jlcjak/neurband/README.md

# neurband

**An open, minimal sEMG wristband, like the Meta Neural Band.** Eight bipolar surface-EMG channels around the
wrist, a 24-bit biopotential front end, Bluetooth LE, and a module the size of a small watch face — designed
from first principles to record data good enough to train gesture models, and cheap enough to just build.

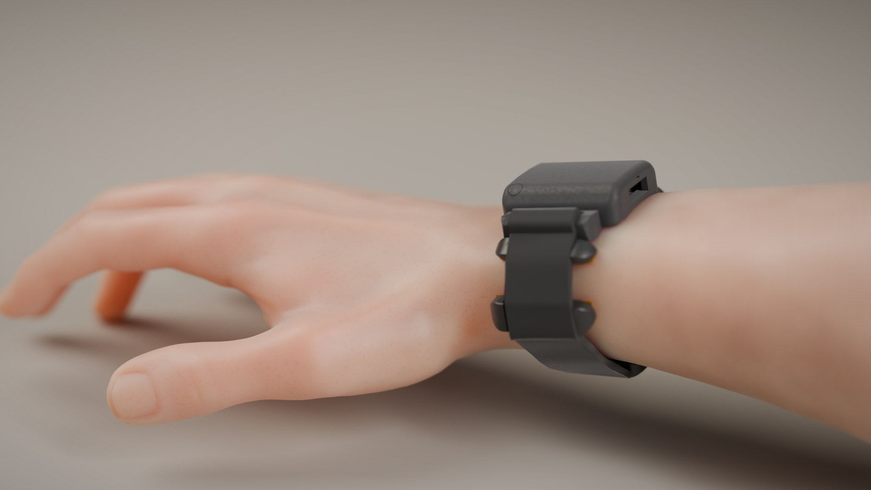
[picture p1: docs/media/hero_arm_wide_r2.jpg]
neurband on the wrist


> **Status: design complete, not yet built.** Schematics, both PCBs (DRC-clean), mechanics, firmware
> (builds and links, untested on hardware), recorder and analysis code are done; everything below that says
> "simulated" or "estimated" has not been measured on a real board yet. See [what's next](#status-and-next-steps).

| | |
|---|---|
| Channels | 8 bipolar (P–N 20 mm along the forearm) + a driven bias pad in every pod |
| Front end | TI ADS1298, 24 bit, gain 6, 4 kSPS acquisition, ~1.2 µVrms (20–850 Hz) |
| Electrodes | 24 dry 6.5 mm ENIG gold pads on a 2-layer polyimide flex, foam-backed, 1 mm proud |
| Radio | nRF52832, BLE 5 2M PHY, printed antenna; 2 kSPS × 8 ch, 16-bit stream |
| IMU | LSM6DSL accel + gyro, 208 Hz |
| Power | 401223-class LiPo, about 130 mAh, ~12 h streaming (estimate); 2-pin magnetic charging connector in the module's end wall (charge with the band off the wrist) |
| Module | 31.6 × 37.1 × 9.65 mm body (48 mm across the strap bars), tapered and crowned, one size for 145–180 mm wrists |
| Strap | 20 mm hook-and-loop watch strap through two thick bars moulded into the base; the electrode pods snap onto it |
| Cost | ≈ $290–350 for a first build: 5 boards (2 assembled), 5 flexes, prints and off-the-shelf parts ([breakdown](docs/rev_c/cost.md)) |

## Gallery

| | |
|---|---|
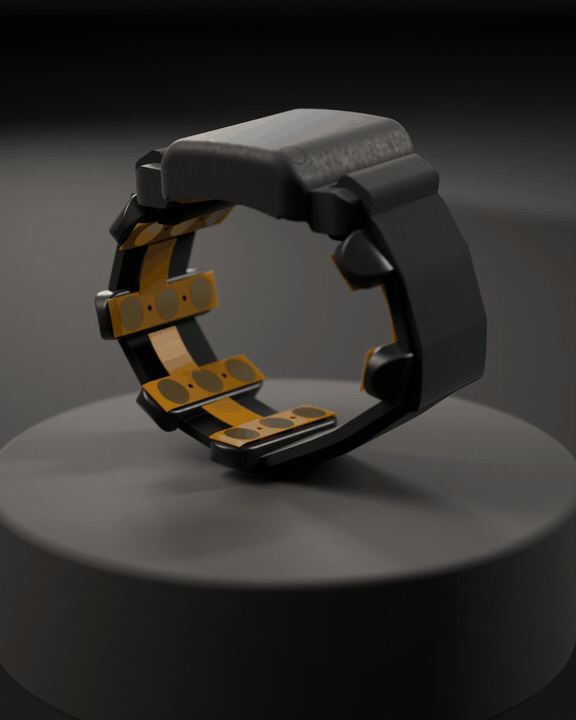
[picture p2: docs/media/turntable_r2.gif]
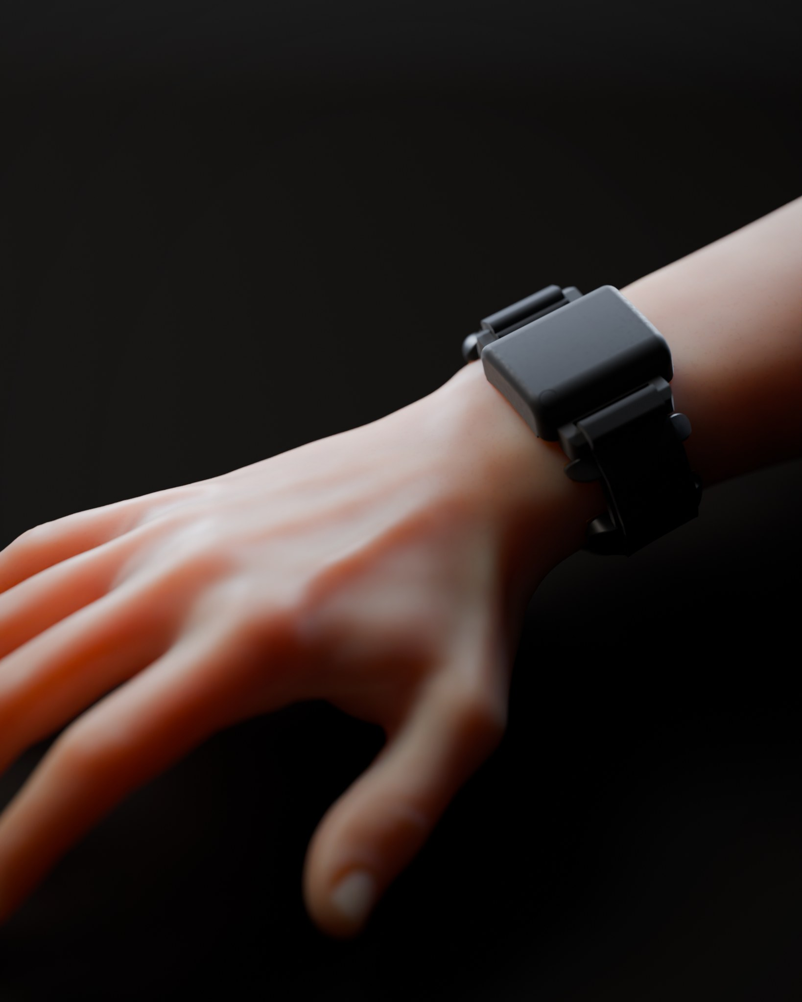
[picture p3: docs/media/hero_dark_r2.jpg]
|  |  |
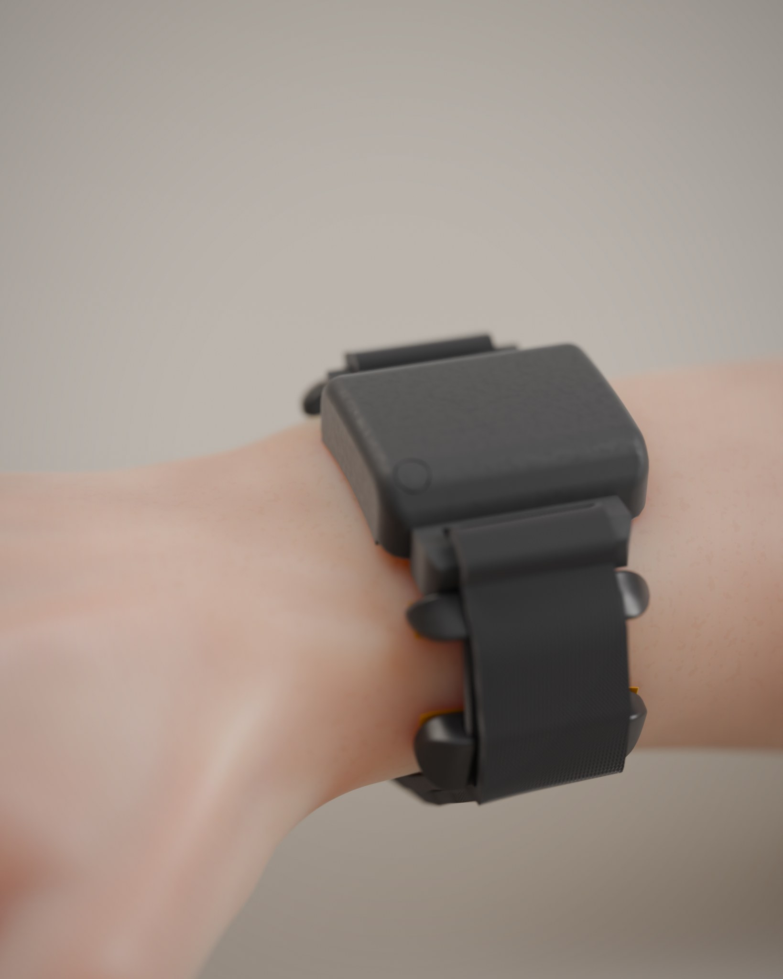
[picture p4: docs/media/hero_crop_r2.jpg]
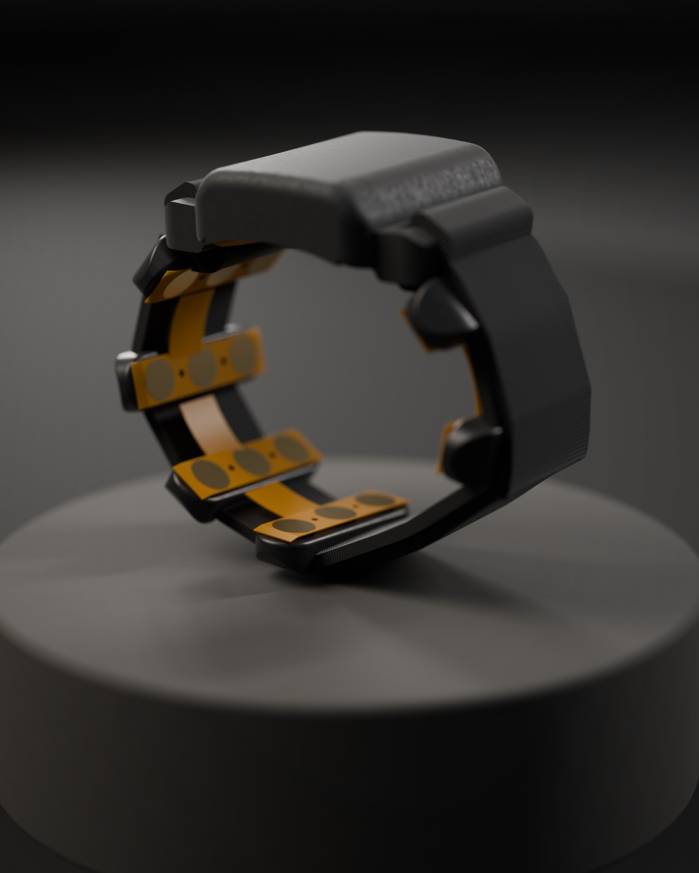
[picture p5: docs/media/band_product_r2.jpg]
|  |  |
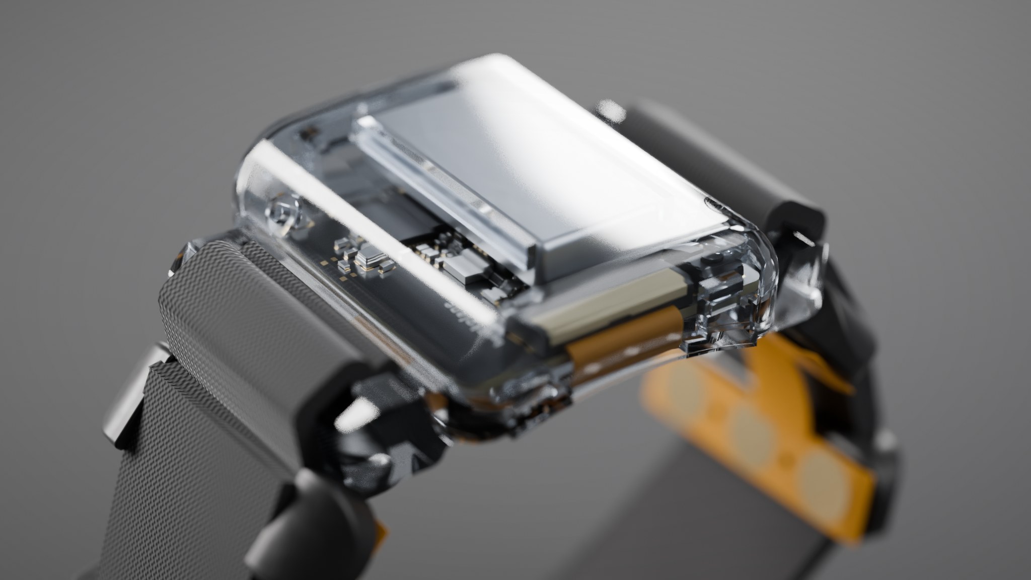
[picture p6: docs/media/xray_r2.jpg]
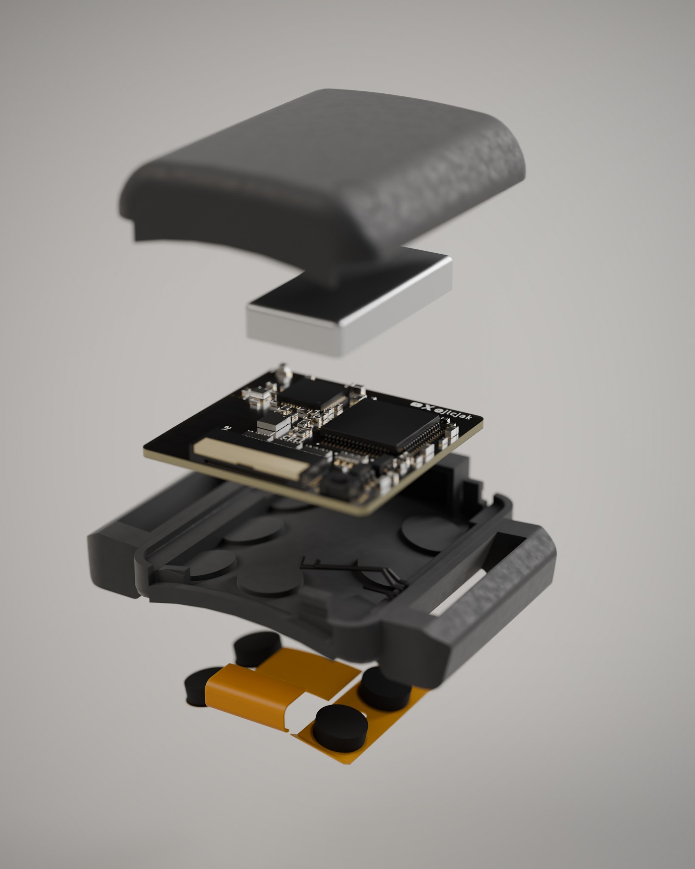
[picture p7: docs/media/exploded_r2.jpg]
|  |  |
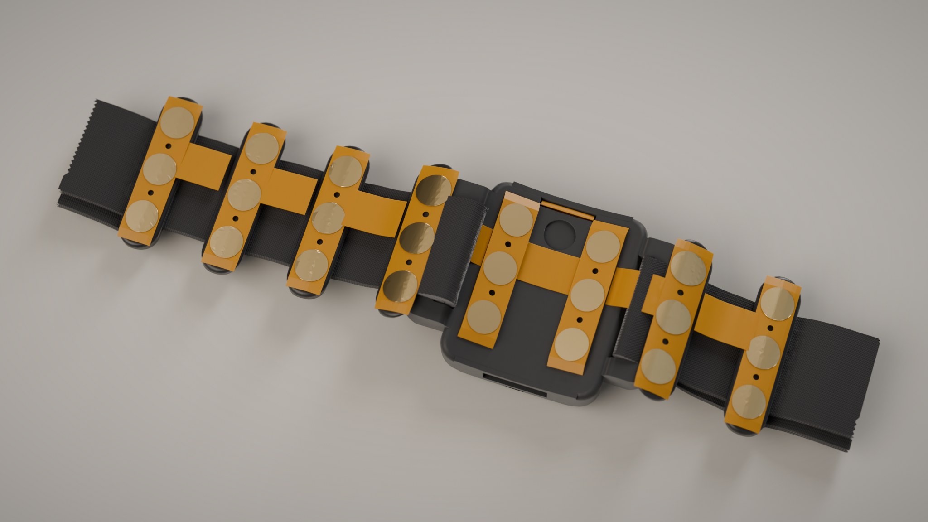
[picture p8: docs/media/flatlay_r2.jpg]
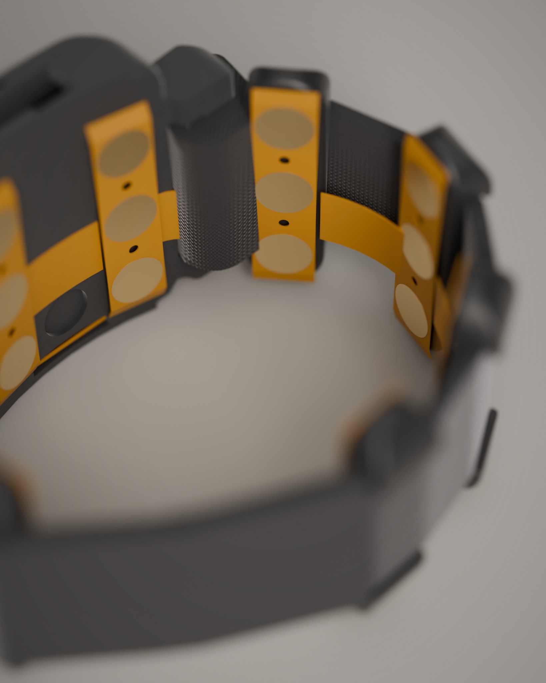
[picture p9: docs/media/pods_inside_r2.jpg]
|  |  |
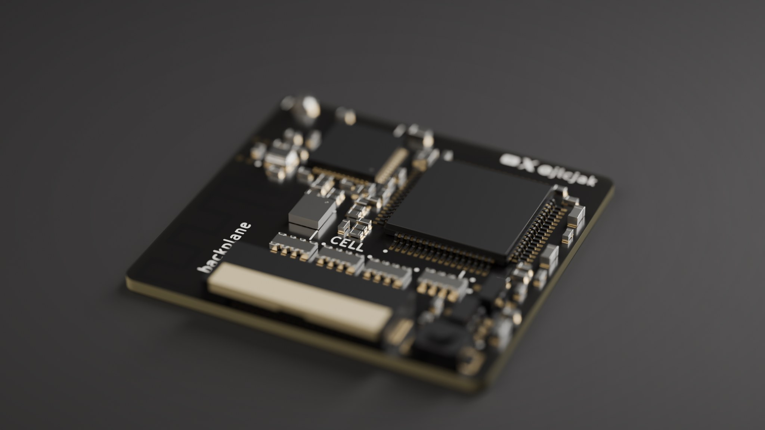
[picture p10: docs/media/pcb_top_r2.jpg]
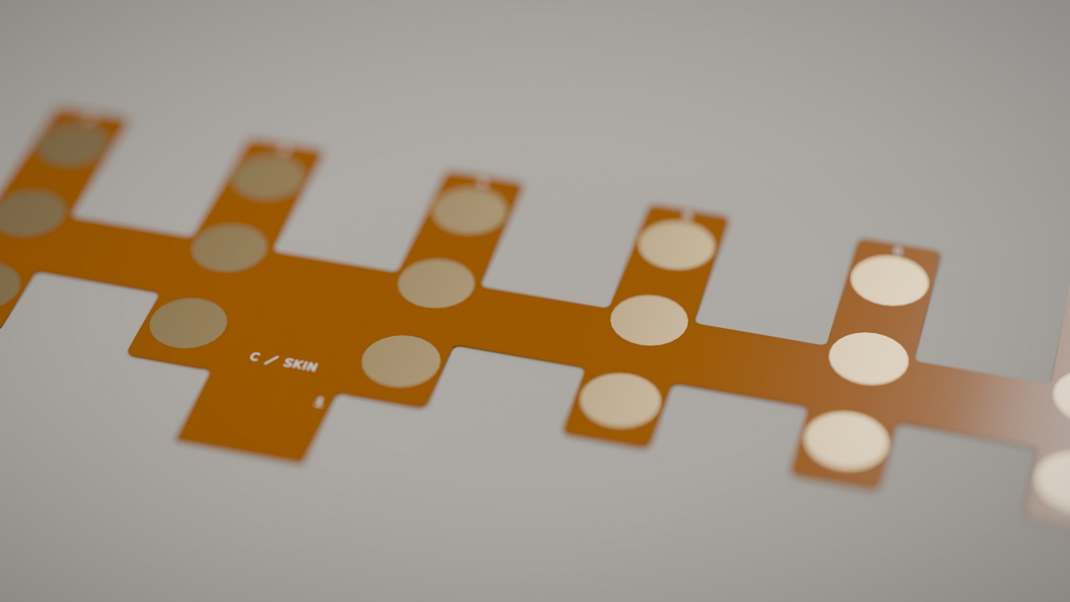
[picture p11: docs/media/flex_detail_r2.jpg]
|  |  |

The boards as laid out (KiCad renders, main board top and bottom; 28.7 × 27 mm):

| | |
|---|---|
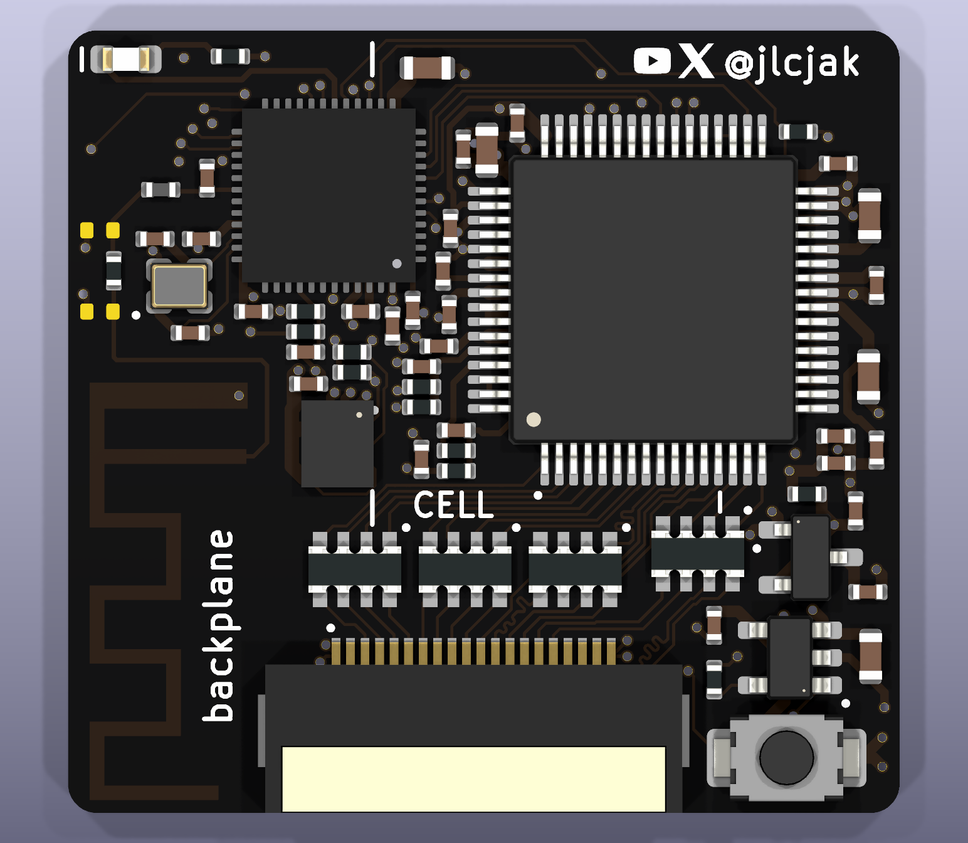
[picture p12: docs/media/board_top_r2.png]
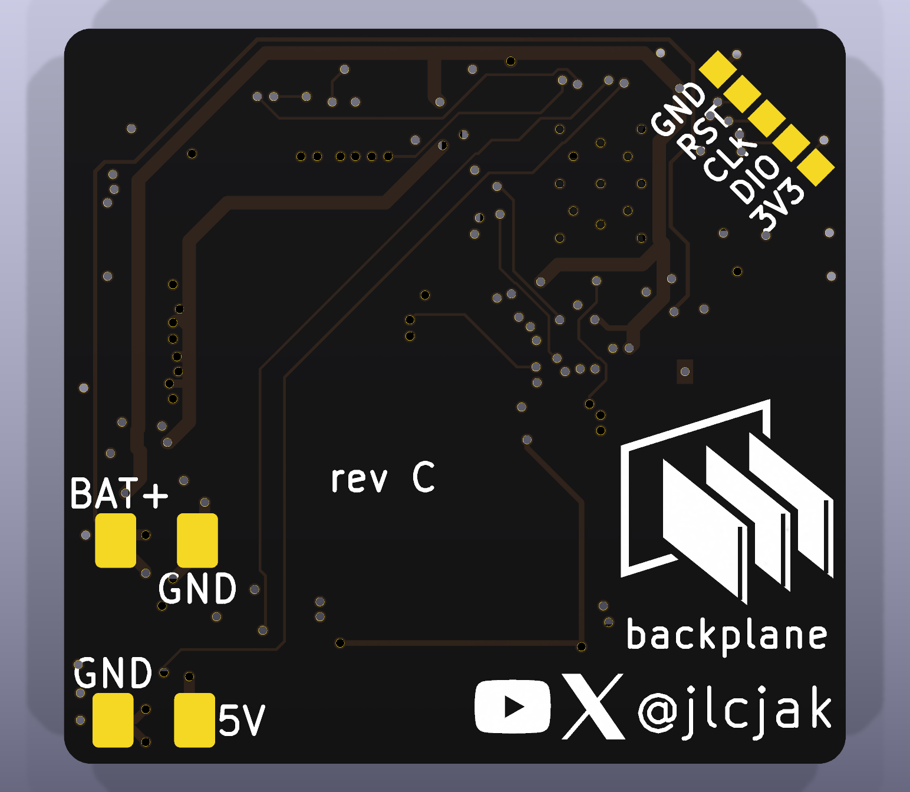
[picture p13: docs/media/board_bottom_r2.png]
|  |  |

All four copper layers (`python3 tools/copper_layers.py`):

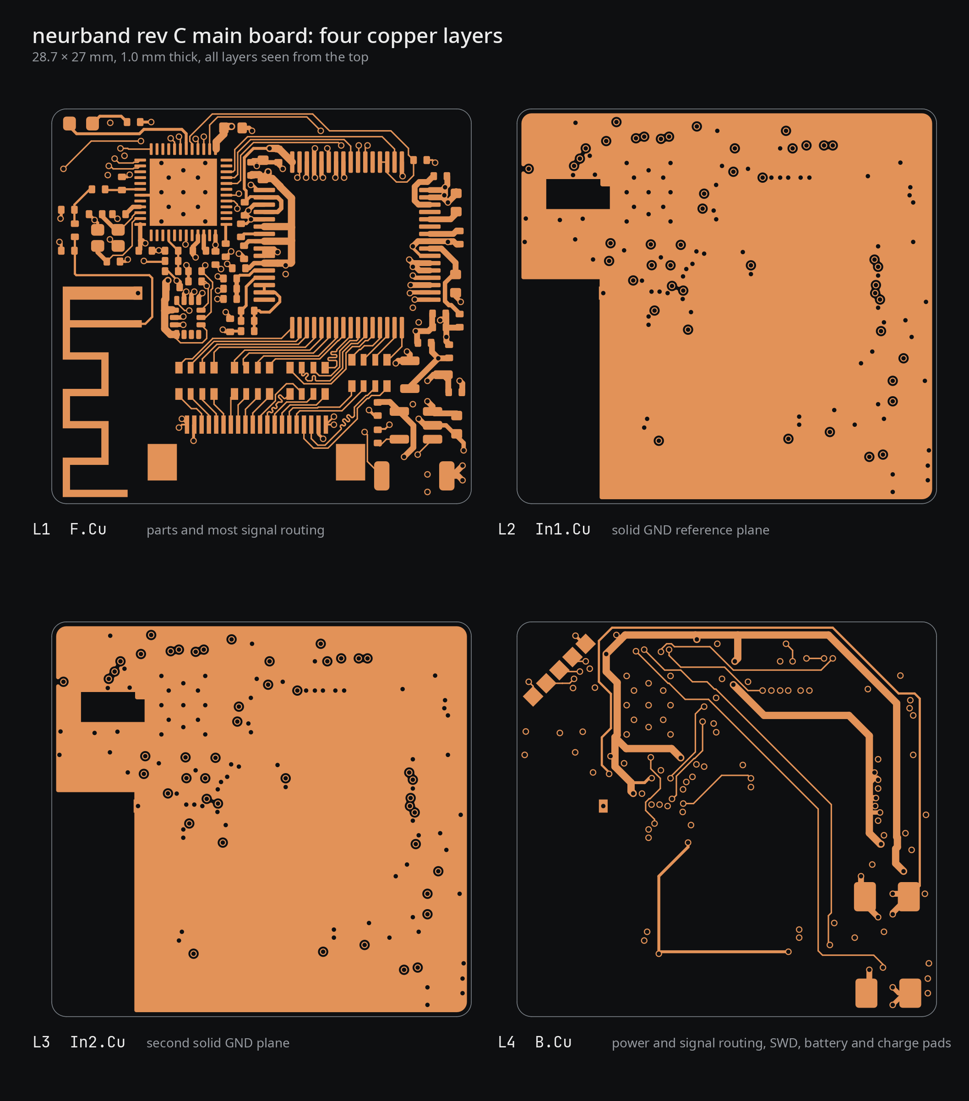
[picture p14: docs/media/board_layers_r2.png]
four copper layers of the main board


A 1080 × 1350 turntable video is in [docs/media/turntable_r2.mp4](docs/media/turntable_r2.mp4).
All images are rendered from the real CAD and KiCad files with `python3 render/make_renders.py` (Blender Cycles);
see [docs/renders.md](docs/renders.md).

## How it works

```
 skin ─ 8 pods × (P, bias, N) gold pads ─ polyimide flex (GND-shielded) ─ 20-pin FPC
   └─ main board 28.7 × 27 mm, 4 layers, one-sided assembly
        ADS1298 ─ 16 × 10 kΩ inputs, bias amp (1 MΩ‖4.7 nF → all middle pads), filtered AVDD/2 reference
          │ SPI
        nRF52832 ─ printed 2.4 GHz antenna ─ BLE ─► nRF52840 USB dongle ─► host/neurband_ble.py ─► .npz
          ├ LSM6DSL IMU, button (wake/marker), LED
        LiPo ─ XC6206 3.3 V ─ RC filter ─ AVDD          magnetic charge connector ─ TP4054
```

Like Meta's research band (*A generic non-invasive neuromotor interface for
human-computer interaction*, Nature 2025), it has what matters: bipolar gold contacts 20 mm apart along the forearm, µV-level noise,
2 kHz data. It drops what only costs money: per-pod amplifiers, 16 channels, custom electrodes.
The reasoning, decision by decision, is in [docs/rev_c/README.md](docs/rev_c/README.md).

## The science, checked before building

Four independent reviews and simulations went into this design:

- **Signal chain** ([docs/science/signal_chain.md](docs/science/signal_chain.md)): noise budget, dry-contact
  impedance, mains pickup, sampling and BLE throughput, with pass/fail bench gates.
- **Circuit simulation** ([docs/science/simulations.md](docs/science/simulations.md), ngspice): bias-loop
  stability (57° worst-case phase margin), mains residual (≤ 1.5 µV on battery), RF filtering, radio-burst
  coupling — which is why the bias reference is filtered.
- **Forearm volume-conductor model** ([docs/science/emg_forward_model.md](docs/science/emg_forward_model.md)):
  a 3-D finite-difference model of the distal forearm (bones, muscles, fat, skin, anisotropic muscle), lead
  fields of all 8 channels, travelling motor-unit action potentials. 8 channels separate single muscles at
  98–100 %; pad size, spacing and band rotation are quantified.
- **Data & models** ([docs/science/data_and_models.md](docs/science/data_and_models.md)): what 8-channel wrist
  EMG can decode, how to use Meta's open datasets, a first-week recording protocol, and a working pipeline.

| | |
|---|---|
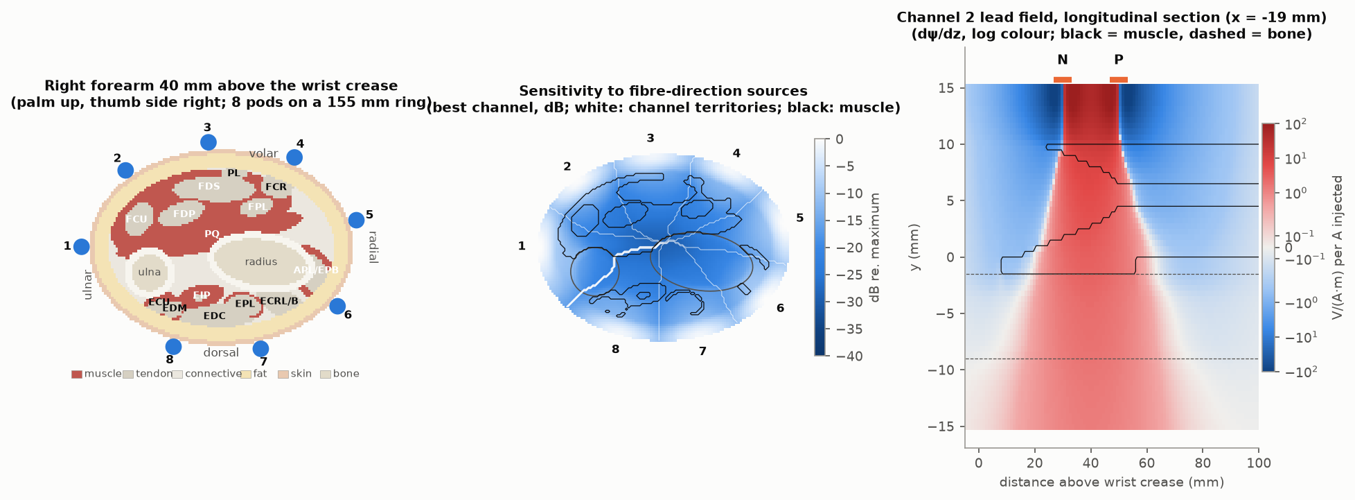
[picture p15: docs/science/figures/emgfwd_cross_section.png]
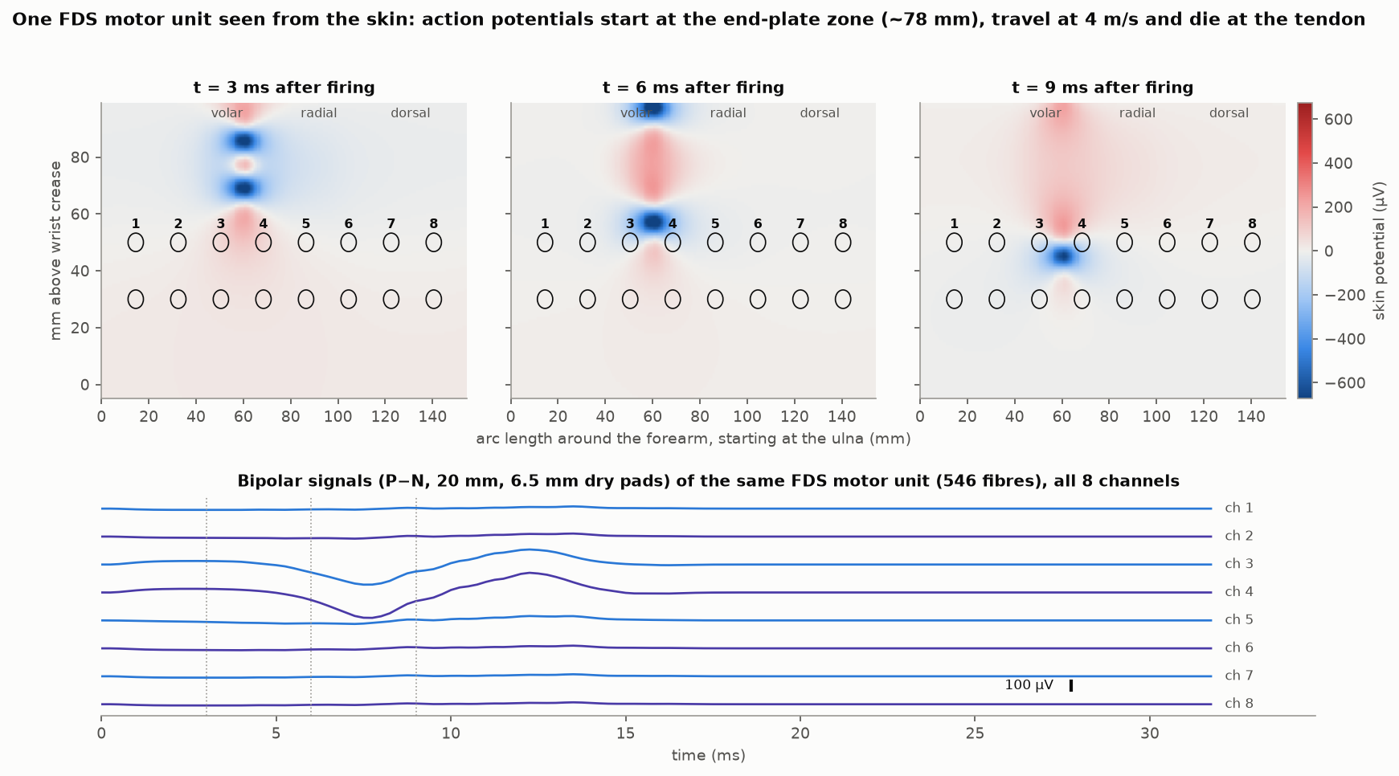
[picture p16: docs/science/figures/emgfwd_skin_map.png]
|  |  |

**Honest expectations** (per user, with calibration): 6–8 hand/wrist postures at ~90–98 %, pinches and thumb
swipes at ~75–90 %, 2-axis wrist control. Not expected: models that work across people without calibration,
typing, fluent handwriting.

## Build one

**Build guide: [docs/build/assembly.md](docs/build/assembly.md)**: the shopping list, the prints, ten
illustrated steps, troubleshooting and the tests to run on a first band (also as a
[PDF](docs/build/neurband_build_manual.pdf)). There is also a 36 s
[assembly animation](docs/media/assembly_r2.mp4).

A first prototype costs around $300 (≈ $290–350 for five main boards with two assembled, five electrode flexes,
the prints and the off-the-shelf parts; [breakdown](docs/rev_c/cost.md)). Most of it is the ADS1298 and the
fab's assembly fees.

1. **Order** two things:
   - the assembled main board, the electrode flex and the prints, with **Buy it** in Backplane
     (`boards/neurband_c/ORDERING.md`, `boards/neurband_c_flex/ORDERING.md`, `mech/rev_c/*.fab.json`);
   - about EUR 75 of off-the-shelf parts ([docs/build/sourcing.md](docs/build/sourcing.md)): a 20 mm
     hook-and-loop watch strap, 6 mm foam dots, a 401223 LiPo, a 2-pin magnetic charging connector and
     cable, a Pico 2 as the SWD probe and an nRF52840 dongle.
2. **Build** it ([docs/build/assembly.md](docs/build/assembly.md), PDF alongside):
   - flash the bare board once through four soldered wires on the SWD pads (3V3, SWDIO, SWDCLK, GND);
   - solder the cell and the charging connector;
   - bond the six free pods in the flat jig and the base in the pedestal jig;
   - fold the tail into J1 and close the module;
   - snap the strap into the pods, lock one end on bar A, tighten through bar B.

   Design details are in [docs/mech/mechanical_c.md](docs/mech/mechanical_c.md).
3. **Record**: `python3 host/neurband_ble.py -o rec.npz`, and in a second terminal
   `python3 -m analysis collect basic --out data/s1`.
4. **Check and train**: `python3 -m analysis report data/*.npz`, `python3 -m analysis train data/*.npz`.
   Try the whole pipeline without hardware: `python3 -m analysis synth /tmp/nb`.

**Safety.** Wear it only while it runs on its own battery. Never connect a charger, USB cable, debugger or
grounded instrument while the pads touch skin. This is a research prototype, not a medical device.

## Repository

| Path | What |
|---|---|
| `boards/neurband_c/` | main board: schematic generator (`gen_c_sch.py`), KiCad project, layout scripts |
| `boards/neurband_c_flex/` | electrode flex: schematic + parametric PCB generator |
| `mech/rev_c/` | FreeCAD scripts and STEP for the module, pods, strap path, bonding jigs and fit checks |
| `firmware_c/` | nRF52832 Zephyr firmware |
| `host/` | BLE recorder and packet tests |
| `analysis/` | quality gates, features, baseline models, collection prompts, Meta dataset reader |
| `sim/` | ngspice AFE simulations and the forearm EMG forward model |
| `render/` | Blender pipeline for the images (`python3 render/make_renders.py`) |
| `docs/` | design notes, reviews, science, layout and mechanical docs |
| `.archive/` | older work (a dot-folder, so Backplane's project list skips it): rev A (16 ch, ESP32, 54 × 34 mm) and rev B boards, rev A/B mechanics, the rev C layout scripts |
| `tools/` | the small Python KiCad schematic generator used for every schematic |

## Status and next steps

- [x] Rev C schematic, main board (DRC 0), flex (DRC 0), mechanics, fit checks on 145/160/180 mm wrists
- [x] Firmware builds and links for the nRF52832 (Zephyr 4.4.2, 0 warnings, 30 % flash / 94 % RAM); host recorder and analysis pipeline tested on synthetic data
- [x] Pre-order review and rework: analog coupling/noise ([analog_preorder_review.md](docs/review/analog_preorder_review.md)), on-wrist antenna FDTD simulation ([antenna_sim.md](docs/science/antenna_sim.md)), manufacturing and pick-and-place check against the fab's own footprints ([manufacturing_preorder.md](docs/review/manufacturing_preorder.md)), layout owner's review ([sol_preorder_review.md](docs/review/sol_preorder_review.md)), assembly walk-through ([assembly.md](docs/build/assembly.md))
- [ ] Build two boards; bench gates: shorted-input noise, mains residual, radio-on noise, bias-loop stability
- [ ] Antenna tuning (π network on the board), BLE throughput on a real link
- [ ] First week of recordings with the protocol in `docs/science/data_and_models.md`

## Credits

Research summary of Meta's work in [docs/research/meta_semg_research.md](docs/research/meta_semg_research.md).
Human model: Blender Studio "Human Base Meshes" (CC0). KiCad stock libraries. Meta's datasets referenced here are
CC BY-NC 4.0.
