jlcjak/neurband/boards/neurband_c_flex/README.md

# Electrode flex, rev C

| File | What it is |
|---|---|
| `neurband_c_flex.kicad_pro` / `.kicad_pcb` / `.kicad_sch` | The KiCad project (generated) |
| `gen_flex_c_pcb.py`, `gen_flex_c_sch.py`, `flex_pinmap.py`, `requirements.txt` | The generators and the pod-to-finger map; edit these, not the board |
| `ORDERING.md` | What the flex order must be (ordered with **Buy it**; `neurband_c_flex.fab.json` is `kind: flex`) |
| `neurband_c_flex.step`, `renders/` | 3D model and images |
| `neurband_c_flex.pretty`, `.kicad_dru`, `fp-lib-table` | Footprints and design rules the board needs |

Layout notes: [docs/layout/flex_c_layout.md](../../docs/layout/flex_c_layout.md).
