jlcjak/neurband/boards/neurband_c_old/README.md

# Main board rev C, routed by the layout owner (reference copy)

The routed, reviewed rev C main board (SHA-256 `ff1ad4d2…35b6`) kept for reference while
`boards/neurband_c` is re-routed by hand. Same schematic, placement and footprints. Not for ordering
(no fab file); the reviews in `docs/review/` and `docs/layout/main_c_layout.md` describe this board.
