jlcjak/neurband/.archive/neurband_main_revA/layout/esp_footprint_review.md

# ESP32-S3-MINI-1-N8 footprint review

## Result

The installed `RF_Module:ESP32-S2-MINI-1` has the correct S3 pad geometry and numbering, but is **not an exact mechanical/antenna match**. Its fabricated body is 15.4 × 20.0 mm, whereas ESP32-S3-MINI-1-N8 is 15.4 × 20.5 × 2.4 mm (body XY tolerance ±0.2 mm). Its antenna keepout stops 0.5 mm short of a 15 mm forward clearance measured from the S3 body tip. Use the standalone `neurband.pretty/ESP32-S3-MINI-1-N8.kicad_mod` in this directory. Canonical PCB and schematic were not edited.

Source footprint inspected: `$KICAD_ROOT/share/kicad/footprints/RF_Module.pretty/ESP32-S2-MINI-1.kicad_mod`. Its description incorrectly calls this an external-antenna module; MINI-1 has an onboard PCB antenna, MINI-1U has an external connector.

## Exact local geometry

Millimetres, top view, zero footprint rotation, +X right, +Y down. Retain the stock origin and all pads; the module is not geometrically centered about this origin.

| Feature | Local coordinates / dimensions |
| --- | --- |
| S3 nominal body | X = −7.7…+7.7; Y = −10.25…+10.25 |
| Antenna area (datasheet Fig. 11-1, 5.05 mm deep) | X = −7.7…+7.7; Y = −10.25…−5.20 |
| Pads 1…15, left | X = −7; Y = −3.40 + 0.85 × (pin−1); 0.8 × 0.4 |
| Pads 16…30, bottom | X = −5.95 + 0.85 × (pin−16); Y = 9.55; 0.4 × 0.8 in XY |
| Pads 31…45, right | X = +7; Y = 8.50 − 0.85 × (pin−31); 0.8 × 0.4 |
| Pads 46…60, top | X = 5.95 − 0.85 × (pin−46); Y = −4.45; 0.4 × 0.8 in XY |
| Pad 61, exposed ground | Nine 1.2 × 1.2 islands; X ∈ {−1.65, 0, +1.65}; Y ∈ {0.90, 2.55, 4.20}; upper-left island chamfered |
| Pads 62, 63, 64, 65, ground corners | (−7, −4.45), (−7, 9.55), (+7, 9.55), (+7, −4.45); each 0.8 × 0.8 |
| All-layer antenna rule area | X = −22.70…+22.70; Y = −25.25…−5.20 |

There are **65 numbered electrical pins and 73 physical SMD pad objects**: 60 narrow perimeter pads + 4 square ground corners + 9 islands sharing number 61. This matches datasheet Figs. 3-1 and 11-1. All top-edge pins 46…60 are GND; corners 62…65 and EP 61 are also GND. Example numbering anchors: 1/2 GND, 3 3V3, 4 IO0, 45 EN. Physical compatibility does not imply S2 and S3 GPIO functions are interchangeable.
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
