jlcjak/neurband/boards/neurband_c/layout/XUNPU_FPC-05F-20PH20.png

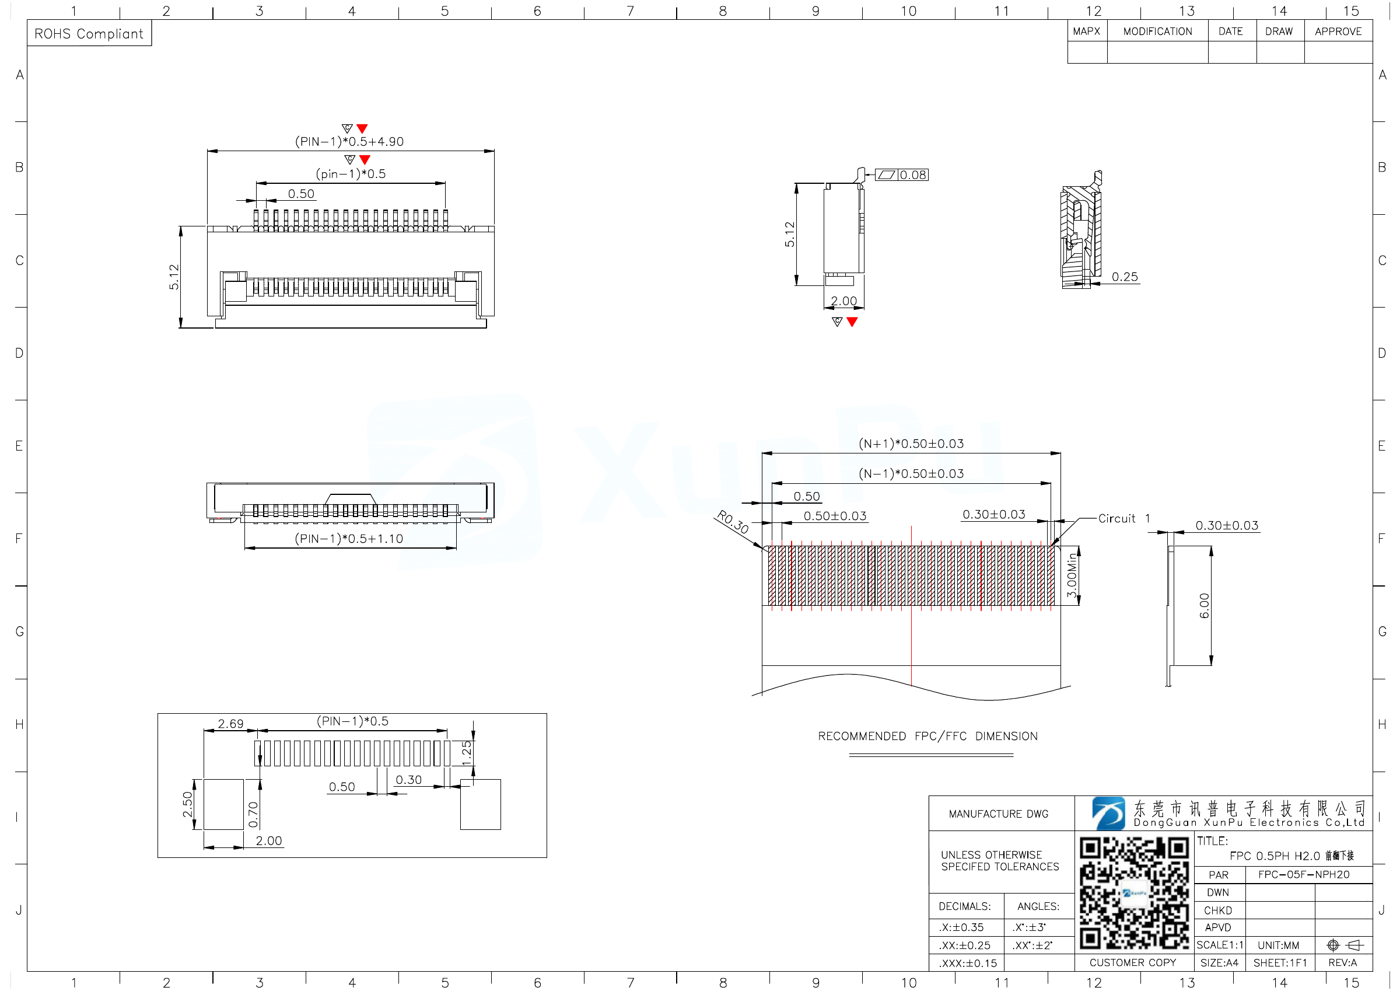
boards/neurband_c/layout/XUNPU_FPC-05F-20PH20.png
