jlcjak/neurband/boards/neurband_c/layout/XUNPU_FPC-05F-20PH20_footprint.png

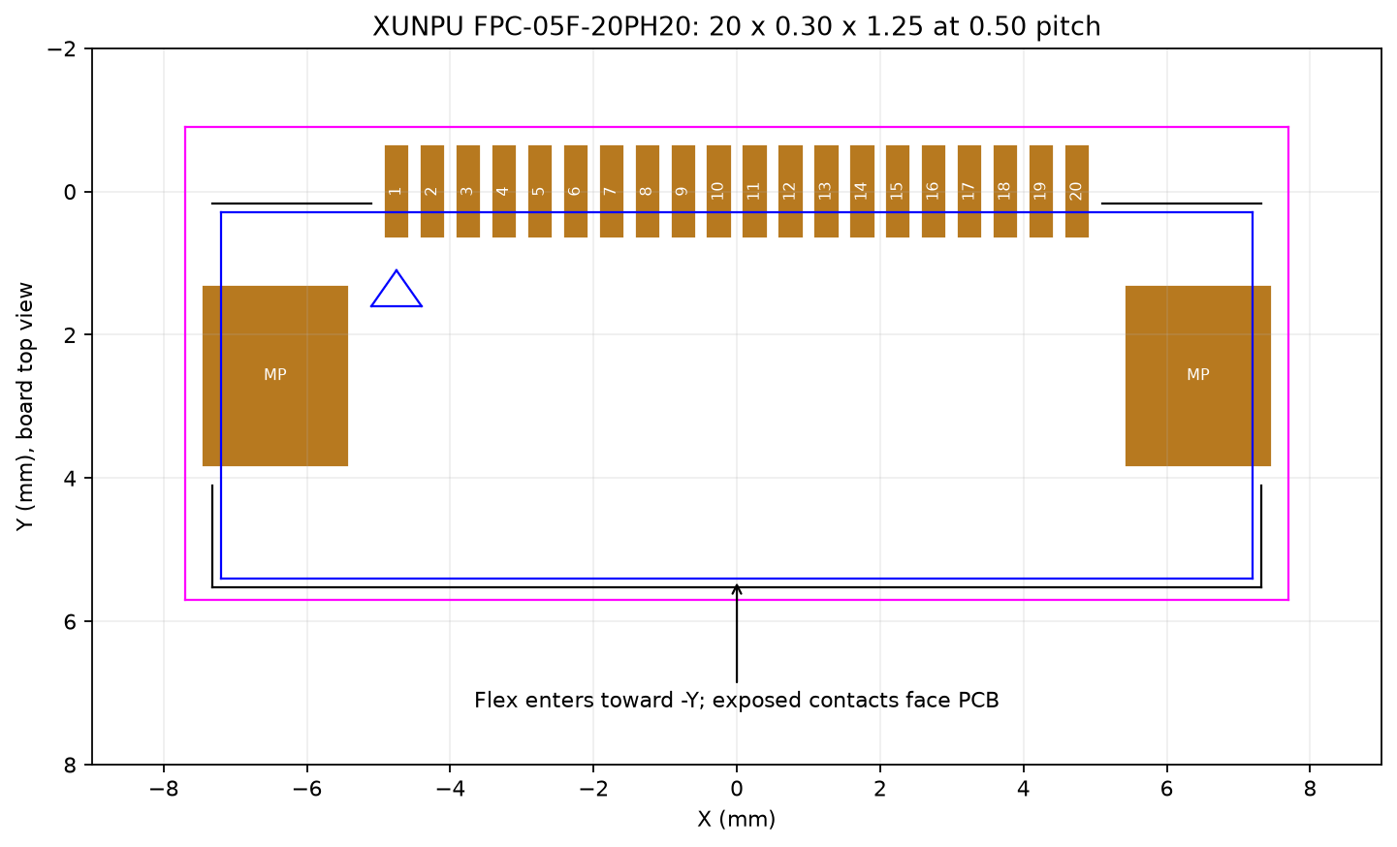
boards/neurband_c/layout/XUNPU_FPC-05F-20PH20_footprint.png
