jlcjak/neurband/boards/neurband_c/renders/3d.png

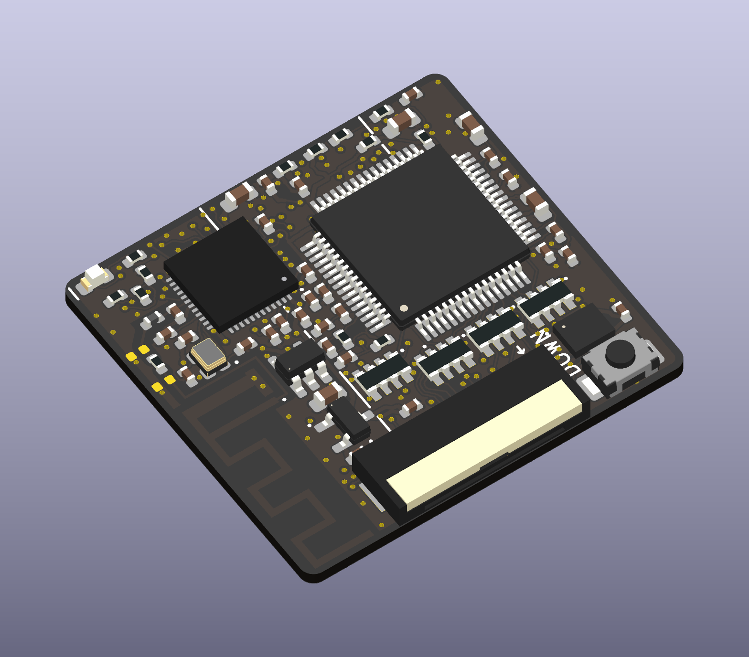
boards/neurband_c/renders/3d.png
