jlcjak/neurband/boards/neurband_c/renders/bottom.png

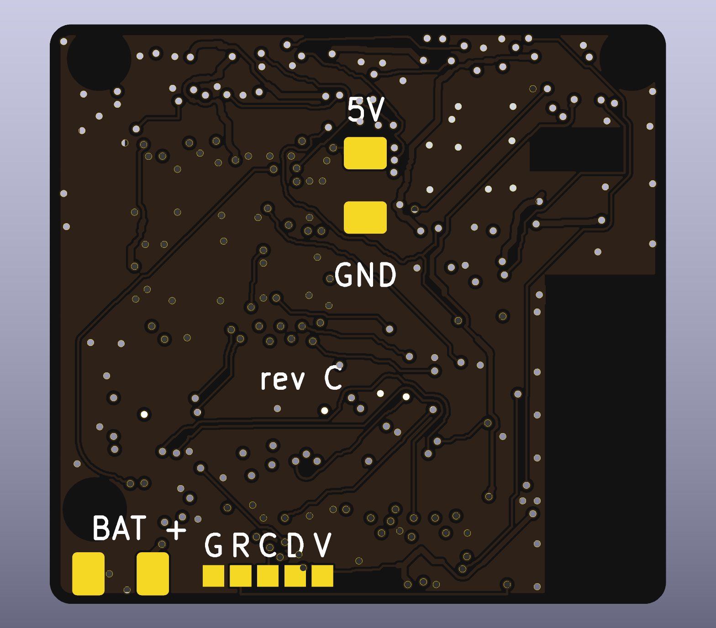
boards/neurband_c/renders/bottom.png
