jlcjak/neurband/boards/neurband_c/renders/layers/neurband_c-B_Cu.png

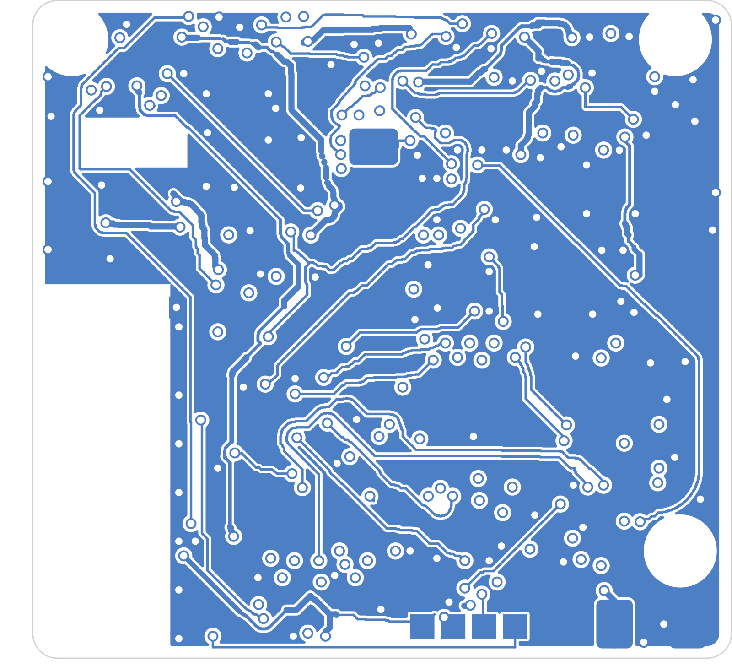
boards/neurband_c/renders/layers/neurband_c-B_Cu.png
