jlcjak/neurband/boards/neurband_c/renders/layers/neurband_c-F_Cu.png

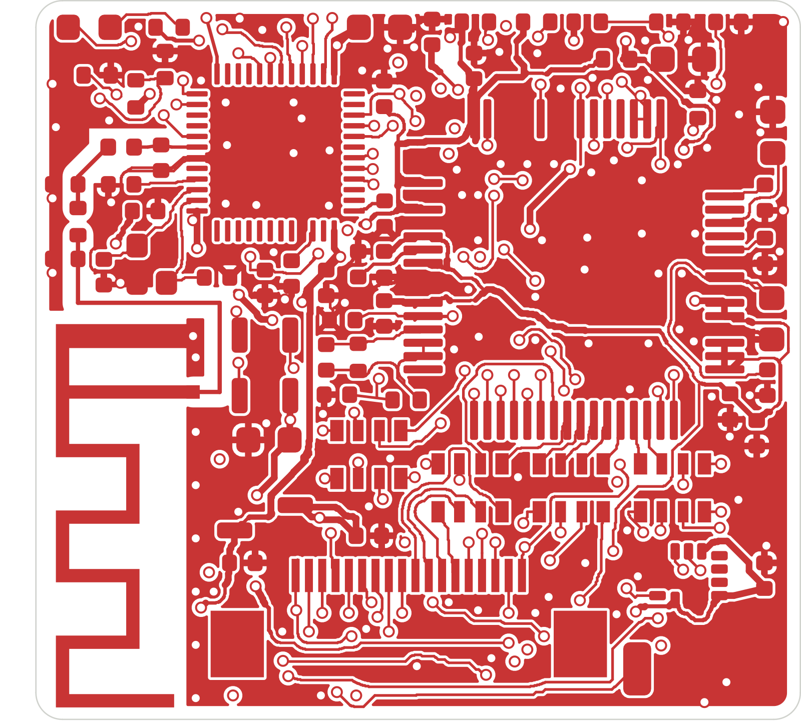
boards/neurband_c/renders/layers/neurband_c-F_Cu.png
