jlcjak/neurband/boards/neurband_c/renders/layers/neurband_c-In1_Cu.png

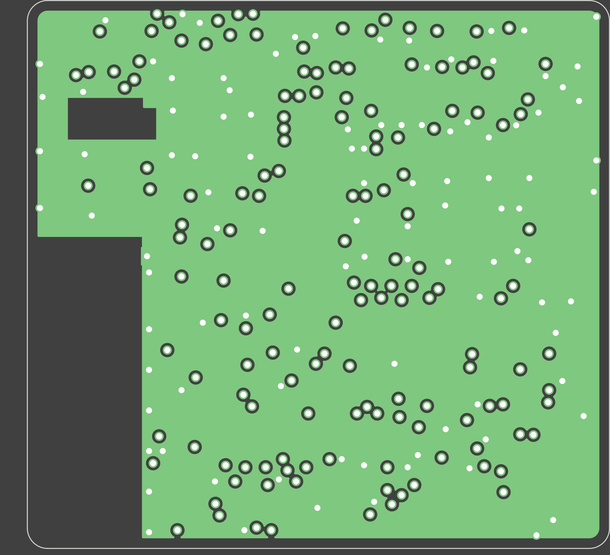
boards/neurband_c/renders/layers/neurband_c-In1_Cu.png
