jlcjak/neurband/boards/neurband_c/renders/layers/neurband_c-In2_Cu.png

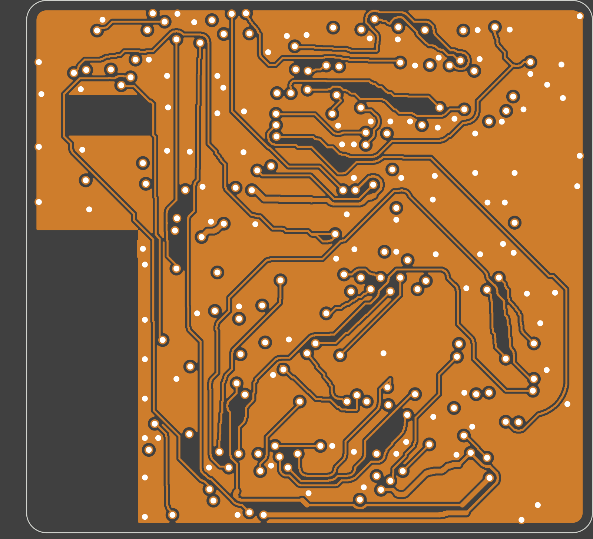
boards/neurband_c/renders/layers/neurband_c-In2_Cu.png
