jlcjak/neurband/boards/neurband_c/renders/top.png

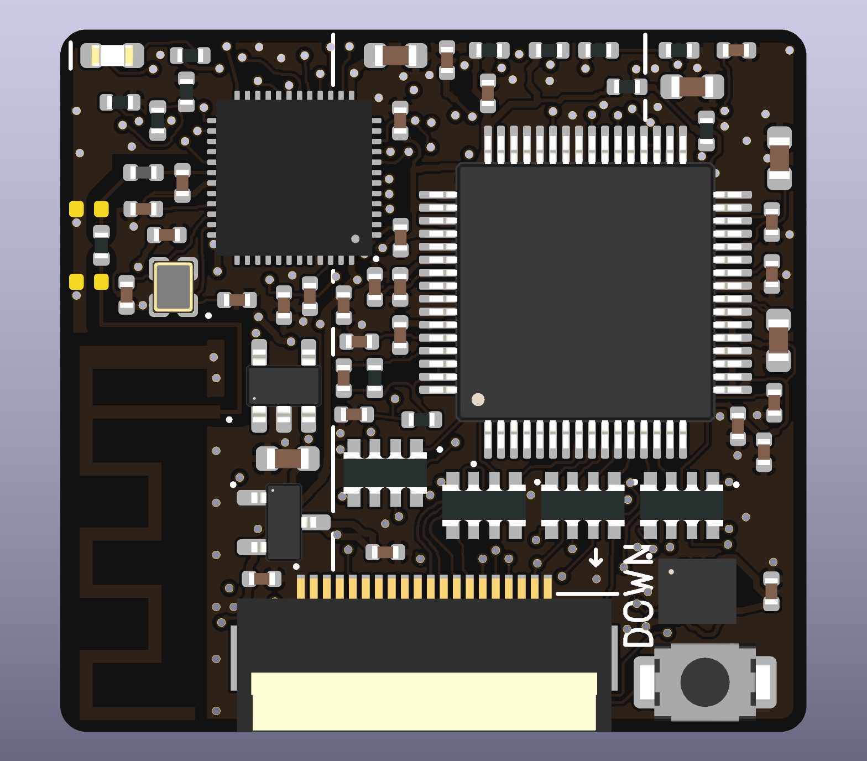
boards/neurband_c/renders/top.png
