jlcjak/neurband/boards/neurband_c_flex/renders/neurband_c_flex_bottom.png

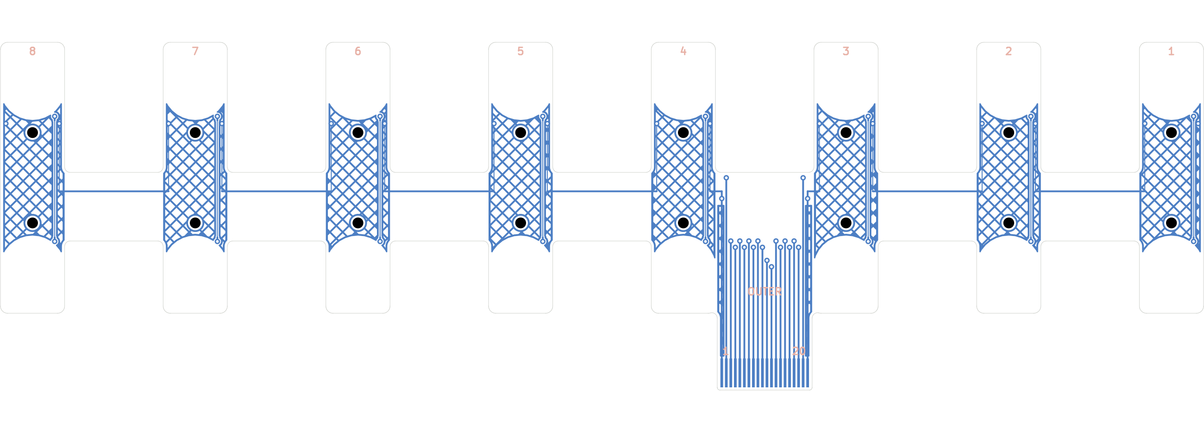
boards/neurband_c_flex/renders/neurband_c_flex_bottom.png
