jlcjak/neurband/boards/neurband_c_flex/renders/neurband_c_flex_bottom_3d.png

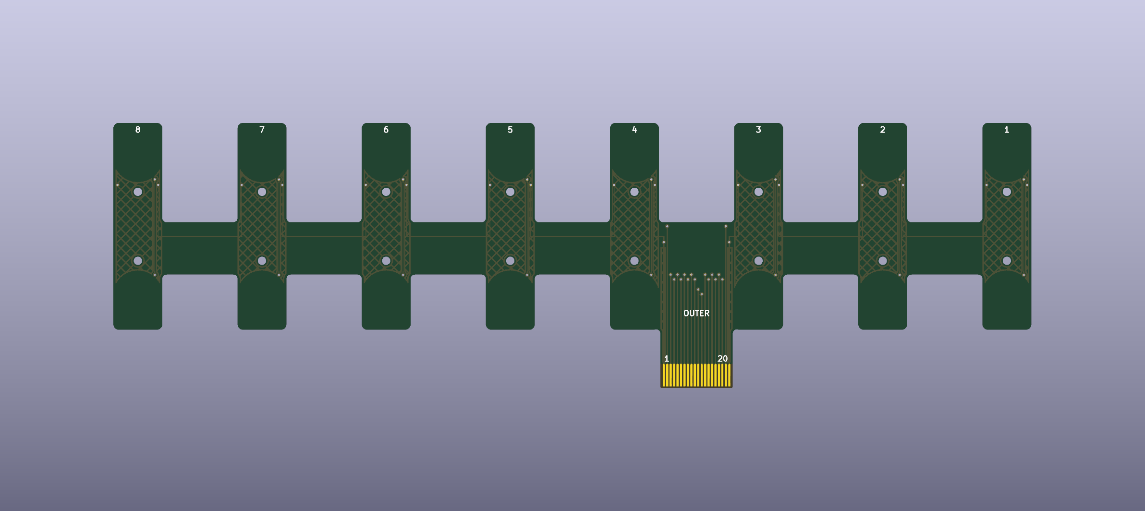
boards/neurband_c_flex/renders/neurband_c_flex_bottom_3d.png
