jlcjak/neurband/boards/neurband_c_flex/renders/neurband_c_flex_iso_3d.png

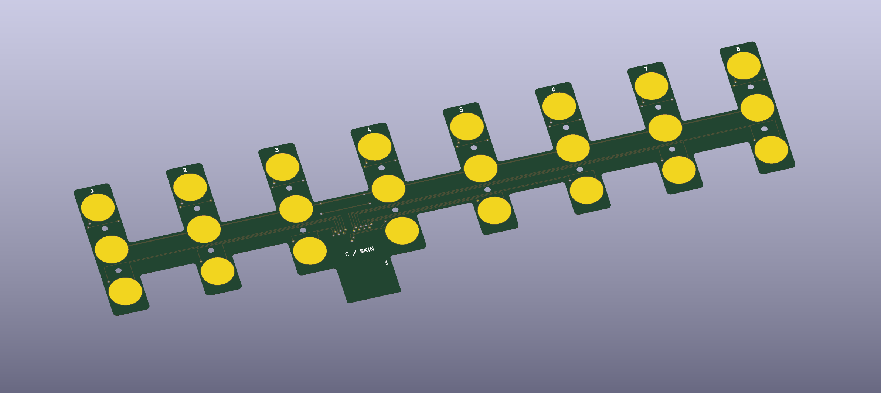
boards/neurband_c_flex/renders/neurband_c_flex_iso_3d.png
