jlcjak/neurband/boards/neurband_c_flex/renders/neurband_c_flex_top_3d.png

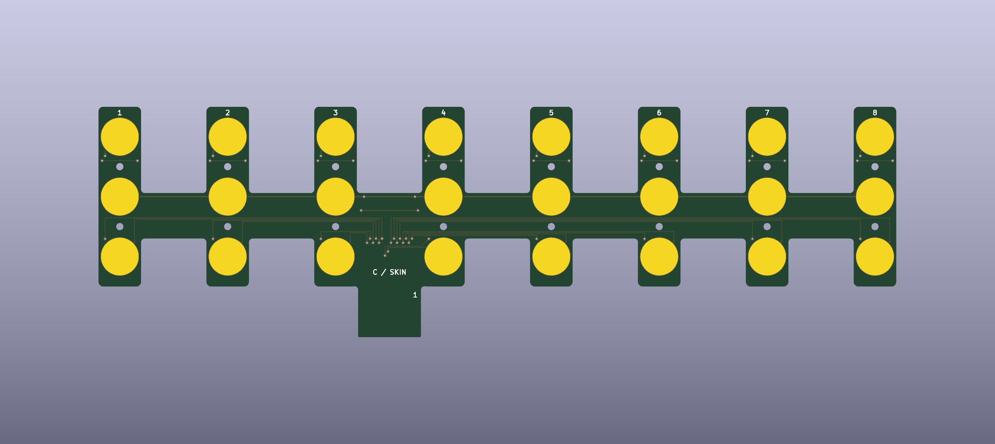
boards/neurband_c_flex/renders/neurband_c_flex_top_3d.png
