jlcjak/neurband/docs/media/arm_volar.jpg

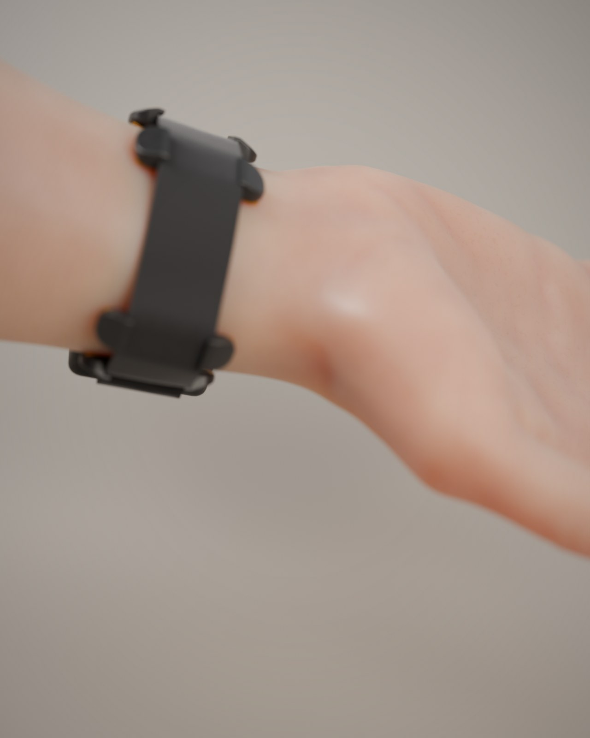
docs/media/arm_volar.jpg
