jlcjak/neurband/docs/media/band_bone.jpg

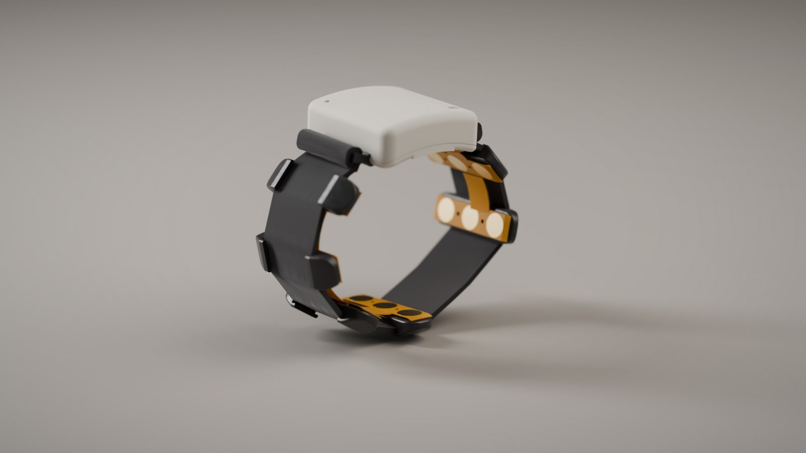
docs/media/band_bone.jpg
