jlcjak/neurband/docs/media/flatlay.jpg

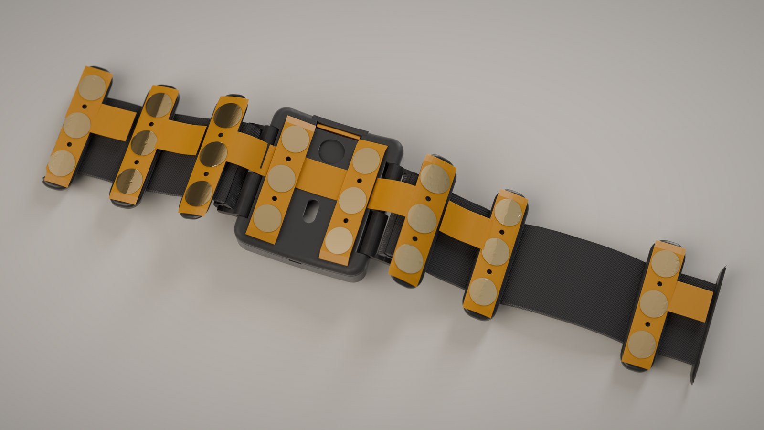
docs/media/flatlay.jpg
