jlcjak/neurband/docs/media/flex_top.png

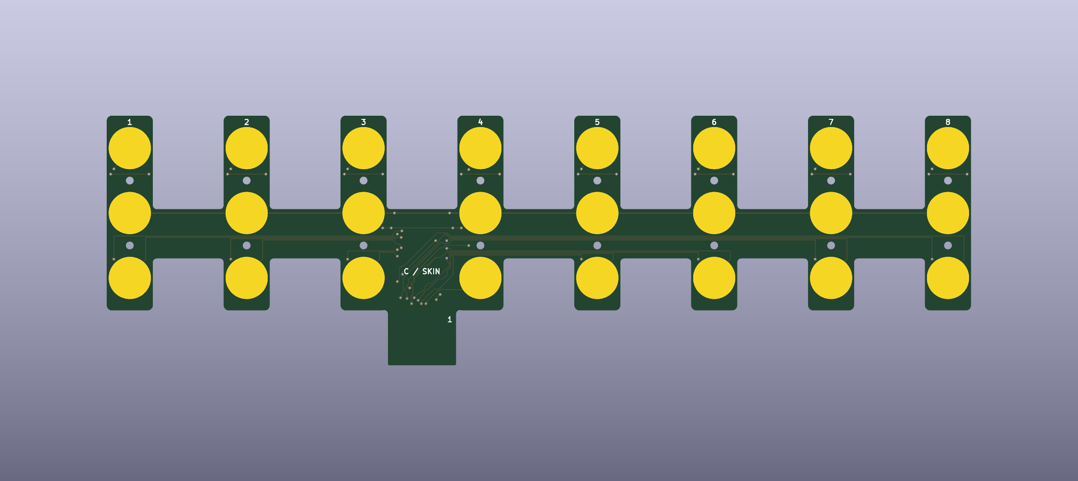
docs/media/flex_top.png
