jlcjak/neurband/docs/media/hero_arm.jpg

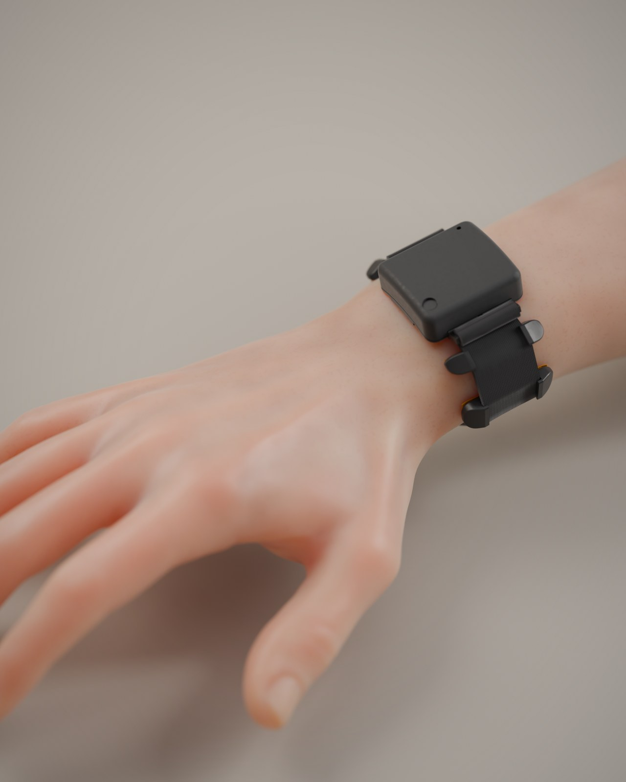
docs/media/hero_arm.jpg
