jlcjak/neurband/docs/media/hero_dark_wide.jpg

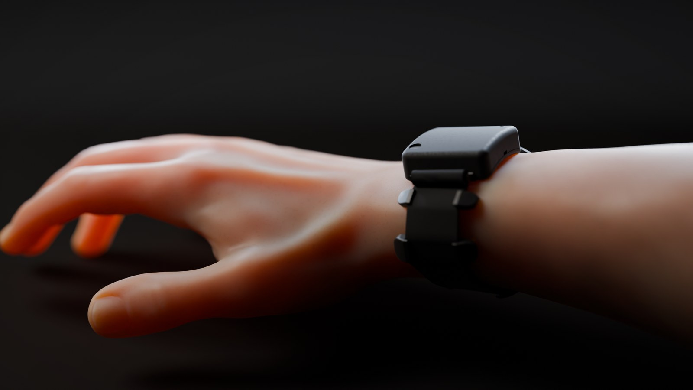
docs/media/hero_dark_wide.jpg
