jlcjak/neurband/docs/media/pcb_pair.jpg

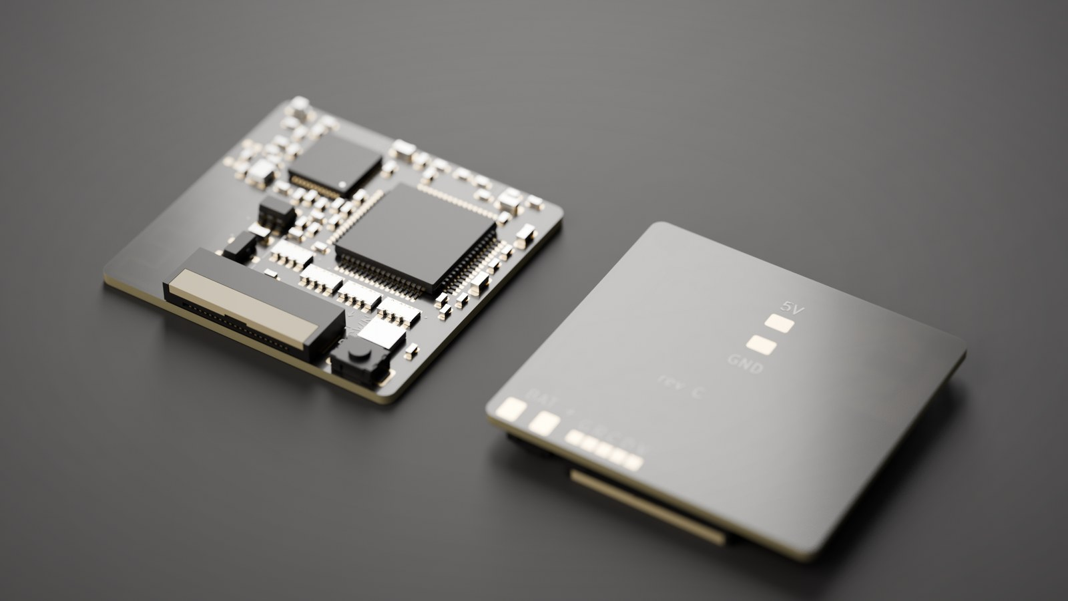
docs/media/pcb_pair.jpg
