jlcjak/neurband/docs/media/pcb_top.jpg

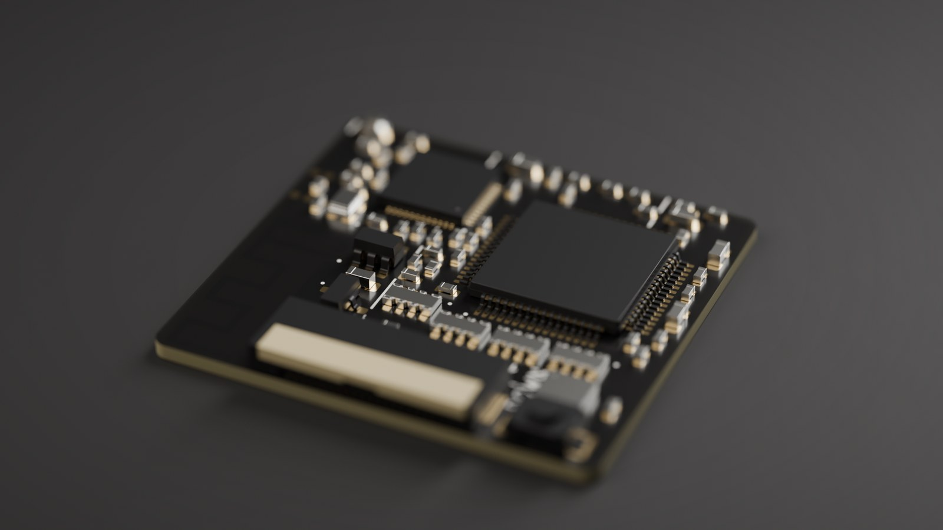
docs/media/pcb_top.jpg
