jlcjak/neurband/docs/media/pods_inside.jpg

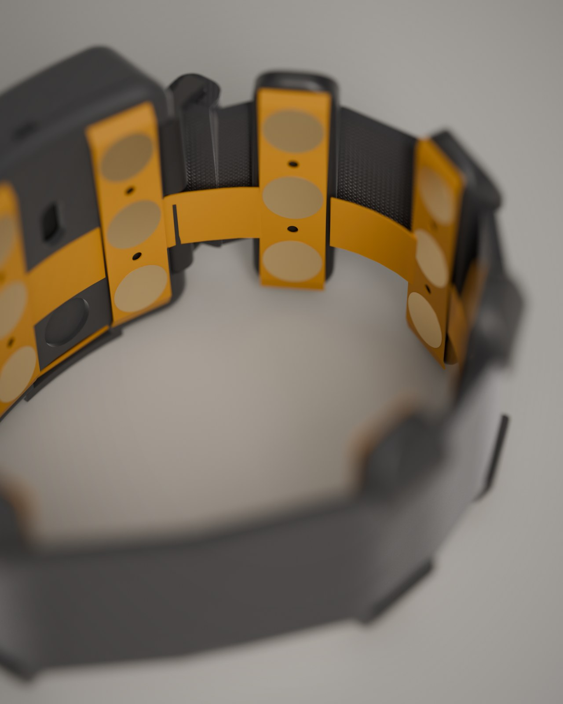
docs/media/pods_inside.jpg
