jlcjak/neurband/docs/media/turntable.gif

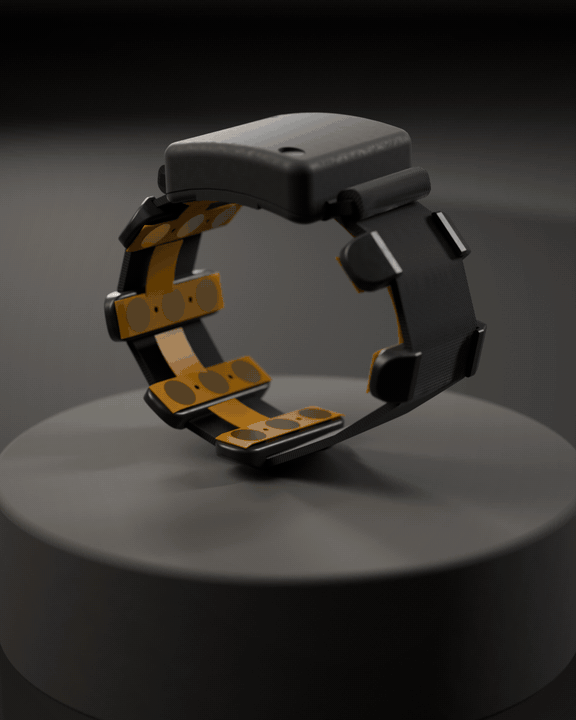
docs/media/turntable.gif
