jlcjak/neurband/docs/media/xray.jpg

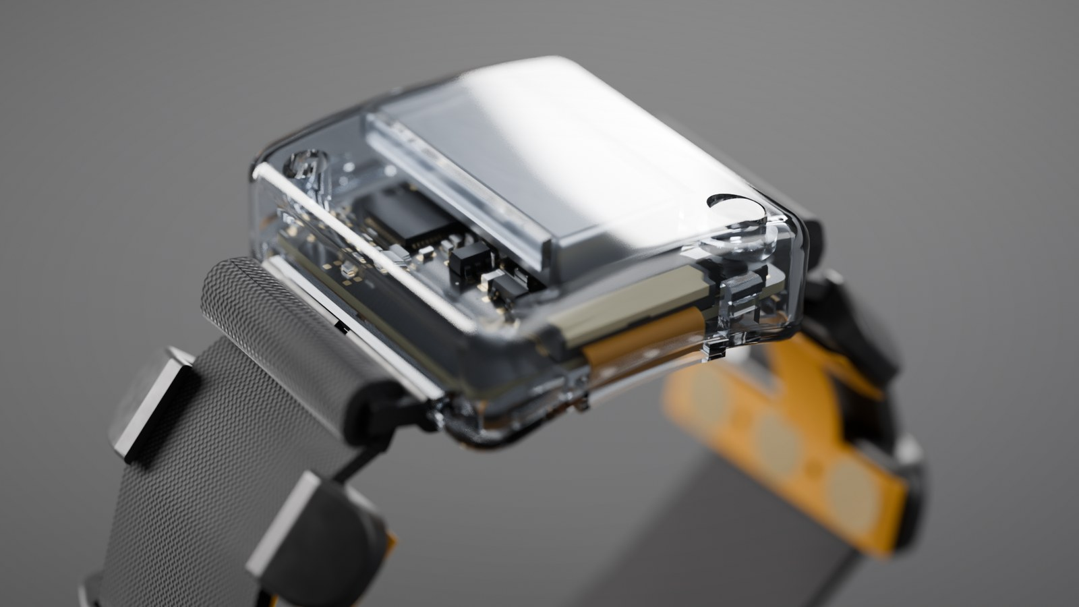
docs/media/xray.jpg
