jlcjak/neurband/docs/science/figures/emgfwd_muaps_spectra.png

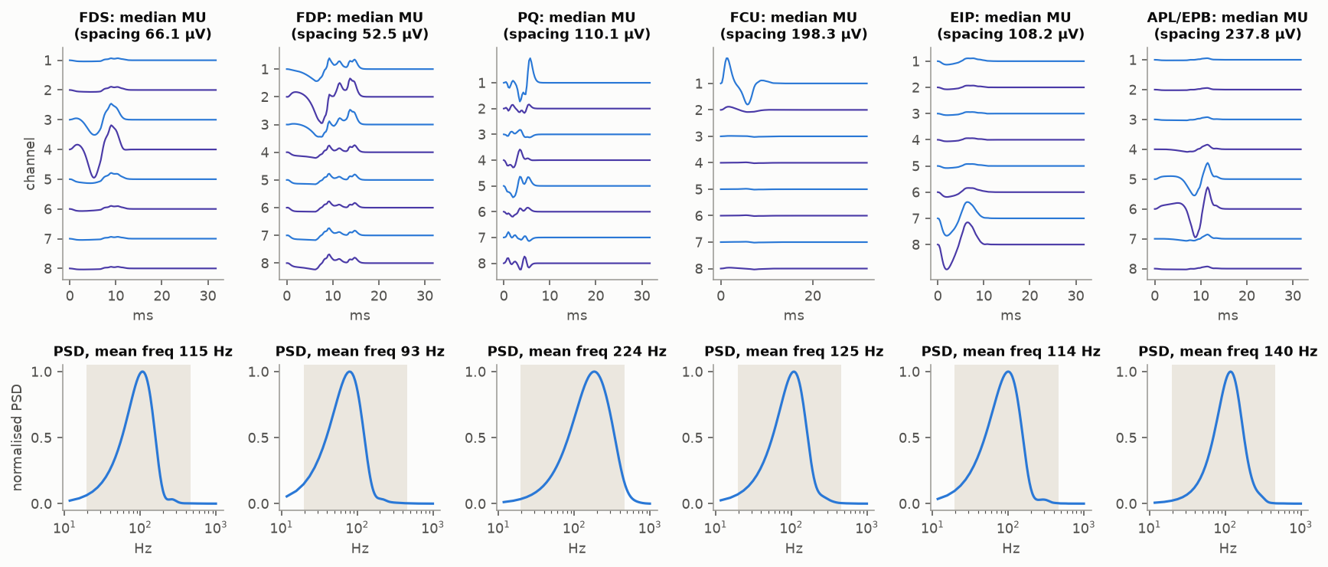
docs/science/figures/emgfwd_muaps_spectra.png
