jlcjak/neurband/extra/wrists/renders/wrist_140.front.png

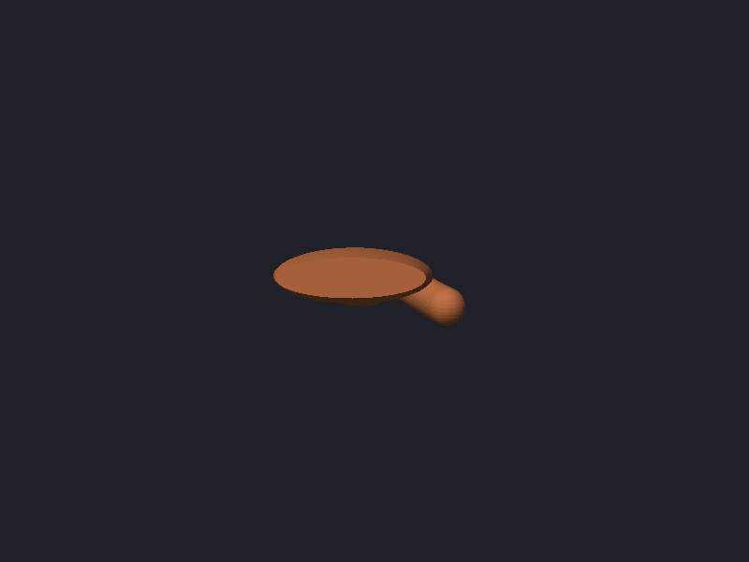
extra/wrists/renders/wrist_140.front.png
