jlcjak/neurband/extra/wrists/renders/wrist_140.right.png

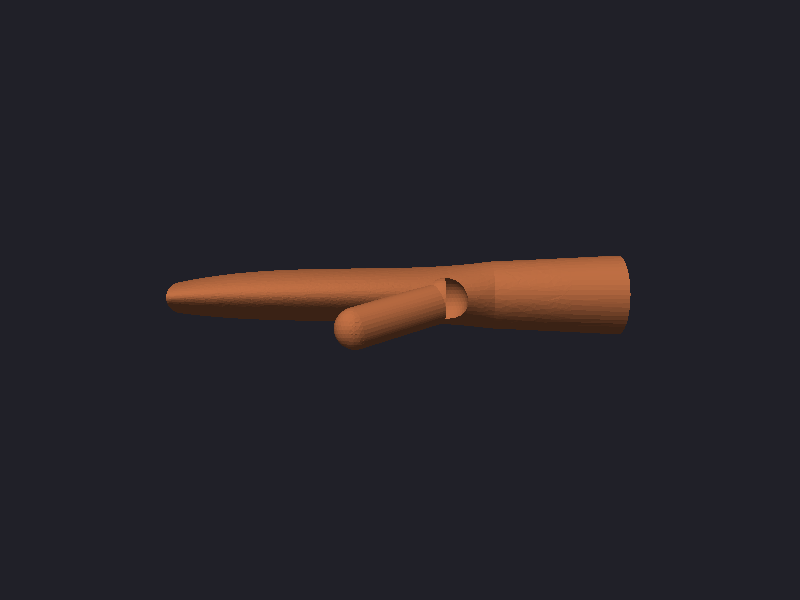
extra/wrists/renders/wrist_140.right.png
