jlcjak/neurband/extra/wrists/renders/wrist_140.top.png

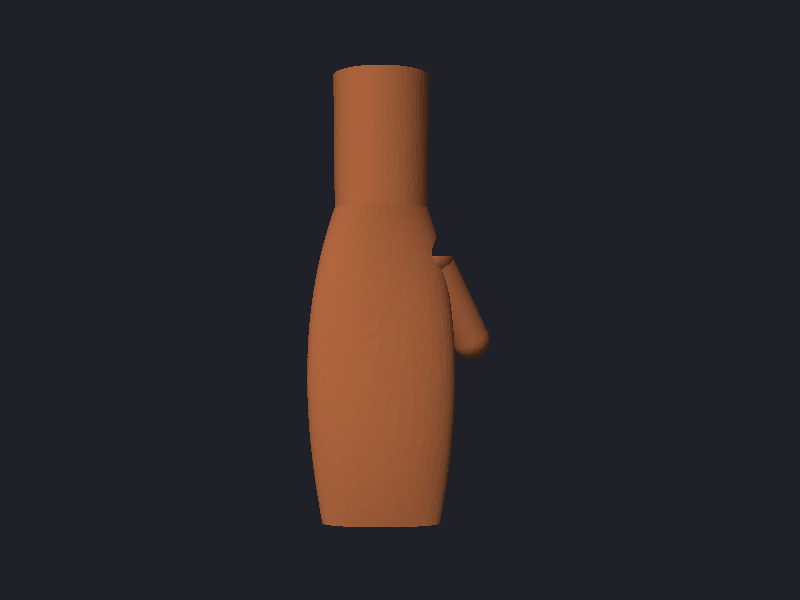
extra/wrists/renders/wrist_140.top.png
