jlcjak/neurband/mech/rev_c/renders/base_jig_fit.front.png

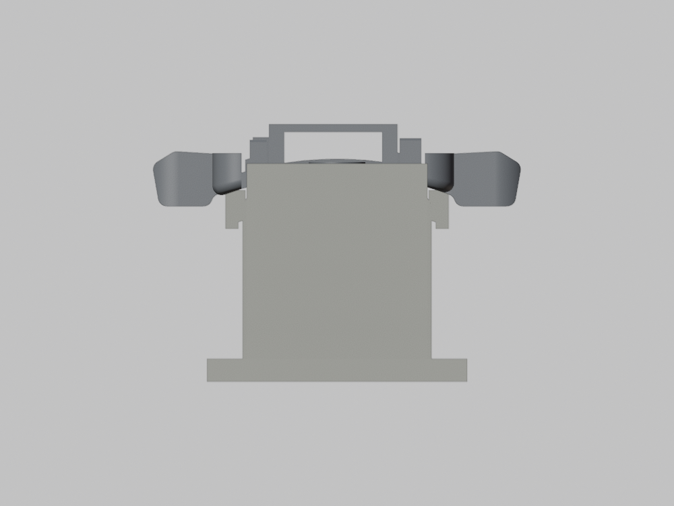
mech/rev_c/renders/base_jig_fit.front.png
