jlcjak/neurband/mech/rev_c/renders/base_jig_fit.iso.png

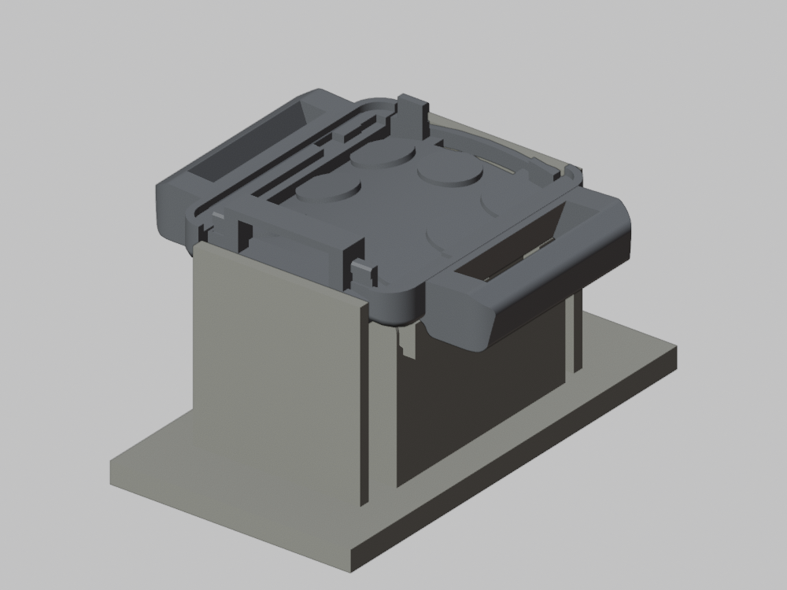
mech/rev_c/renders/base_jig_fit.iso.png
