jlcjak/neurband/mech/rev_c/renders/base_jig_fit.right.png

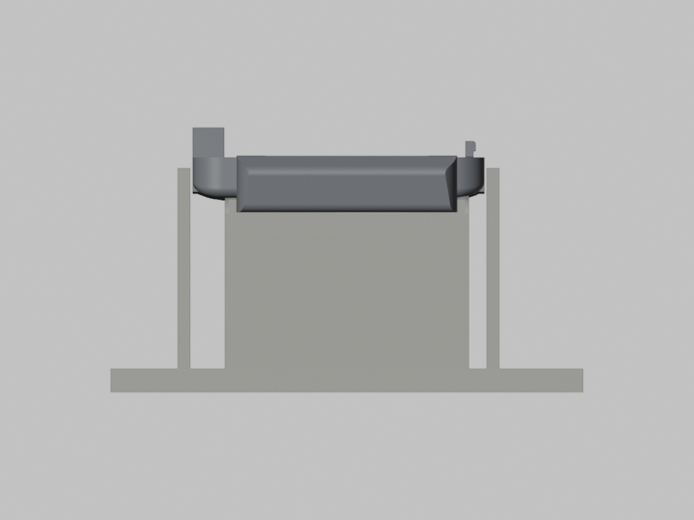
mech/rev_c/renders/base_jig_fit.right.png
