jlcjak/neurband/mech/rev_c/renders/base_jig_fit.top.png

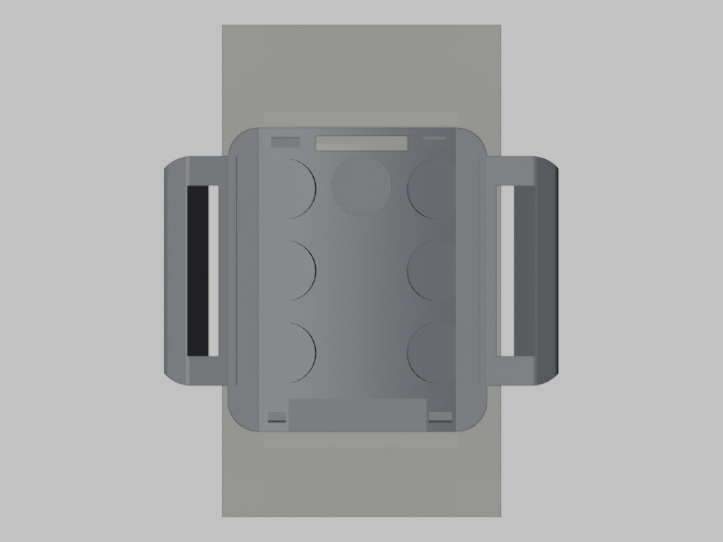
mech/rev_c/renders/base_jig_fit.top.png
