jlcjak/neurband/mech/rev_c/renders/bond_jig.front.png

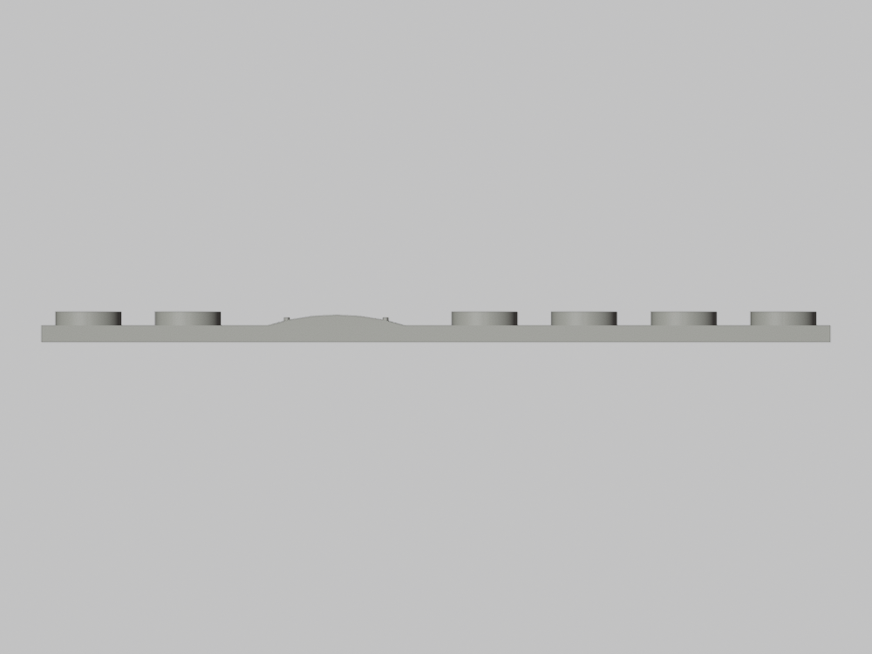
mech/rev_c/renders/bond_jig.front.png
