jlcjak/neurband/mech/rev_c/renders/bond_jig.iso.png

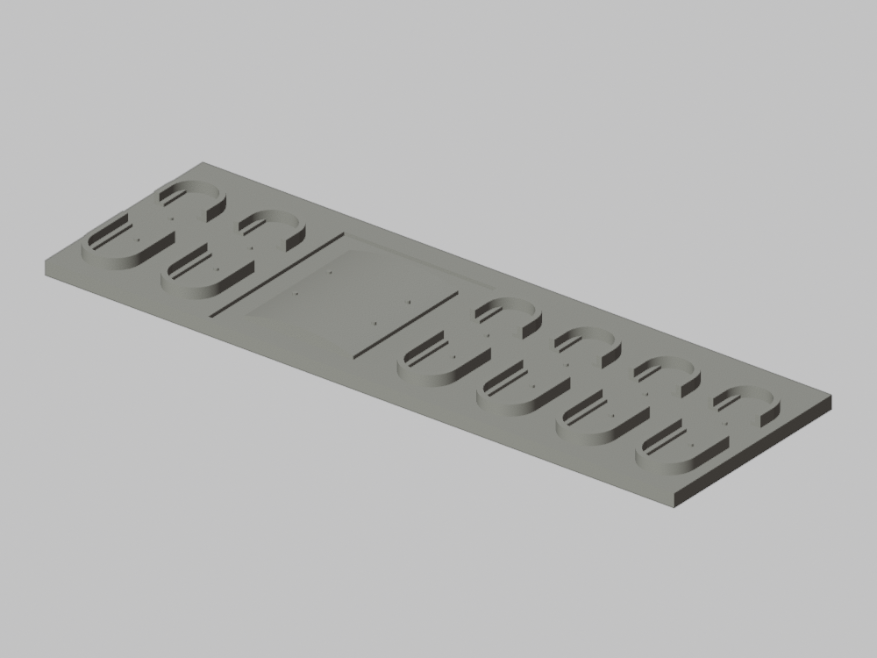
mech/rev_c/renders/bond_jig.iso.png
