jlcjak/neurband/mech/rev_c/renders/bond_jig.right.png

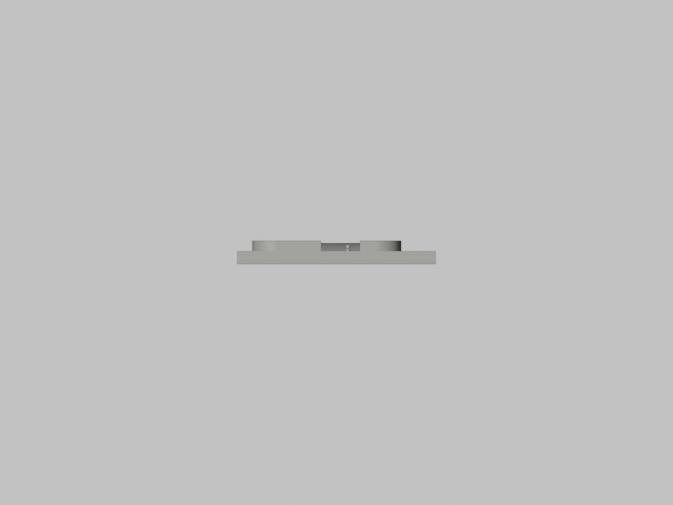
mech/rev_c/renders/bond_jig.right.png
