jlcjak/neurband/mech/rev_c/renders/bond_jig.top.png

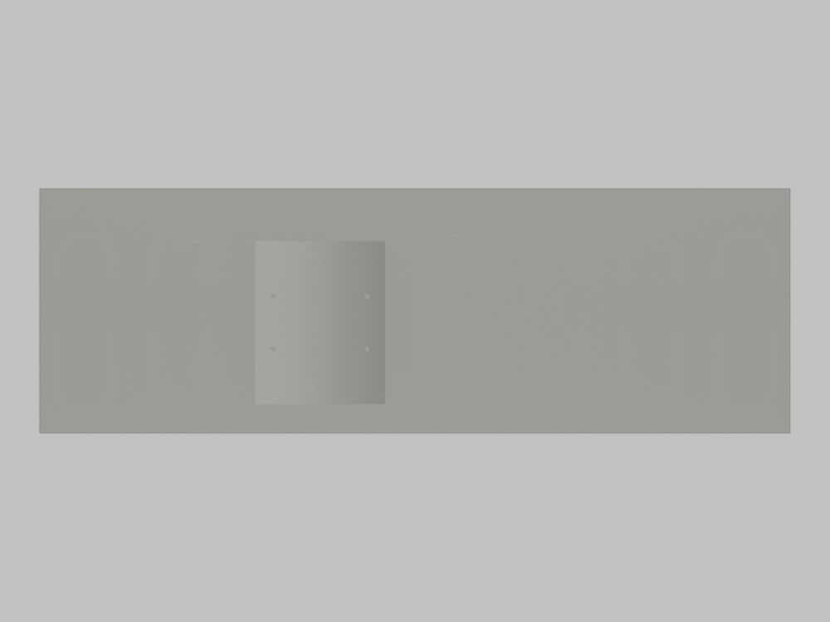
mech/rev_c/renders/bond_jig.top.png
