jlcjak/neurband/mech/rev_c/renders/bond_jig_fit.front.png

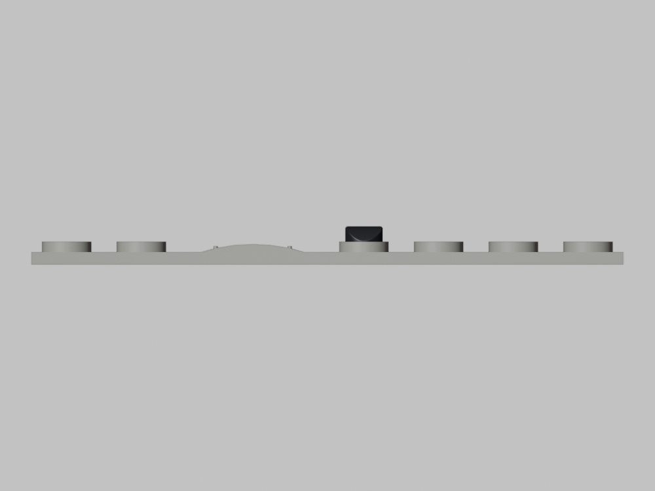
mech/rev_c/renders/bond_jig_fit.front.png
