jlcjak/neurband/mech/rev_c/renders/bond_jig_fit.top.png

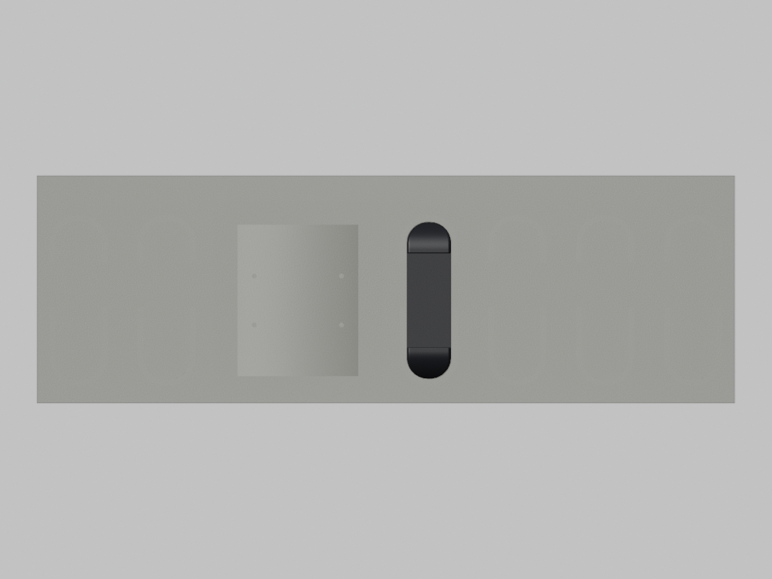
mech/rev_c/renders/bond_jig_fit.top.png
