jlcjak/neurband/mech/rev_c/renders/charge_clip_fit.front.png

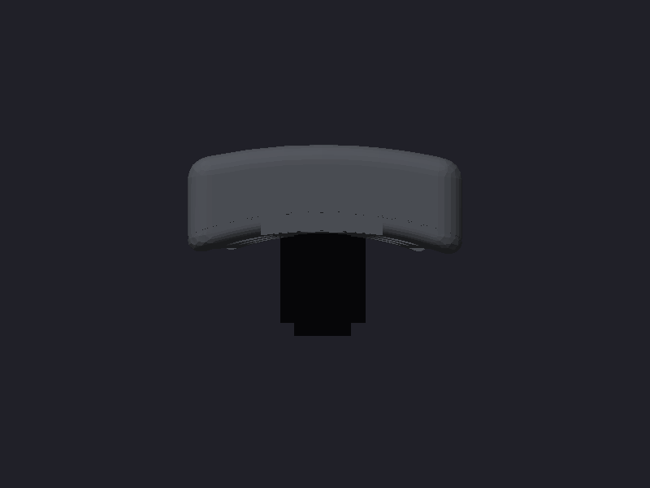
mech/rev_c/renders/charge_clip_fit.front.png
