jlcjak/neurband/mech/rev_c/renders/charge_clip_fit.iso.png

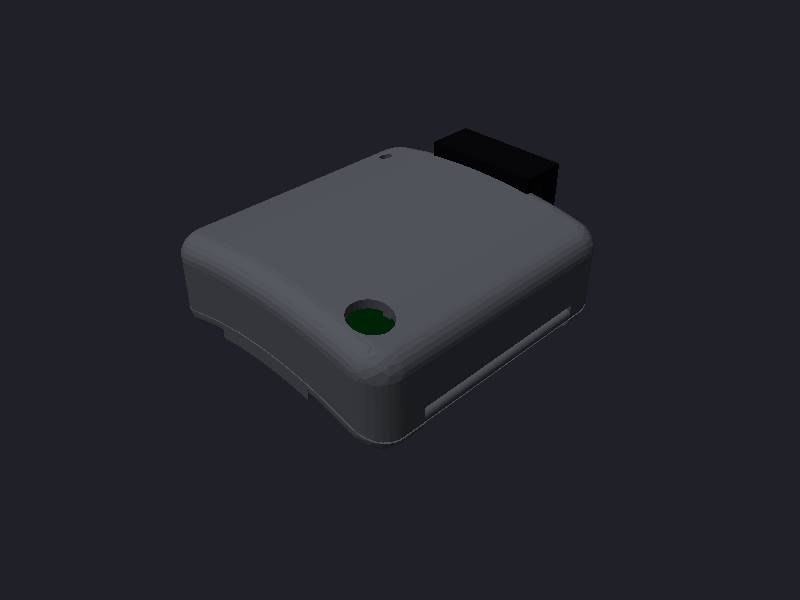
mech/rev_c/renders/charge_clip_fit.iso.png
