jlcjak/neurband/mech/rev_c/renders/charge_clip_fit.right.png

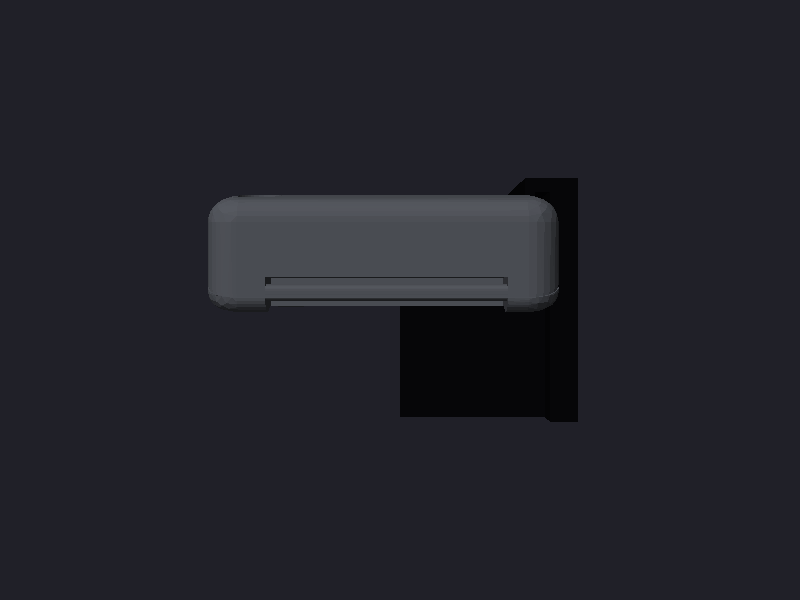
mech/rev_c/renders/charge_clip_fit.right.png
