jlcjak/neurband/mech/rev_c/renders/charge_clip_fit.top.png

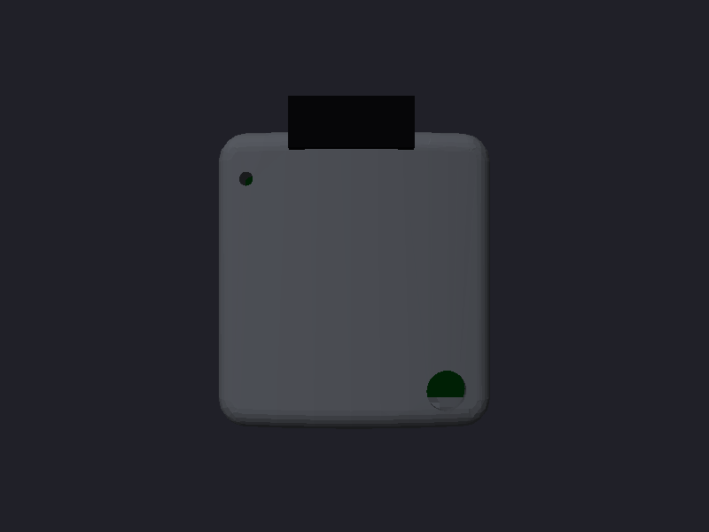
mech/rev_c/renders/charge_clip_fit.top.png
