jlcjak/neurband/mech/rev_c/renders/fit_145.right.png

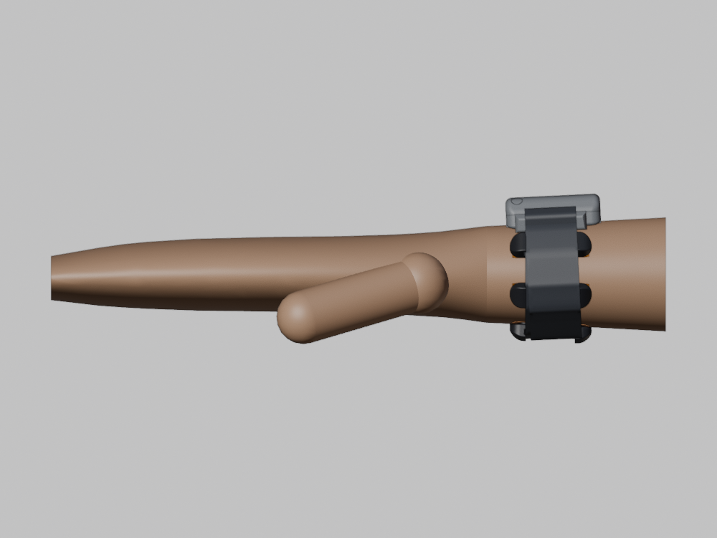
mech/rev_c/renders/fit_145.right.png
