jlcjak/neurband/mech/rev_c/renders/fit_160.front.png

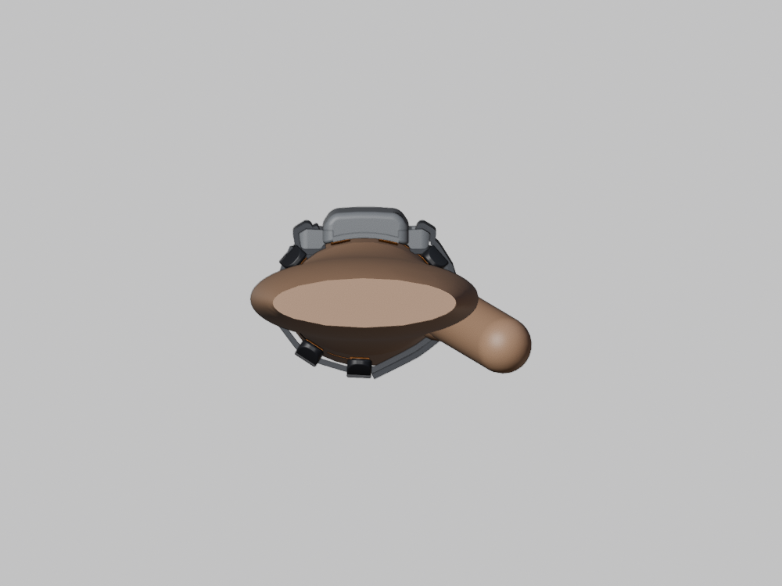
mech/rev_c/renders/fit_160.front.png
