jlcjak/neurband/mech/rev_c/renders/module_assy.front.png

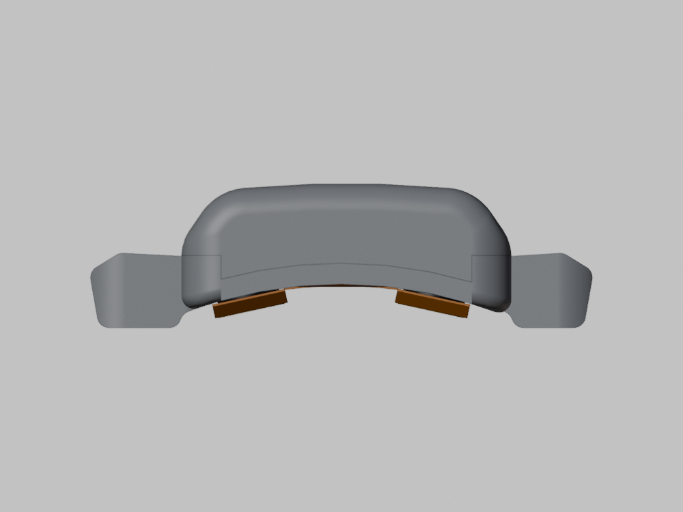
mech/rev_c/renders/module_assy.front.png
