jlcjak/neurband/mech/rev_c/renders/module_assy.top.png

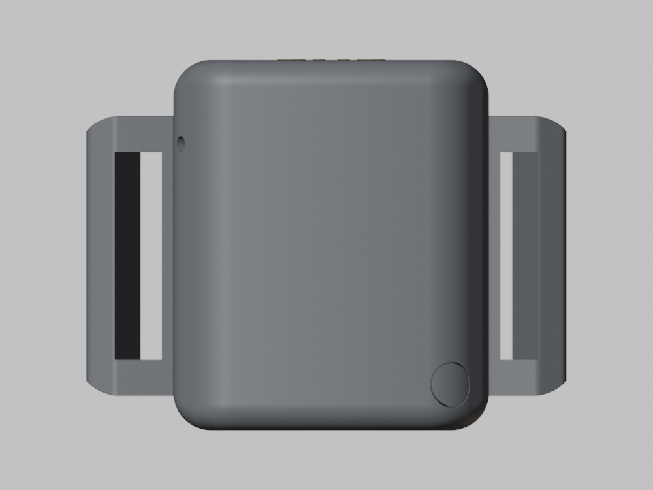
mech/rev_c/renders/module_assy.top.png
