jlcjak/neurband/mech/rev_c/renders/module_base.front.png

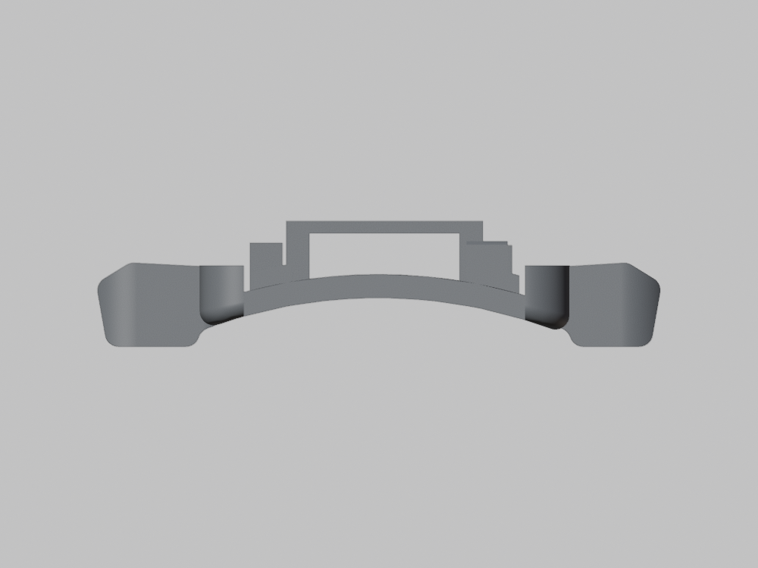
mech/rev_c/renders/module_base.front.png
