jlcjak/neurband/mech/rev_c/renders/module_base.right.png

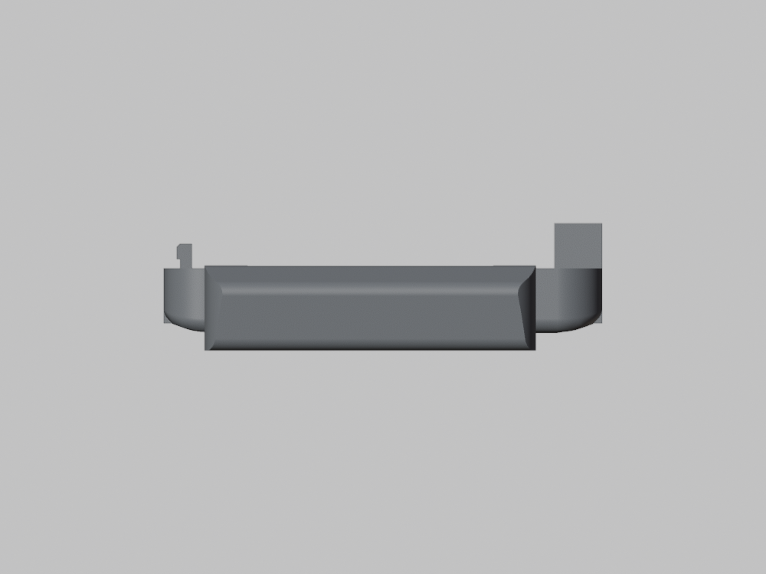
mech/rev_c/renders/module_base.right.png
