jlcjak/neurband/mech/rev_c/renders/module_base.top.png

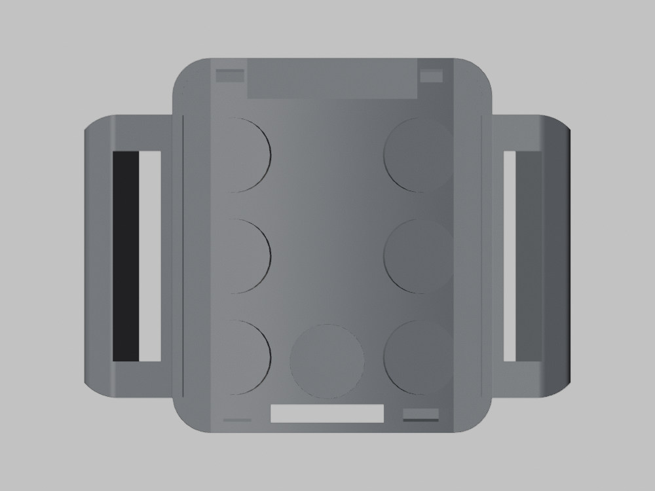
mech/rev_c/renders/module_base.top.png
