jlcjak/neurband/mech/rev_c/renders/module_lid.iso.png

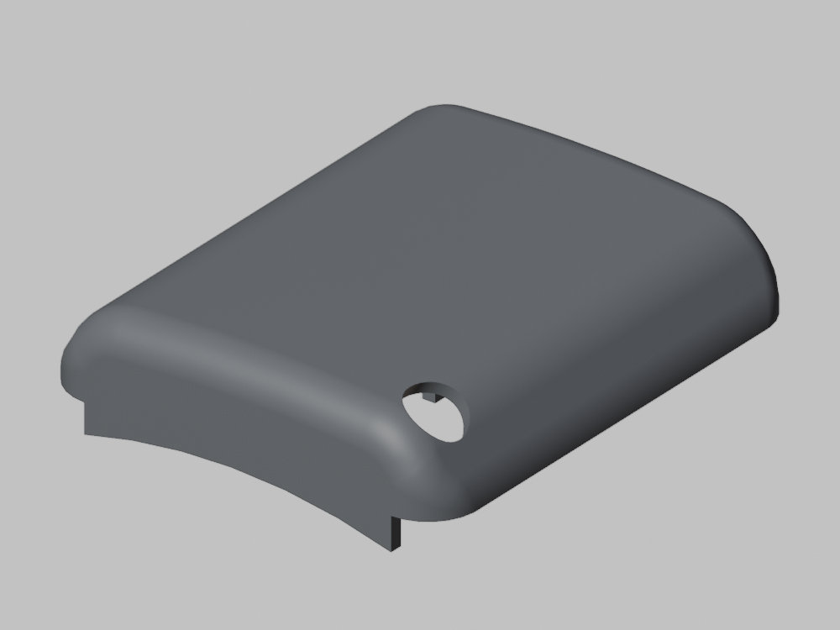
mech/rev_c/renders/module_lid.iso.png
