jlcjak/neurband/mech/rev_c/renders/module_lid.top.png

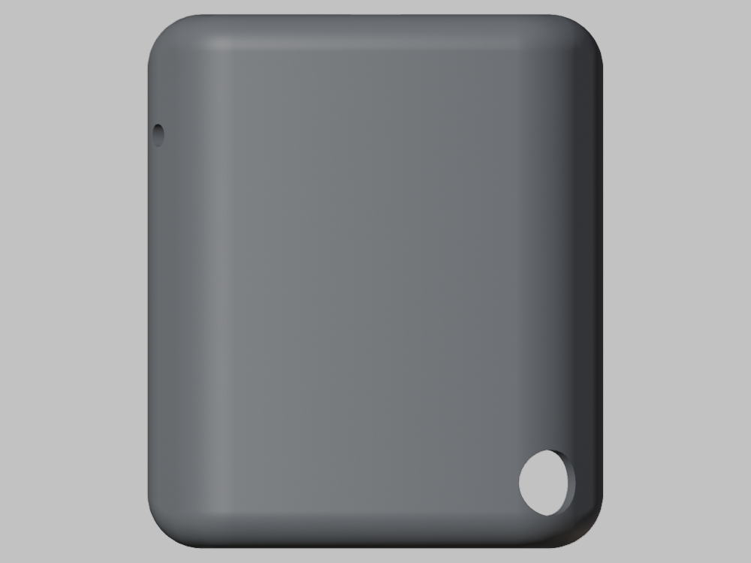
mech/rev_c/renders/module_lid.top.png
