jlcjak/neurband/mech/rev_c/renders/module_section.iso.png

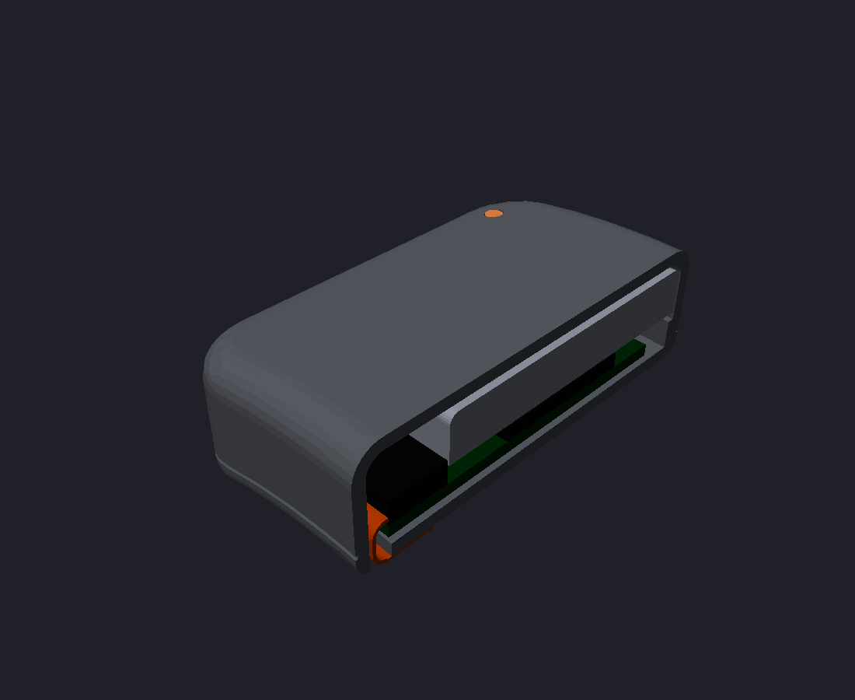
mech/rev_c/renders/module_section.iso.png
