jlcjak/neurband/mech/rev_c/renders/module_section.top.png

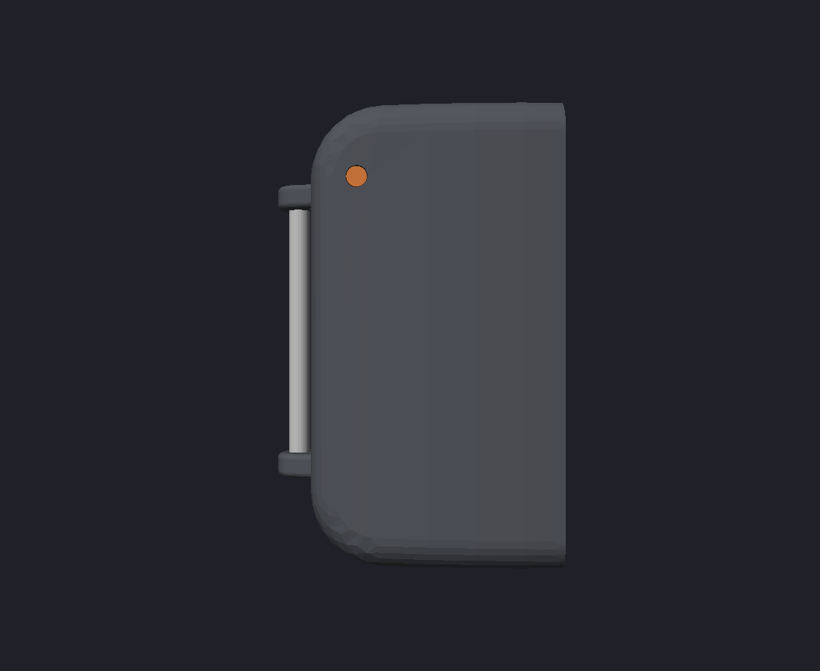
mech/rev_c/renders/module_section.top.png
