jlcjak/neurband/mech/rev_c/renders/swd_jig_fit.front.png

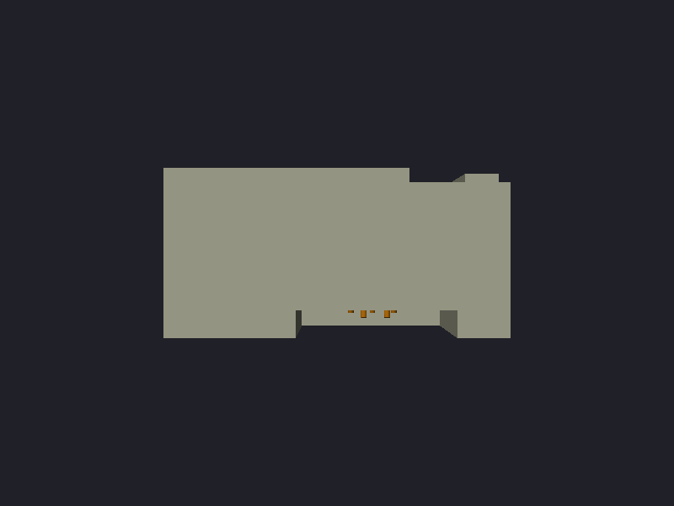
mech/rev_c/renders/swd_jig_fit.front.png
