jlcjak/neurband/mech/rev_c/renders/swd_jig_fit.iso.png

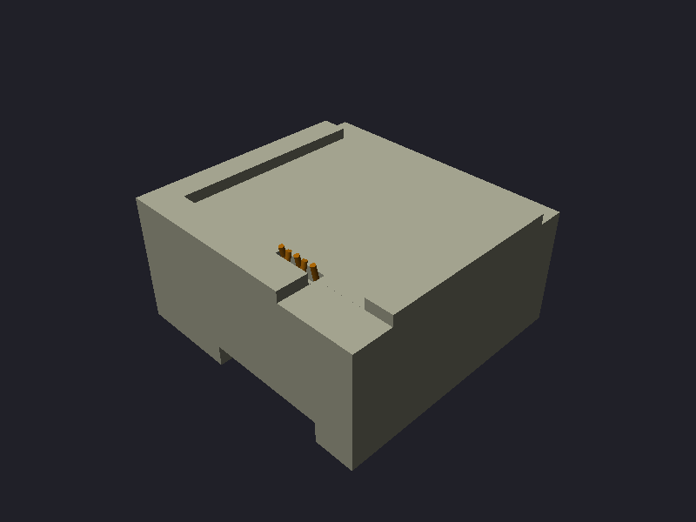
mech/rev_c/renders/swd_jig_fit.iso.png
