jlcjak/neurband/mech/rev_c/renders/swd_jig_fit.top.png

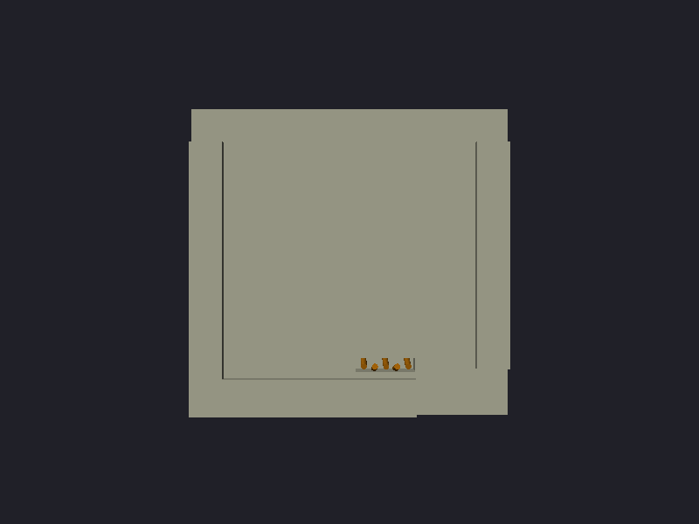
mech/rev_c/renders/swd_jig_fit.top.png
