jlcjak/neurband/sim/out/q1_pm_vs_electrode.png

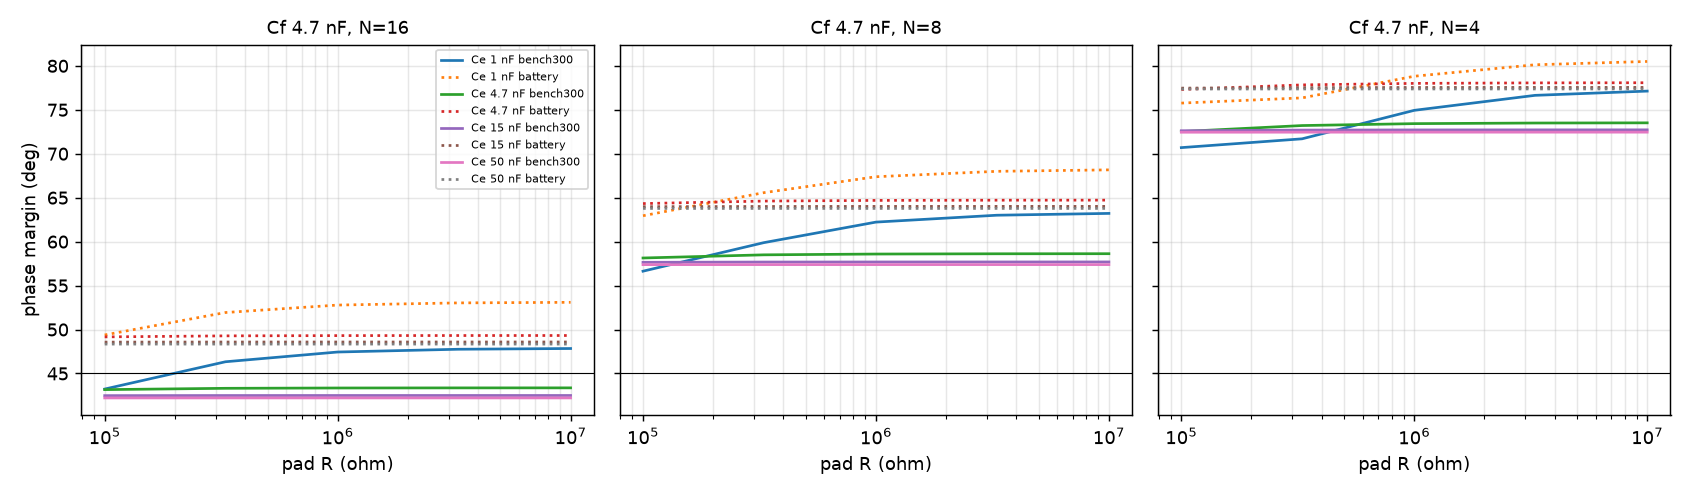
sim/out/q1_pm_vs_electrode.png
