jlcjak/neurband/sim/preorder/out/hotspots_in2_bcu.png

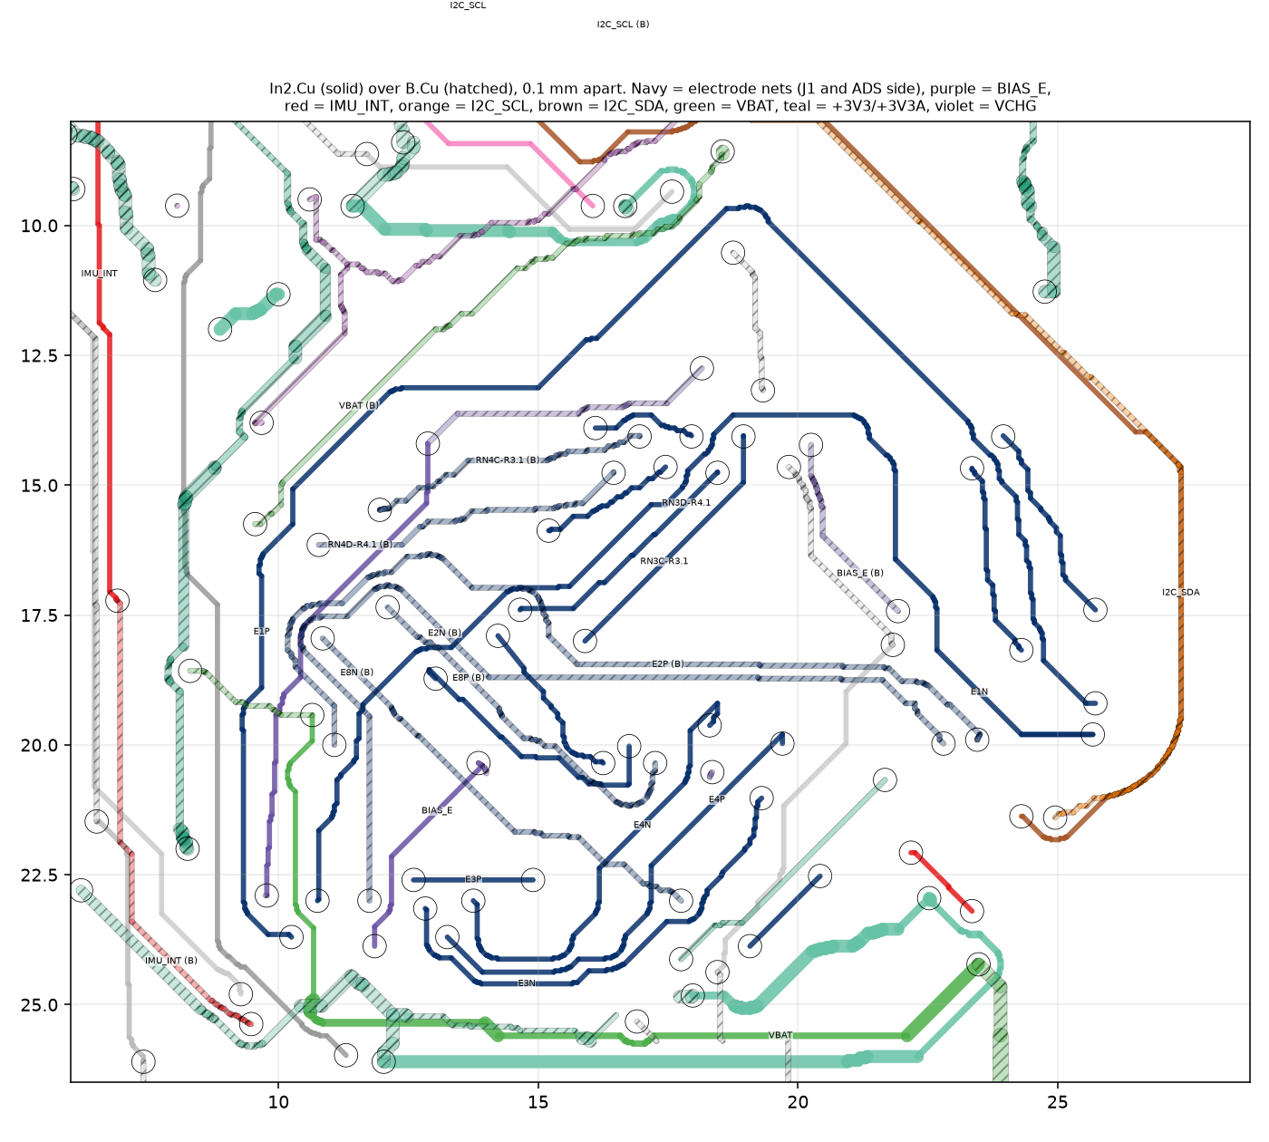
sim/preorder/out/hotspots_in2_bcu.png
