jlcjak/neurband/boards/neurband_c/neurband_c_bom.csv

Reference | Value | Footprint | MPN | LCSC | QUANTITY
C1,C8,C13,C17,C18,C29,C30 | 100nF | neurband:C_0402_Small | CL05B104KO5NNNC | C1525 | 7
C2-C4,C7,C9-C11,C15,C24,C26,C27,C31-C33,C35 | 1uF | neurband:C_0402_Small | CL05A105KA5NQNC | C52923 | 15
C5 | 22uF | neurband:C_0603_Small | CL10A226MQ8NRNC | C59461 | 1
C6,C16,C25,C28 | 10uF | neurband:C_0603_Small | CL10A106KP8NNNC | C19702 | 4
C12 | 4.7nF | neurband:C_0402_Small | 0402B472K500NT | C1538 | 1
C14 | 100pF | neurband:C_0402_Small | 0402CG101J500NT | C1546 | 1
C19,C20,C34 | 12pF | neurband:C_0402_Small | 0402CG120J500NT | C1547 | 3
C21 | 0.8pF | neurband:C_0402_Small | 0402CG0R8B500NT | C285068 | 1
C23 | 0.5pF | neurband:C_0402_Small | 0402CG0R5B500NT | C285052 | 1
D1 | red | LED_SMD:LED_0603_1608Metric | KT-0603R | C2286 | 1
J1 | FPC 20p 0.5mm (electrode flex) | neurband:XUNPU_FPC-05F-20PH20_Centroid | FPC-05F-20PH20 | C2856803 | 1
L1 | 3.9nH | neurband:L_0402_Small | SDCL1005C3N9STDF | C14033 | 1
L2 | 5.1nH | neurband:L_0402_Small | SDCL1005C5N1STDF | C33114 | 1
R1,R6,R7,R12,R13 | 1M | neurband:R_0402_Small | 0402WGF1004TCE | C26083 | 5
R2,R11 | 100k | neurband:R_0402_Small | 0402WGF1003TCE | C25741 | 2
R4,R9,R10 | 10k | neurband:R_0402_Small | 0402WGF1002TCE | C25744 | 3
R5 | 10 | neurband:R_0402_Small | 0402WGF100JTCE | C25077 | 1
R8 | 1k | neurband:R_0402_Small | 0402WGF1001TCE | C11702 | 1
RN1-RN4 | 10k | neurband:R_Array_Convex_4x0603_FabZero | 4D03WGJ0103T5E | C29718 | 4
SW1 | WAKE / MARK | Button_Switch_SMD:SW_SPST_TS-1088-xR020 | TS-1088-AR02016 | C720477 | 1
U1 | nRF52832-QFAA | neurband:QFN-48-1EP_6x6mm_P0.4mm_EP4.6x4.6mm_FabZero | NRF52832-QFAA-R | C77540 | 1
U2 | ADS1298IPAGR | neurband:TQFP-64_10x10mm_P0.5mm_FabZero | ADS1298IPAGR | C527440 | 1
U3 | XC6206P332MR | neurband:SOT-23-3_FabZero | XC6206P332MR-G | C5446 | 1
U4 | TP4054 | neurband:SOT-23-5_FabZero | TP4054-42-SOT25R | C32574 | 1
U5 | LSM6DSL | Package_LGA:LGA-14_3x2.5mm_P0.5mm_LayoutBorder3x4y | LSM6DSLTR | C126672 | 1
Y1 | 32MHz 8pF | Crystal:Crystal_SMD_2016-4Pin_2.0x1.6mm | X201632MKB4SI | C718072 | 1
