jlcjak/neurband/mech/rev_c/module_assy.step

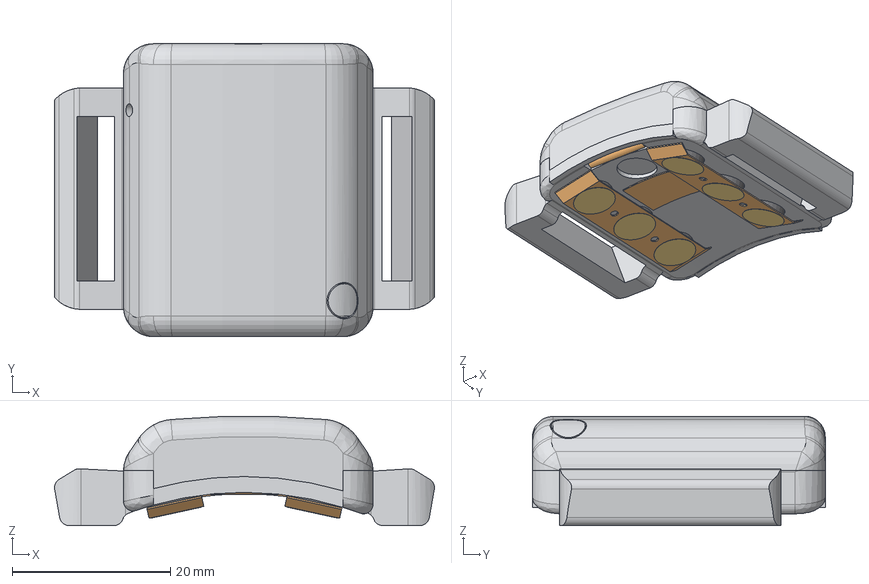
[picture p106: CAD file, 2026-11-01]
mech/rev_c/module_assy.step
48.1 x 37.1 x 13.8 mm
module_base
module_lid
main_board
board_parts
board_parts_001
board_parts_002
board_parts_003
board_parts_004
board_parts_005
board_parts_006
board_parts_007
board_parts_008
board_parts_009
board_parts_010
board_parts_011
board_parts_012
board_parts_013
board_parts_014
board_parts_015
board_parts_016
board_parts_017
board_parts_018
board_parts_019
board_parts_020
board_parts_021
board_parts_022
board_parts_023
board_parts_024
board_parts_025
board_parts_026
board_parts_027
board_parts_028
board_parts_029
board_parts_030
board_parts_031
board_parts_032
board_parts_033
board_parts_034
board_parts_035
board_parts_036
board_parts_037
board_parts_038
board_parts_039
board_parts_040
board_parts_041
board_parts_042
board_parts_043
board_parts_044
board_parts_045
board_parts_046
board_parts_047
board_parts_048
board_parts_049
board_parts_050
board_parts_051
board_parts_052
board_parts_053
board_parts_054
board_parts_055
board_parts_056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
