jlcjak/neurband/boards/neurband_c/neurband_c.step

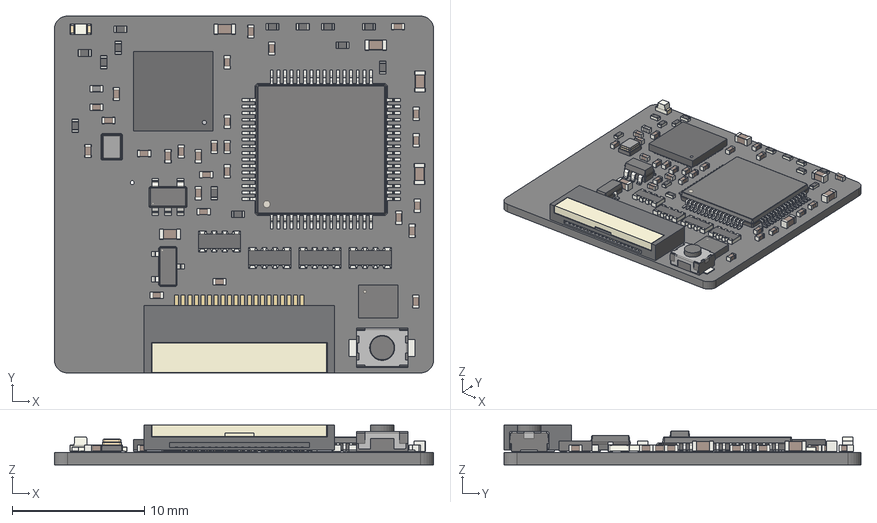
[picture p108: CAD file, 2026-10-29]
boards/neurband_c/neurband_c.step
28.7 x 27.0 x 3.01 mm
R_0402_1005Metric x 13
C_0402_1005Metric x 27
C_0603_1608Metric x 5
DarkHousing
ClosedCreamFlipbar
TwentyBottomContacts
SolderAnchors
R_Array_Convex_4x0603 x 4
Crystal_SMD_2016-4Pin_2.0x1.6mm
SOT-23-5
L_0402_1005Metric
BlackMould
LeadsAndEP
PinOneDot
LGA_14_3x25mm_P05mm_LayoutBorder3x4y
SOT-23-3
TQFP-64_10x10mm_P0.5mm
LED_0603_1608Metric
SW_SPST_TS-1088-xR020
neurband_c_PCB
