jlcjak/neurband/boards/neurband_c_flex/neurband_c_flex.step

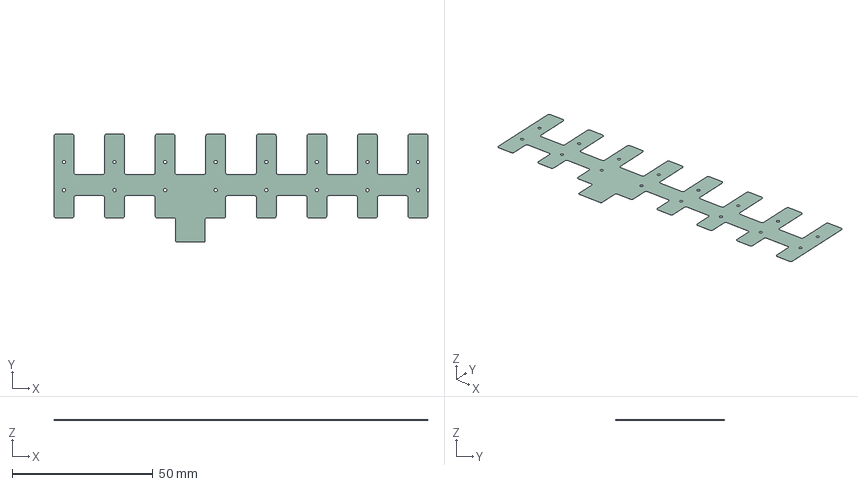
[picture p109: CAD file, 2026-11-01]
boards/neurband_c_flex/neurband_c_flex.step
133.1 x 38.5 x 0.025 mm
