jlcjak/neurband/mech/strap_keeper.step

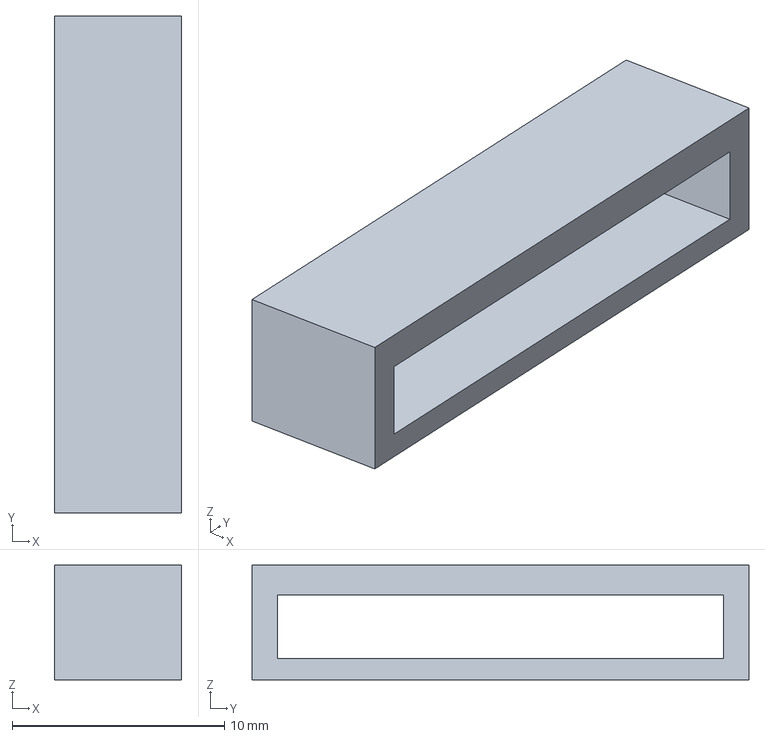
[picture p110: CAD file, 2026-10-26]
mech/strap_keeper.step
6.00 x 23.4 x 5.40 mm
