jlcjak/neurband/boards/neurband_c/layout/models/L_0603_1608Metric.step

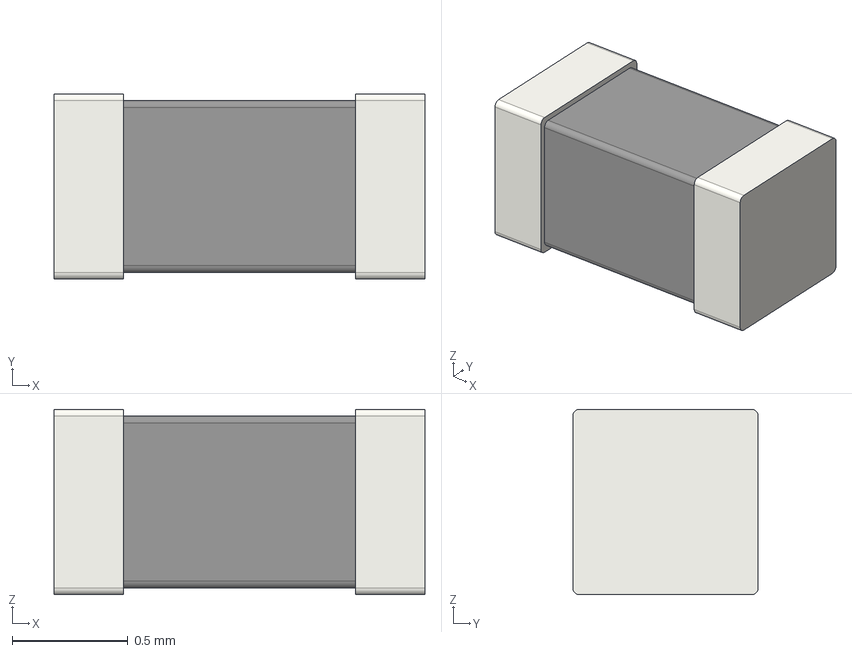
[picture p111: CAD file, 2026-11-01]
boards/neurband_c/layout/models/L_0603_1608Metric.step
1.60 x 0.8 x 0.8 mm
