jlcjak/neurband/boards/neurband_c/neurband_c_board_only.step

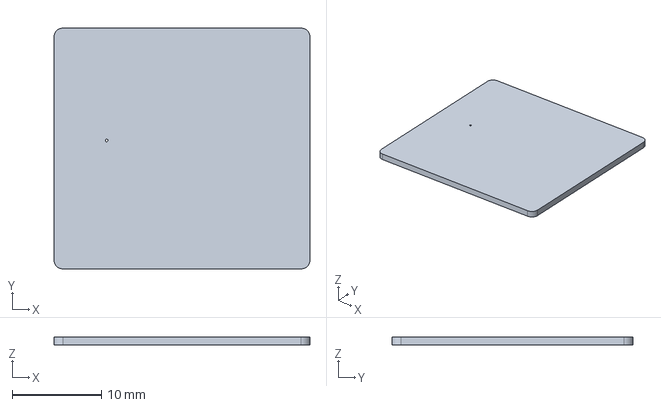
[picture p112: CAD file, 2026-10-29]
boards/neurband_c/neurband_c_board_only.step
28.7 x 27.0 x 0.929 mm
