jlcjak/neurband/mech/rev_c/pod.step

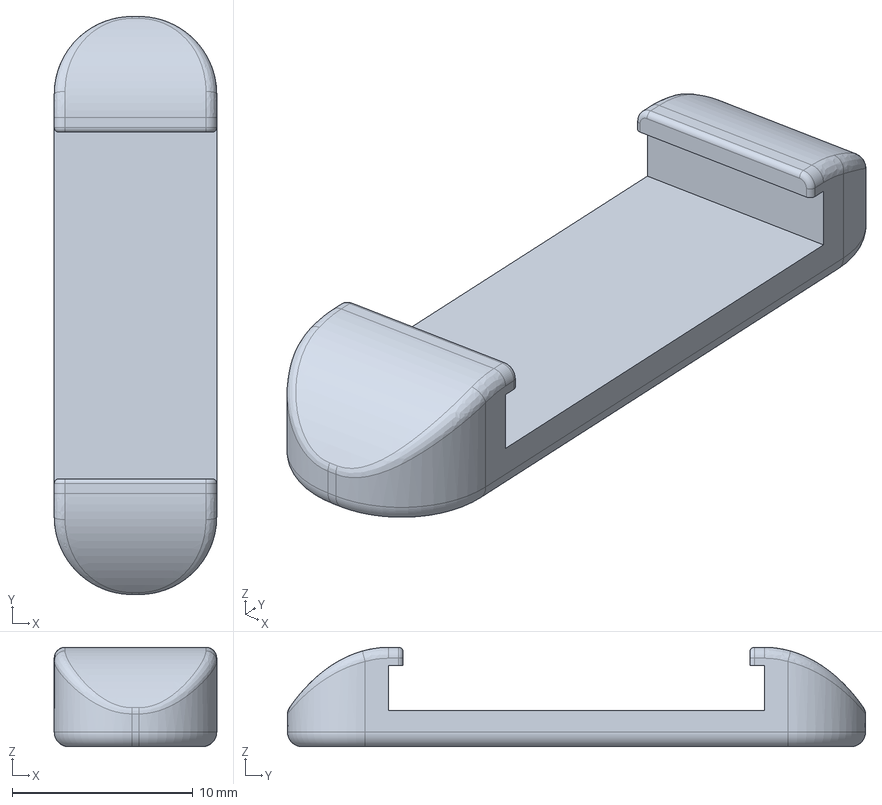
[picture p114: CAD file, 2026-11-01]
mech/rev_c/pod.step
9.00 x 32.0 x 5.50 mm
