jlcjak/neurband/boards/neurband_c/layout/models/R_0603_1608Metric.step

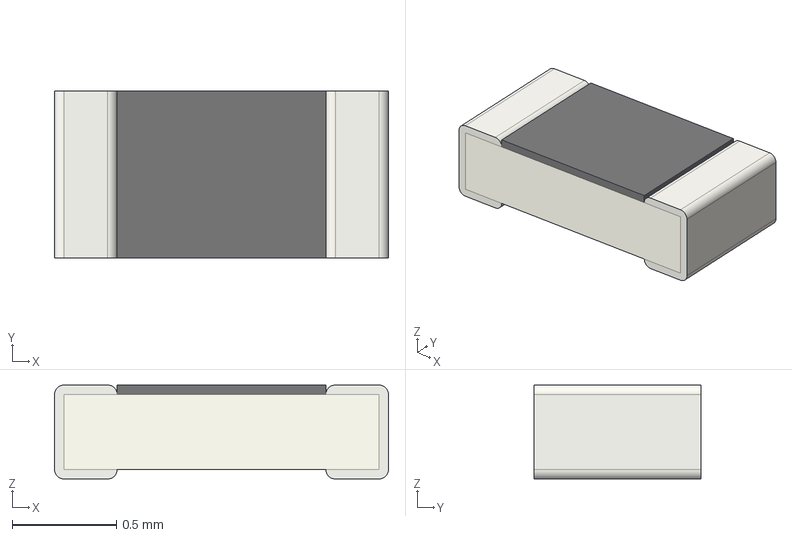
[picture p115: CAD file, 2026-11-01]
boards/neurband_c/layout/models/R_0603_1608Metric.step
1.60 x 0.8 x 0.45 mm
