jlcjak/neurband/mech/pod_shell.step

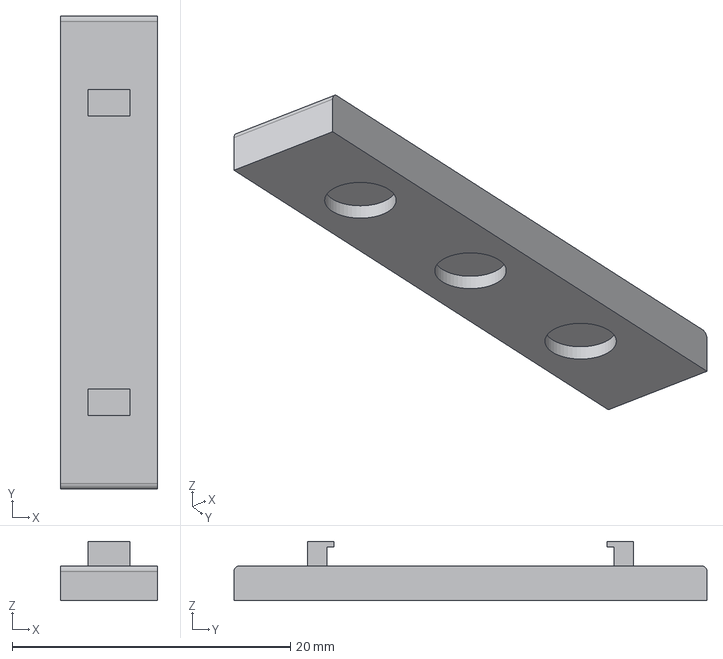
[picture p116: CAD file, 2026-10-26]
mech/pod_shell.step
7.00 x 34.0 x 4.25 mm
