jlcjak/neurband/mech/rev_c/bond_jig_fit.step

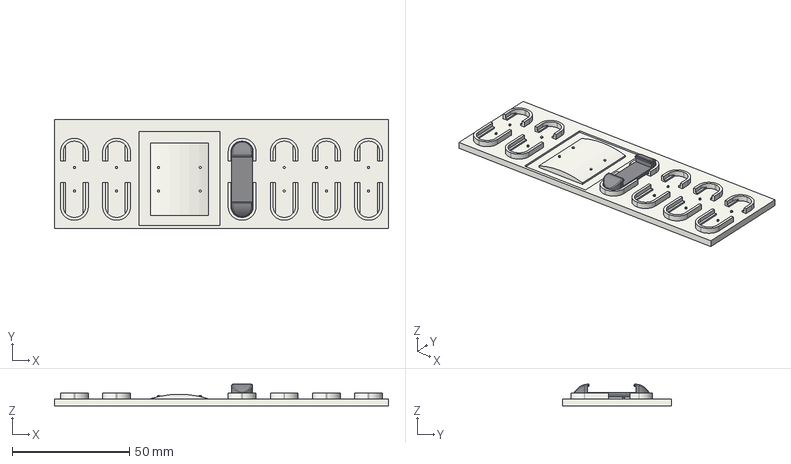
[picture p117: CAD file, 2026-11-01]
mech/rev_c/bond_jig_fit.step
142.6 x 46.5 x 9.21 mm
bond_jig
pod
