jlcjak/neurband/boards/neurband_c/layout/models/R_0402_1005Metric.step

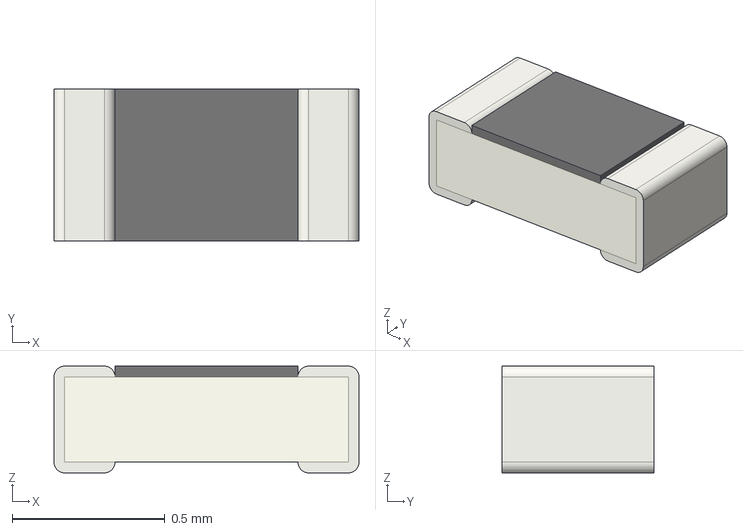
[picture p118: CAD file, 2026-11-01]
boards/neurband_c/layout/models/R_0402_1005Metric.step
1.00 x 0.5 x 0.35 mm
