jlcjak/neurband/mech/housing_lid.step

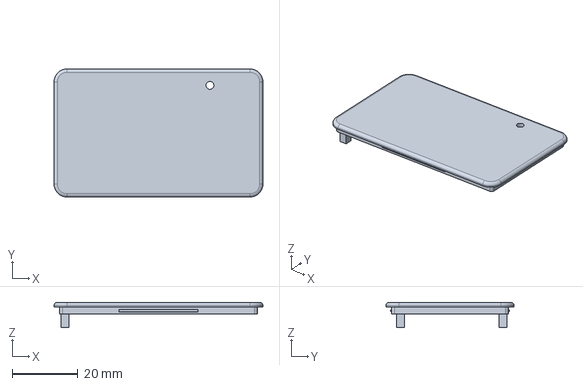
[picture p119: CAD file, 2026-10-26]
mech/housing_lid.step
63.6 x 39.0 x 7.75 mm
