jlcjak/neurband/mech/rev_c/pod_with_flex.step

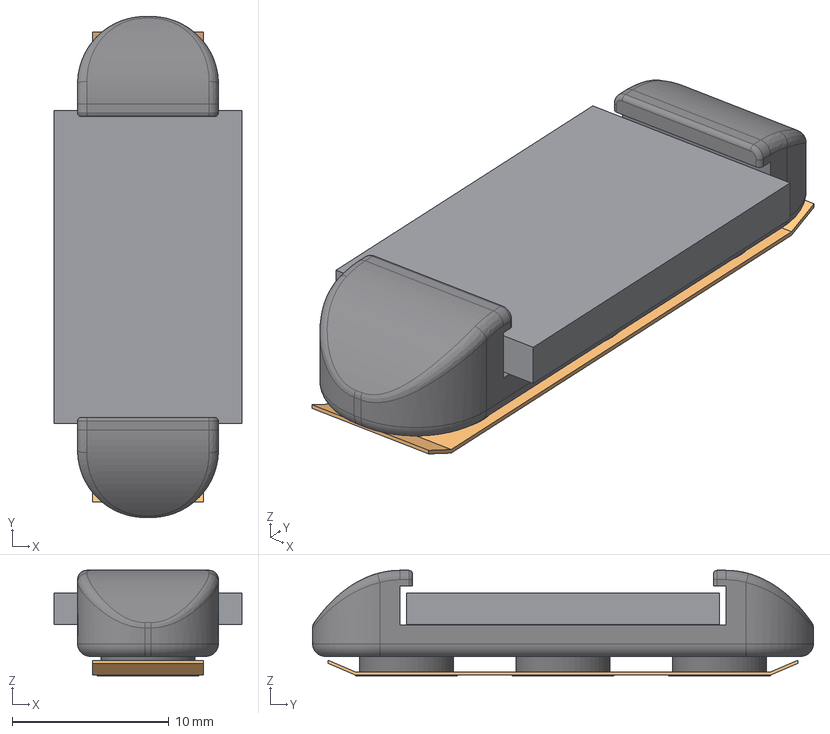
[picture p120: CAD file, 2026-11-01]
mech/rev_c/pod_with_flex.step
12.0 x 32.0 x 6.74 mm
pod
foam
foam_001
foam_002
flex
pads
pads_001
pads_002
webbing
