jlcjak/neurband/mech/rev_c/bond_jig.step

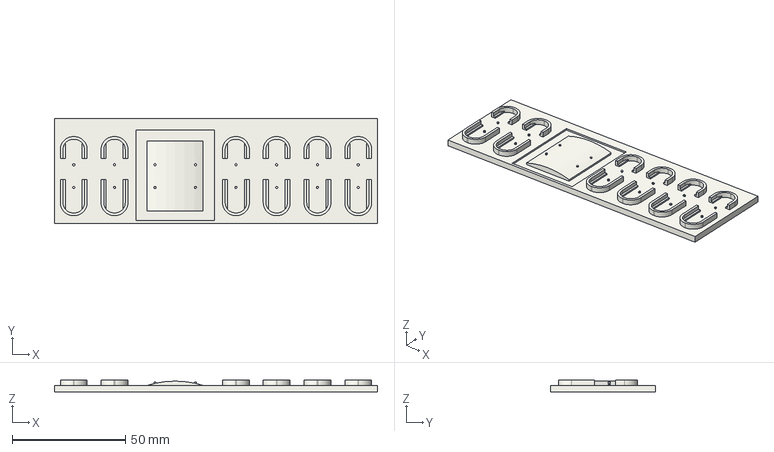
[picture p123: CAD file, 2026-11-01]
mech/rev_c/bond_jig.step
142.6 x 46.5 x 5.50 mm
