jlcjak/neurband/mech/electrode_flex_S.step

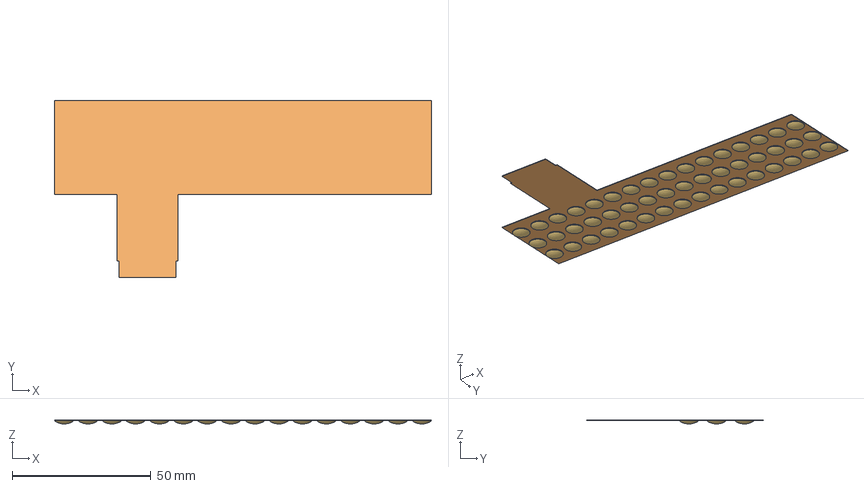
[picture p124: CAD file, 2026-10-26]
mech/electrode_flex_S.step
136.0 x 64.0 x 1.40 mm
flex
electrodes
electrodes_001
electrodes_002
electrodes_003
electrodes_004
electrodes_005
electrodes_006
electrodes_007
electrodes_008
electrodes_009
electrodes_010
electrodes_011
electrodes_012
electrodes_013
electrodes_014
electrodes_015
electrodes_016
electrodes_017
electrodes_018
electrodes_019
electrodes_020
electrodes_021
electrodes_022
electrodes_023
electrodes_024
electrodes_025
electrodes_026
electrodes_027
electrodes_028
electrodes_029
electrodes_030
electrodes_031
electrodes_032
electrodes_033
electrodes_034
electrodes_035
electrodes_036
electrodes_037
electrodes_038
electrodes_039
electrodes_040
electrodes_041
electrodes_042
electrodes_043
electrodes_044
electrodes_045
electrodes_046
electrodes_047
