jlcjak/neurband/mech/rev_c/module_base.step

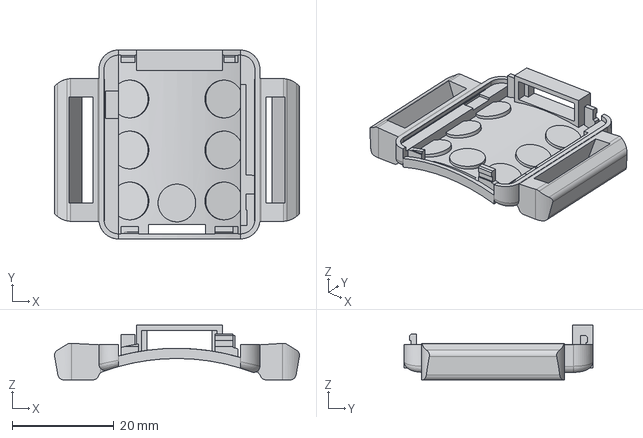
[picture p125: CAD file, 2026-11-01]
mech/rev_c/module_base.step
48.1 x 37.0 x 10.8 mm
