jlcjak/neurband/boards/neurband_c/layout/models/L_0805_2012Metric.step

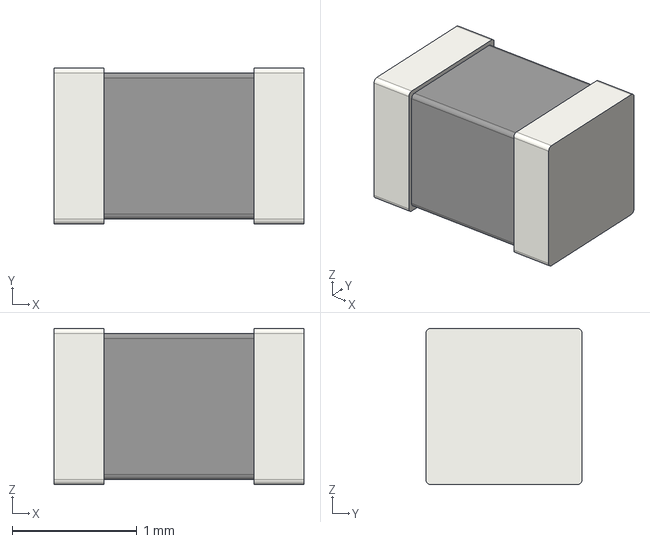
[picture p126: CAD file, 2026-11-01]
boards/neurband_c/layout/models/L_0805_2012Metric.step
2.00 x 1.25 x 1.25 mm
