jlcjak/neurband/mech/housing_base.step

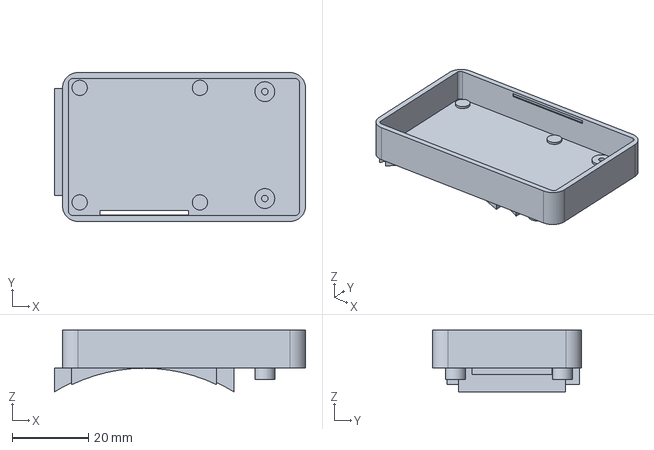
[picture p127: CAD file, 2026-10-26]
mech/housing_base.step
65.8 x 39.0 x 16.2 mm
