jlcjak/neurband/mech/rev_c/module_lid.step

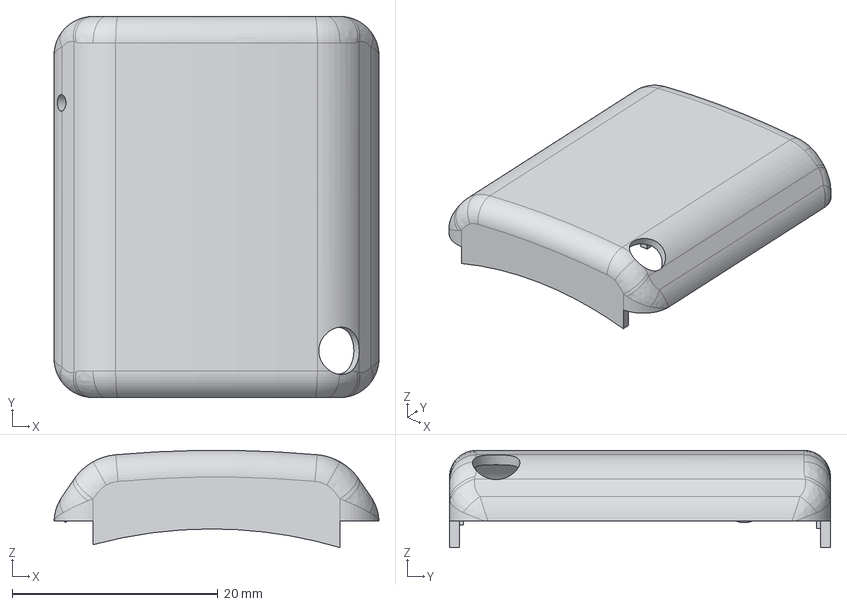
[picture p128: CAD file, 2026-11-01]
mech/rev_c/module_lid.step
31.6 x 37.0 x 9.45 mm
