jlcjak/neurband/mech/strap_XL.step

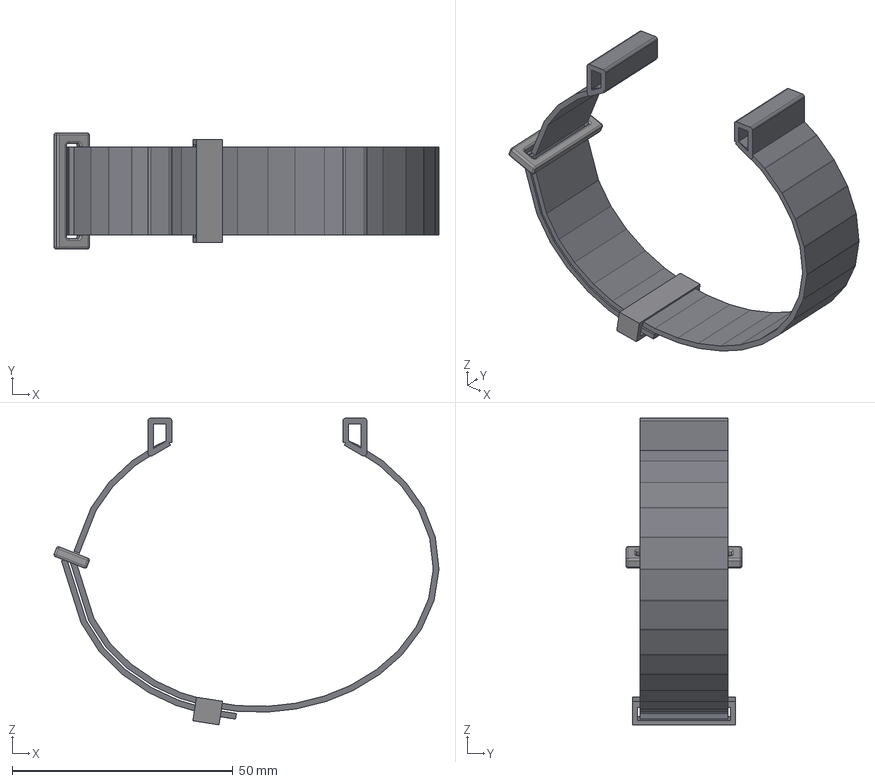
[picture p130: CAD file, 2026-10-26]
mech/strap_XL.step
87.2 x 26.3 x 69.5 mm
strap_long
strap_long_001
strap_short
lug_loops
lug_loops_001
ring
keeper
