jlcjak/neurband/mech/rev_c/base_jig_fit.step

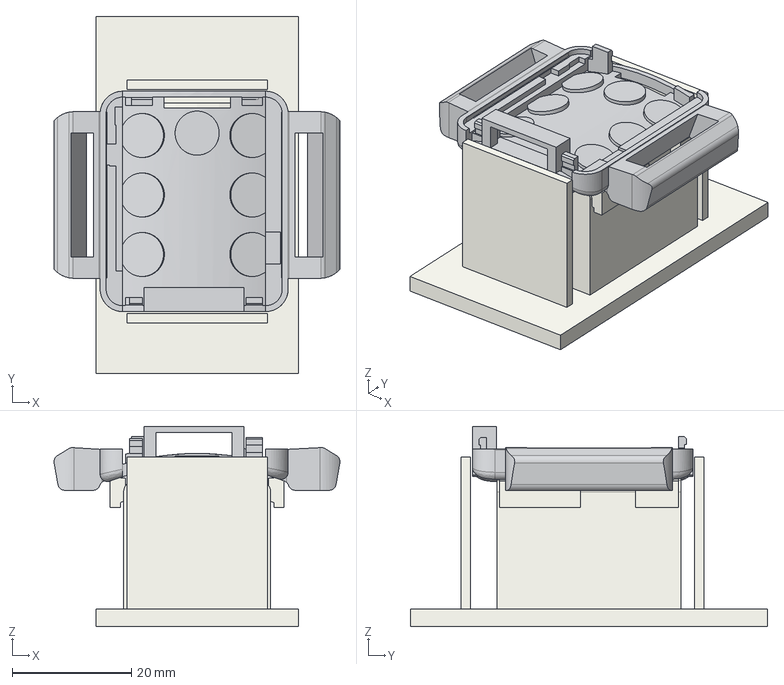
[picture p131: CAD file, 2026-11-01]
mech/rev_c/base_jig_fit.step
48.1 x 60.0 x 33.7 mm
base_jig
module_base
