jlcjak/neurband/mech/strap_L.step

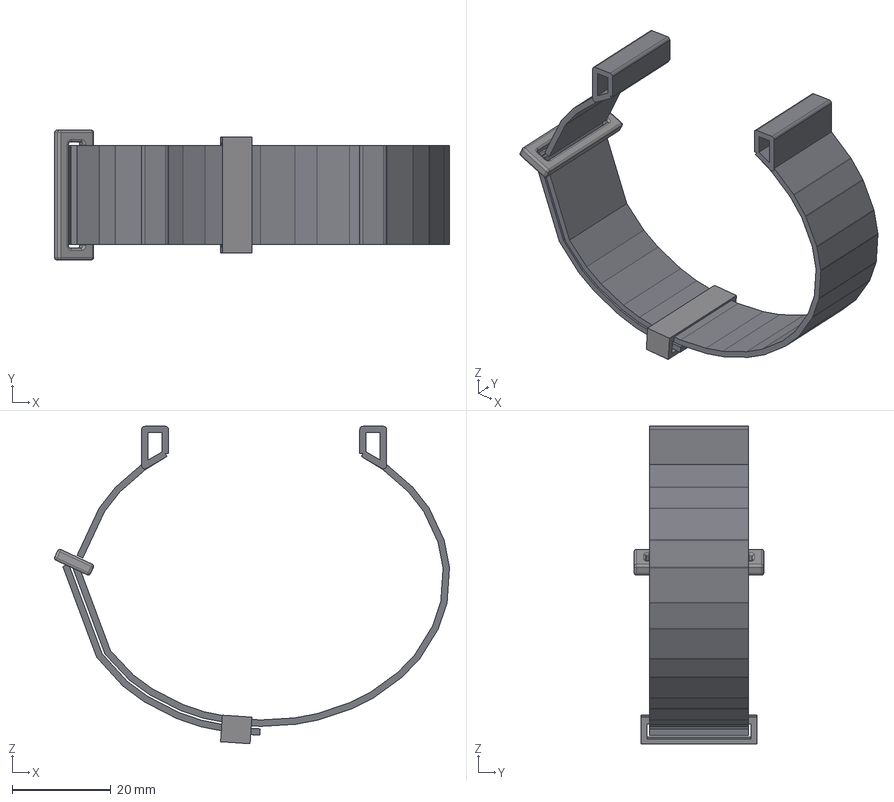
[picture p132: CAD file, 2026-10-26]
mech/strap_L.step
80.0 x 26.3 x 64.3 mm
strap_long
strap_long_001
strap_short
lug_loops
lug_loops_001
ring
keeper
