jlcjak/neurband/mech/rev_c/cell_spacer.step

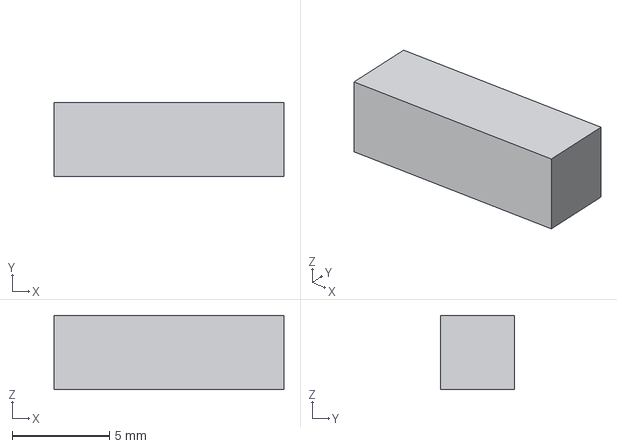
[picture p134: CAD file, 2026-11-01]
mech/rev_c/cell_spacer.step
11.8 x 3.80 x 3.80 mm
