jlcjak/neurband/boards/neurband_c/layout/models/R_0805_2012Metric.step

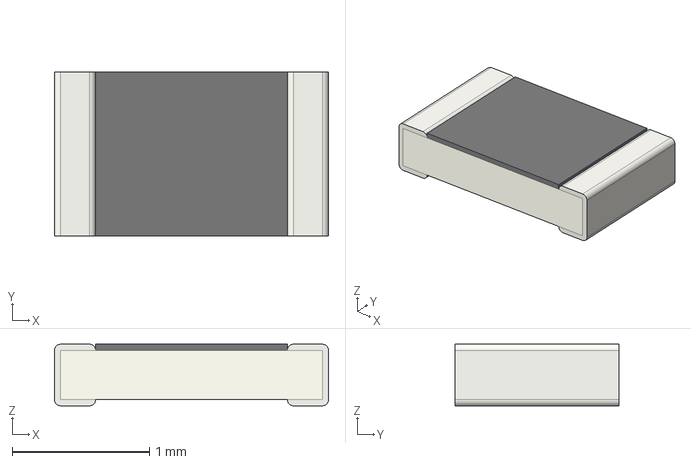
[picture p135: CAD file, 2026-11-01]
boards/neurband_c/layout/models/R_0805_2012Metric.step
2.00 x 1.20 x 0.45 mm
