jlcjak/neurband/mech/rev_c/base_jig.step

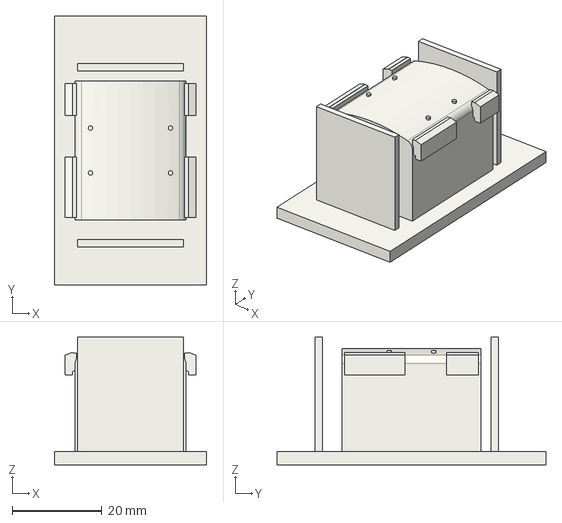
[picture p136: CAD file, 2026-11-01]
mech/rev_c/base_jig.step
34.0 x 60.0 x 28.5 mm
