jlcjak/neurband/mech/strap_ring.step

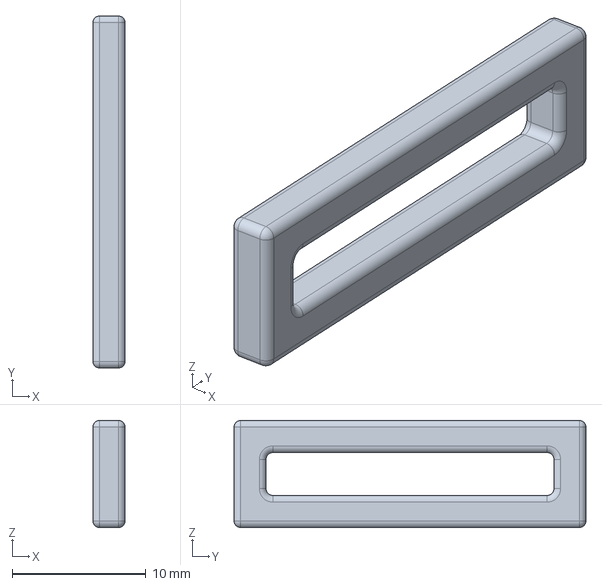
[picture p137: CAD file, 2026-10-26]
mech/strap_ring.step
2.40 x 26.3 x 8.00 mm
