jlcjak/neurband/boards/neurband_c/layout/models/L_0201_0603Metric.step

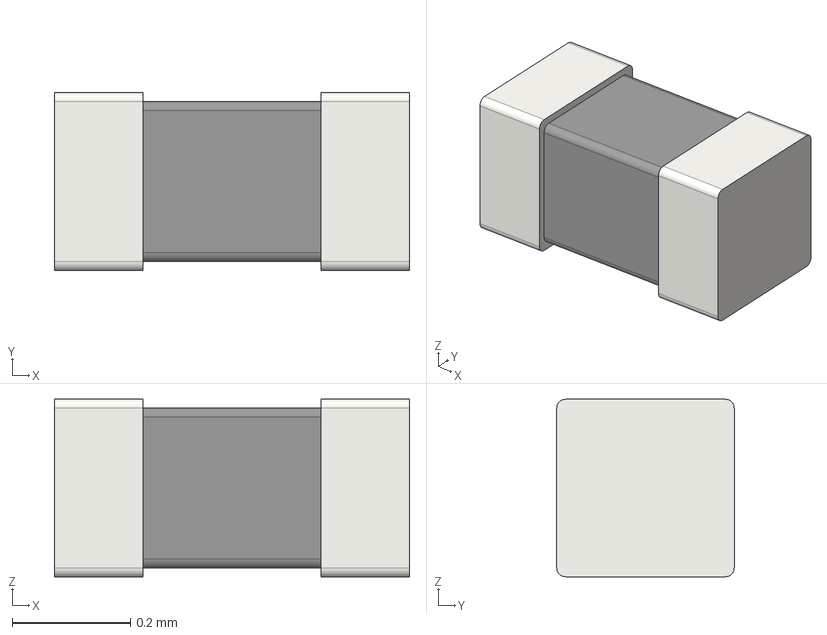
[picture p138: CAD file, 2026-11-01]
boards/neurband_c/layout/models/L_0201_0603Metric.step
0.6 x 0.3 x 0.3 mm
