jlcjak/neurband/mech/rev_c/button_cap.step

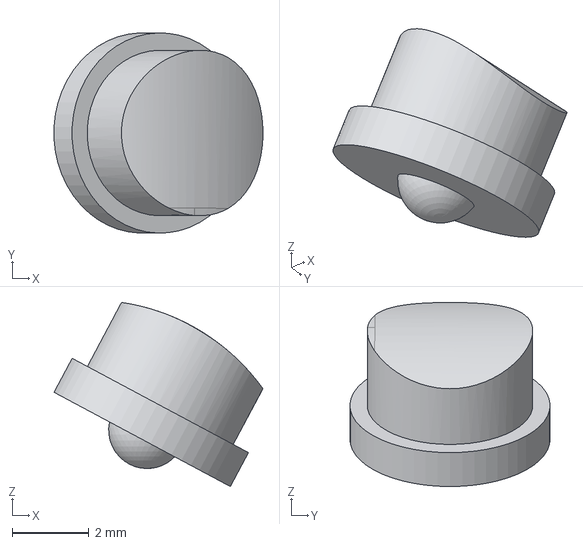
[picture p139: CAD file, 2026-11-01]
mech/rev_c/button_cap.step
5.43 x 5.20 x 4.78 mm
