jlcjak/neurband/mech/strap_M.step

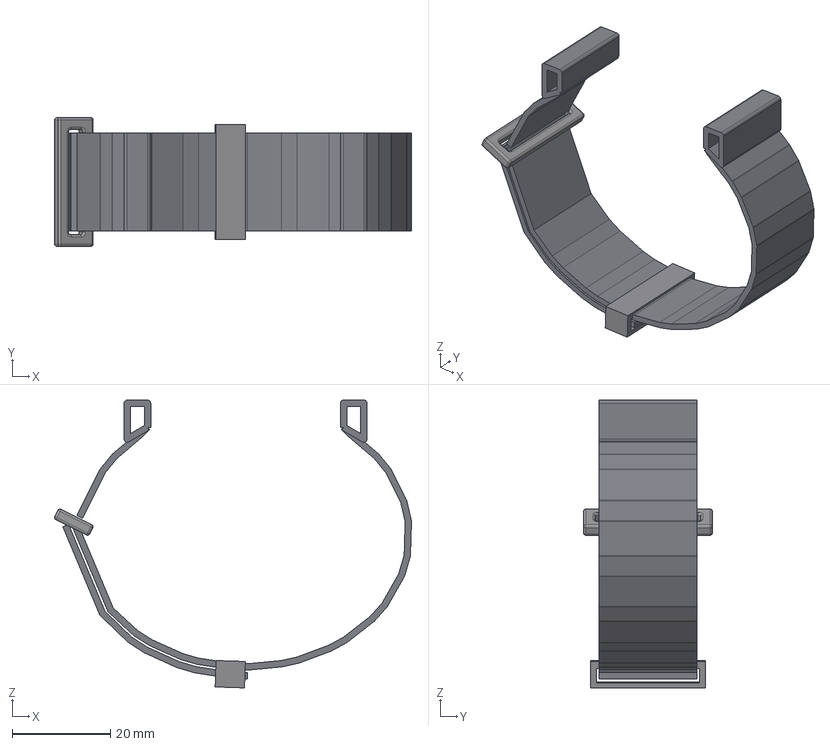
[picture p140: CAD file, 2026-10-26]
mech/strap_M.step
72.9 x 26.3 x 58.7 mm
strap_long
strap_long_001
strap_short
lug_loops
lug_loops_001
ring
keeper
