jlcjak/neurband/boards/neurband_c/layout/models/R_01005_0402Metric.step

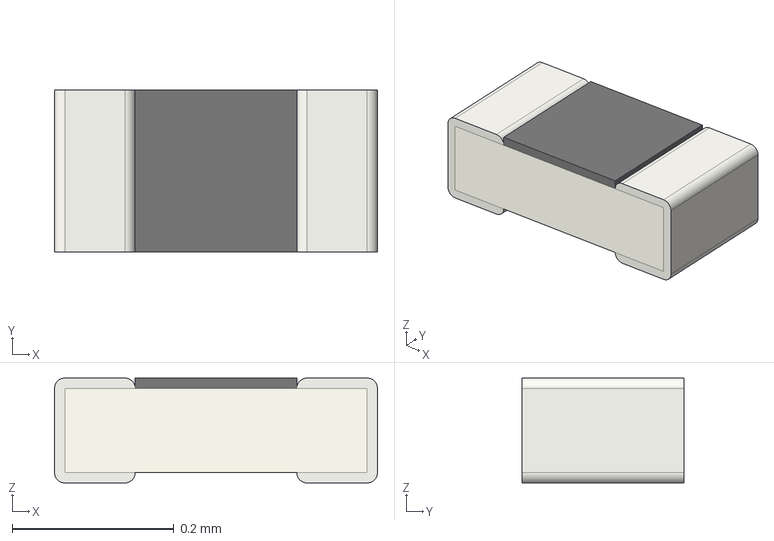
[picture p141: CAD file, 2026-11-01]
boards/neurband_c/layout/models/R_01005_0402Metric.step
0.4 x 0.2 x 0.13 mm
