jlcjak/neurband/mech/rev_c/swd_jig_fit.step

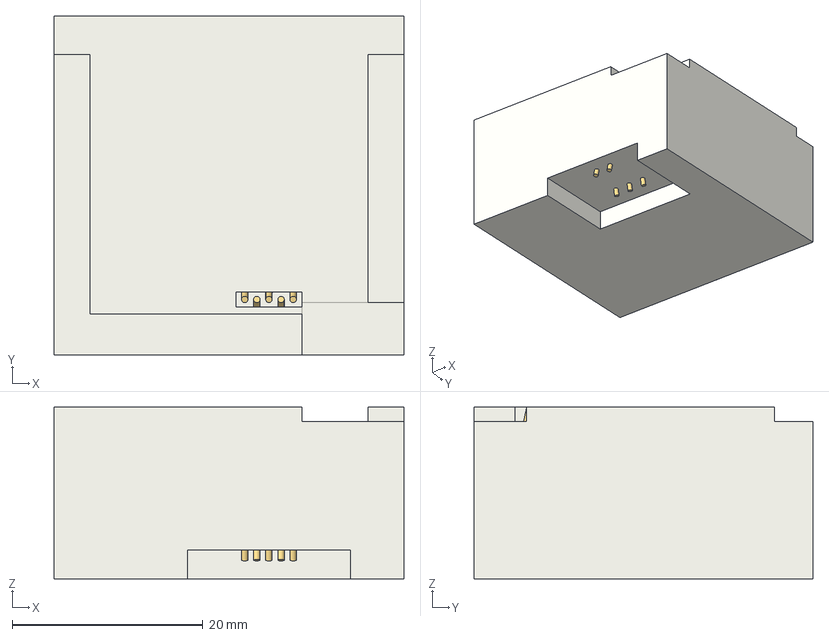
[picture p142: CAD file, 2026-10-29]
mech/rev_c/swd_jig_fit.step
36.7 x 35.5 x 18.0 mm
swd_jig
pogo_pins
pogo_pins_001
pogo_pins_002
pogo_pins_003
pogo_pins_004
