jlcjak/neurband/mech/strap_S.step

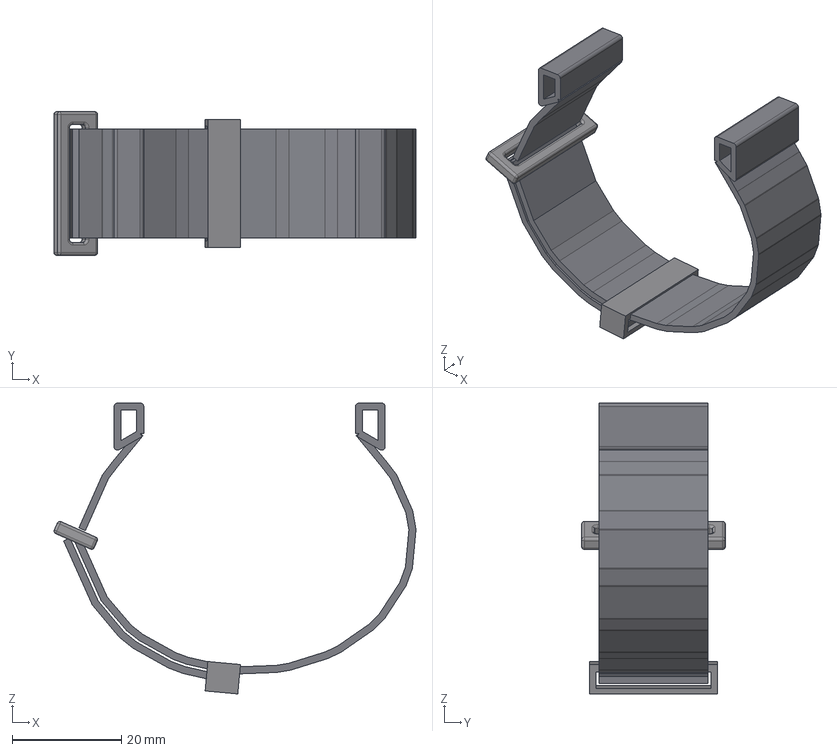
[picture p143: CAD file, 2026-10-26]
mech/strap_S.step
66.2 x 26.3 x 53.2 mm
strap_long
strap_long_001
strap_short
lug_loops
lug_loops_001
ring
keeper
