jlcjak/neurband/mech/rev_c/strap_slide.step

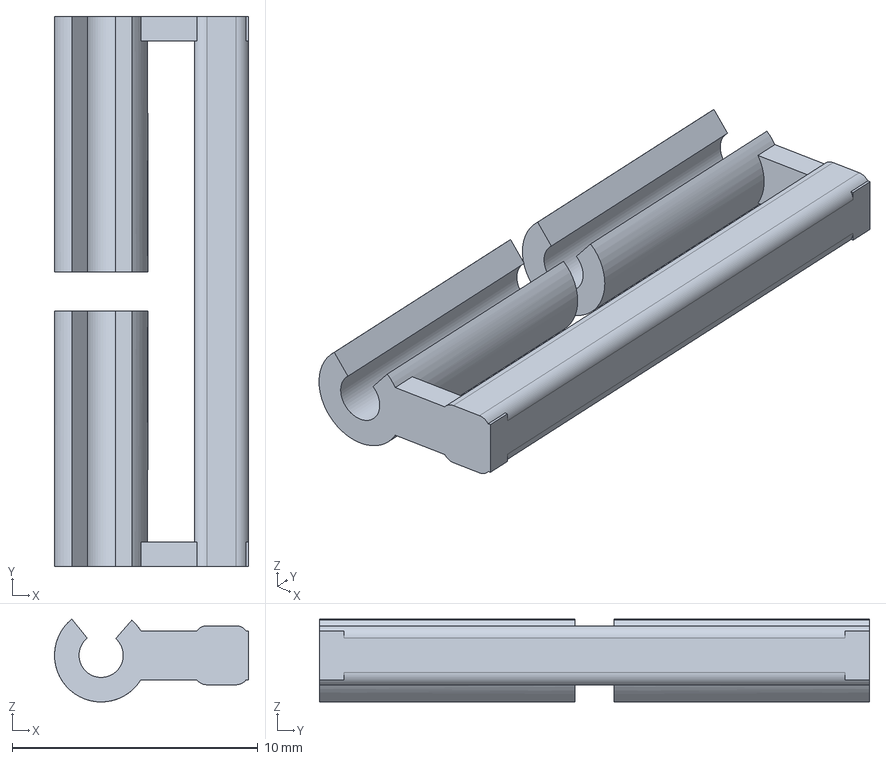
[picture p144: CAD file, 2026-10-29]
mech/rev_c/strap_slide.step
7.90 x 22.4 x 3.38 mm
