jlcjak/neurband/mech/rev_c/charge_clip_fit.step

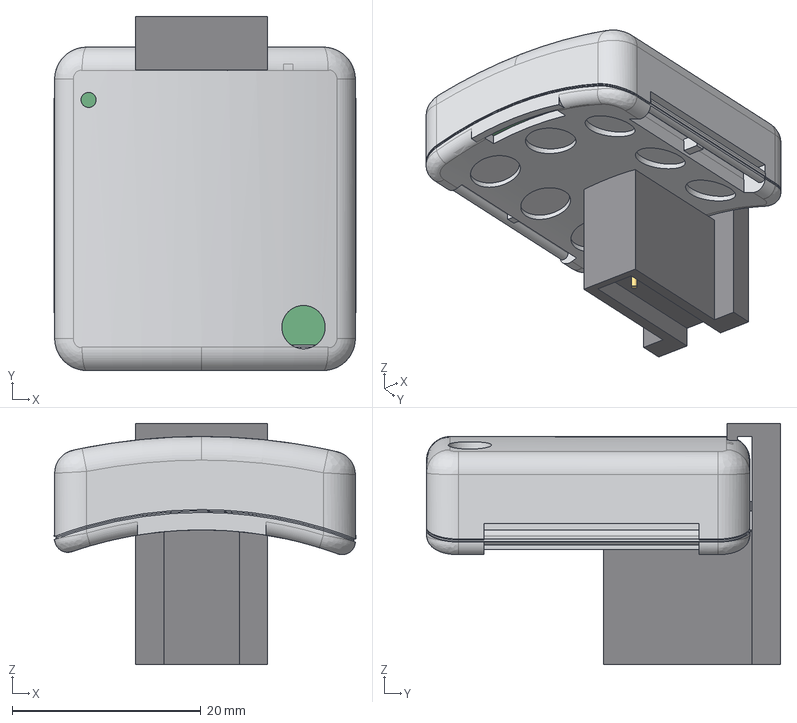
[picture p145: CAD file, 2026-10-29]
mech/rev_c/charge_clip_fit.step
32.0 x 37.5 x 25.6 mm
charge_clip
module_base
module_lid
pogo_pins
pogo_pins_001
main_board
