jlcjak/neurband/mech/rev_c/charge_clip.step

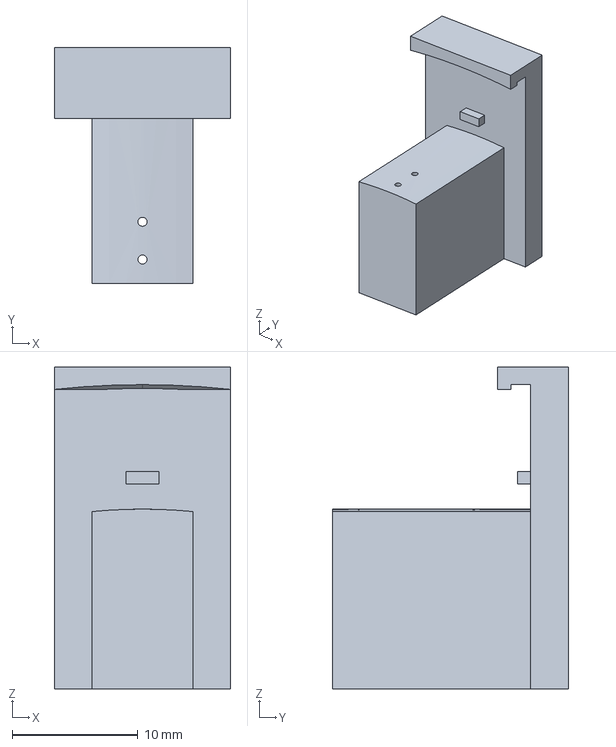
[picture p146: CAD file, 2026-10-29]
mech/rev_c/charge_clip.step
14.0 x 18.8 x 25.6 mm
