jlcjak/neurband/boards/neurband_c/layout/models/XUNPU_FPC-05F-20PH20.step

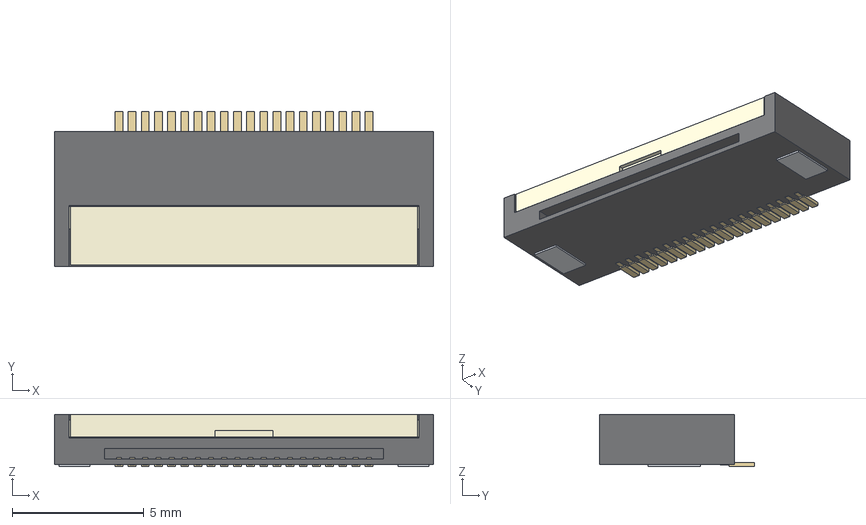
[picture p147: CAD file, 2026-10-26]
boards/neurband_c/layout/models/XUNPU_FPC-05F-20PH20.step
14.4 x 5.89 x 1.98 mm
DarkHousing
ClosedCreamFlipbar
TwentyBottomContacts
SolderAnchors
