jlcjak/neurband/mech/rev_c/swd_jig.step

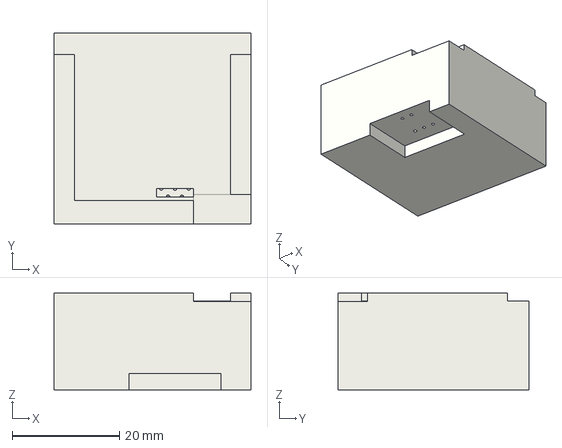
[picture p148: CAD file, 2026-10-29]
mech/rev_c/swd_jig.step
36.7 x 35.5 x 18.0 mm
