jlcjak/neurband/mech/rev_c/module_section.step

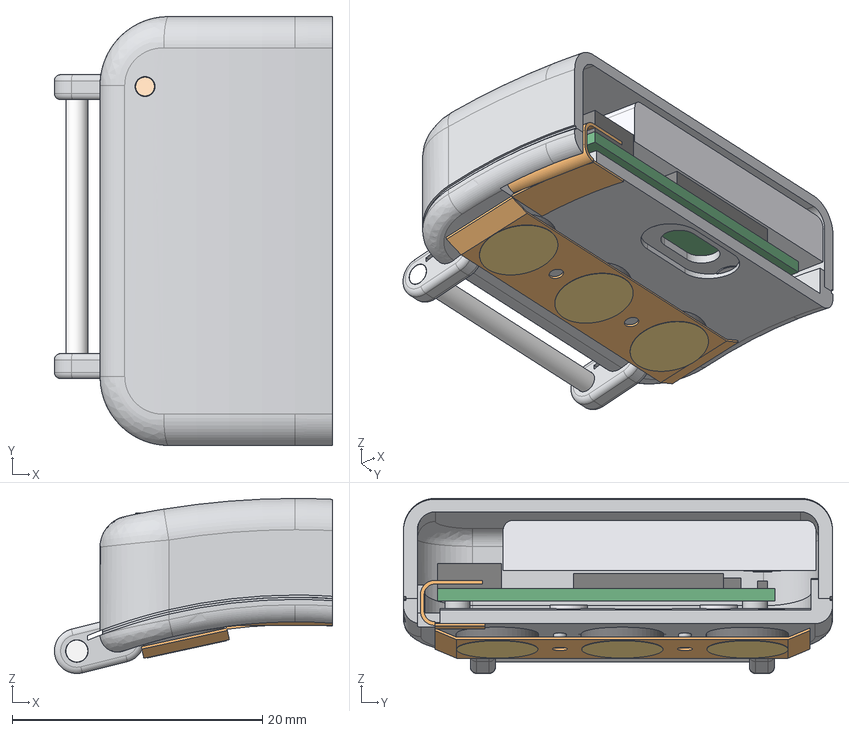
[picture p149: CAD file, 2026-10-26]
mech/rev_c/module_section.step
22.2 x 34.3 x 14.0 mm
module_base
module_lid
main_board
board_parts
board_parts_002
board_parts_003
board_parts_004
lipo
tail
flex_pods_3_4
pads
pads_001
pads_002
foam
foam_001
foam_002
magnets
magnets_001
strap_bars
light_pipe
