jlcjak/neurband/(list of files, cad)

Other CAD files:
mech/rev_c/ref/neurband_c_parts.step
boards/neurband_c/layout/models/C_01005_0402Metric.step
boards/neurband_c/layout/models/C_0805_2012Metric.step
boards/neurband_c/layout/models/C_0603_1608Metric.step
boards/neurband_c/layout/models/C_0402_1005Metric.step
boards/neurband_c/layout/models/C_0201_0603Metric.step
.archive/neurband_main_revA/layout/models/ESP32-S3-MINI-1-N8.step
.archive/neurband_main_revA/layout/models/HCTL_HC-FPC-05-09-40RLTAG.step
.archive/neurband_main_revB/layout/models/ESP32-C3-MINI-1.step
.archive/neurband_main_revB/layout/models/ESP32-S3-MINI-1-N8.step
.archive/neurband_main_revB/layout/models/HCTL_HC-FPC-05-09-40RLTAG.step
boards/neurband_c/layout/models/NRF52832_QFAA.step
boards/neurband_c_old/layout/models/NRF52832_QFAA.step
