jlcjak/neurband/docs/media/assembly.gif

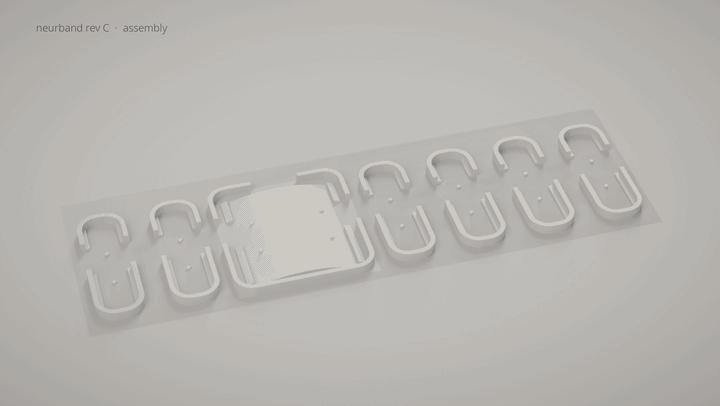
docs/media/assembly.gif
