jlcjak/neurband/docs/media/assembly_r2.gif

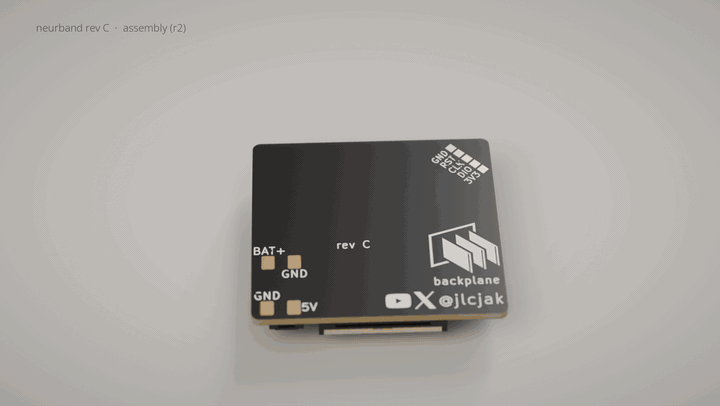
docs/media/assembly_r2.gif
