jlcjak/neurband/mech/rev_c/renders/band_assembly.right.png

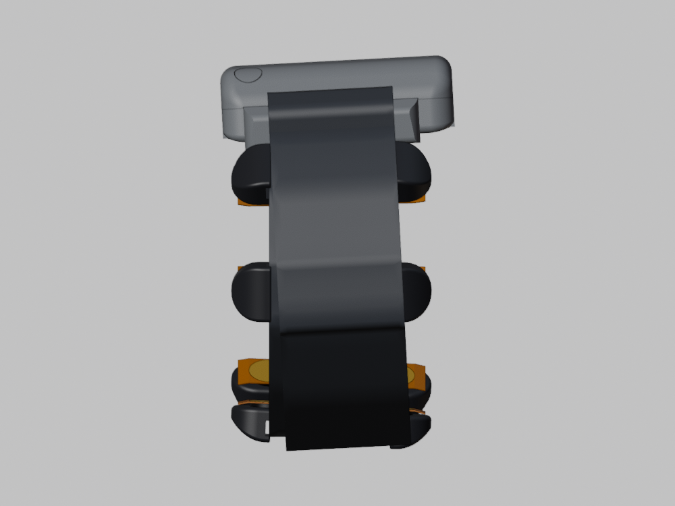
mech/rev_c/renders/band_assembly.right.png
