jlcjak/neurband/mech/rev_c/renders/band_assembly.top.png

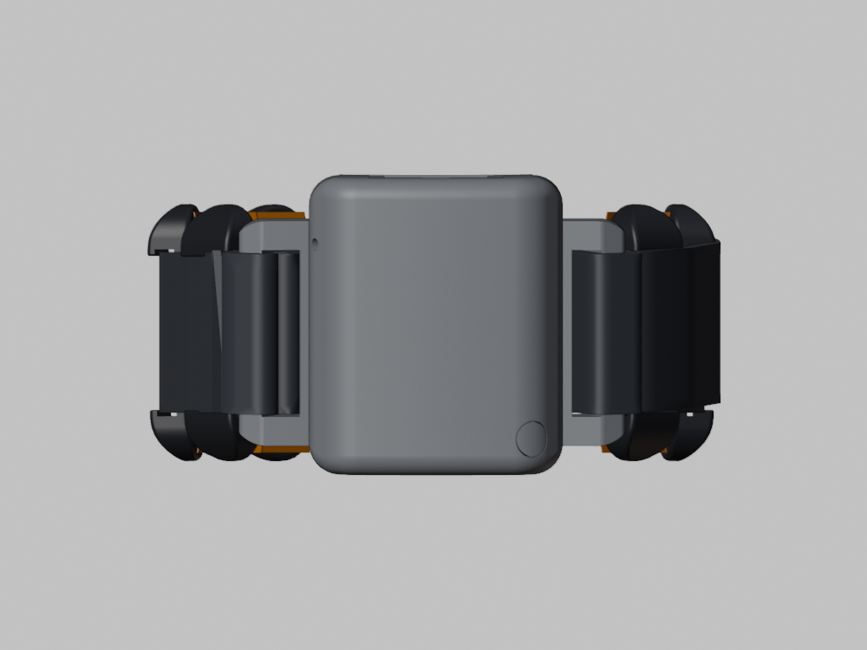
mech/rev_c/renders/band_assembly.top.png
