jlcjak/neurband/boards/neurband_c_flex/neurband_c_flex.kicad_pcb

## KiCad design boards/neurband_c_flex/neurband_c_flex.kicad_pcb (2026-11-02)

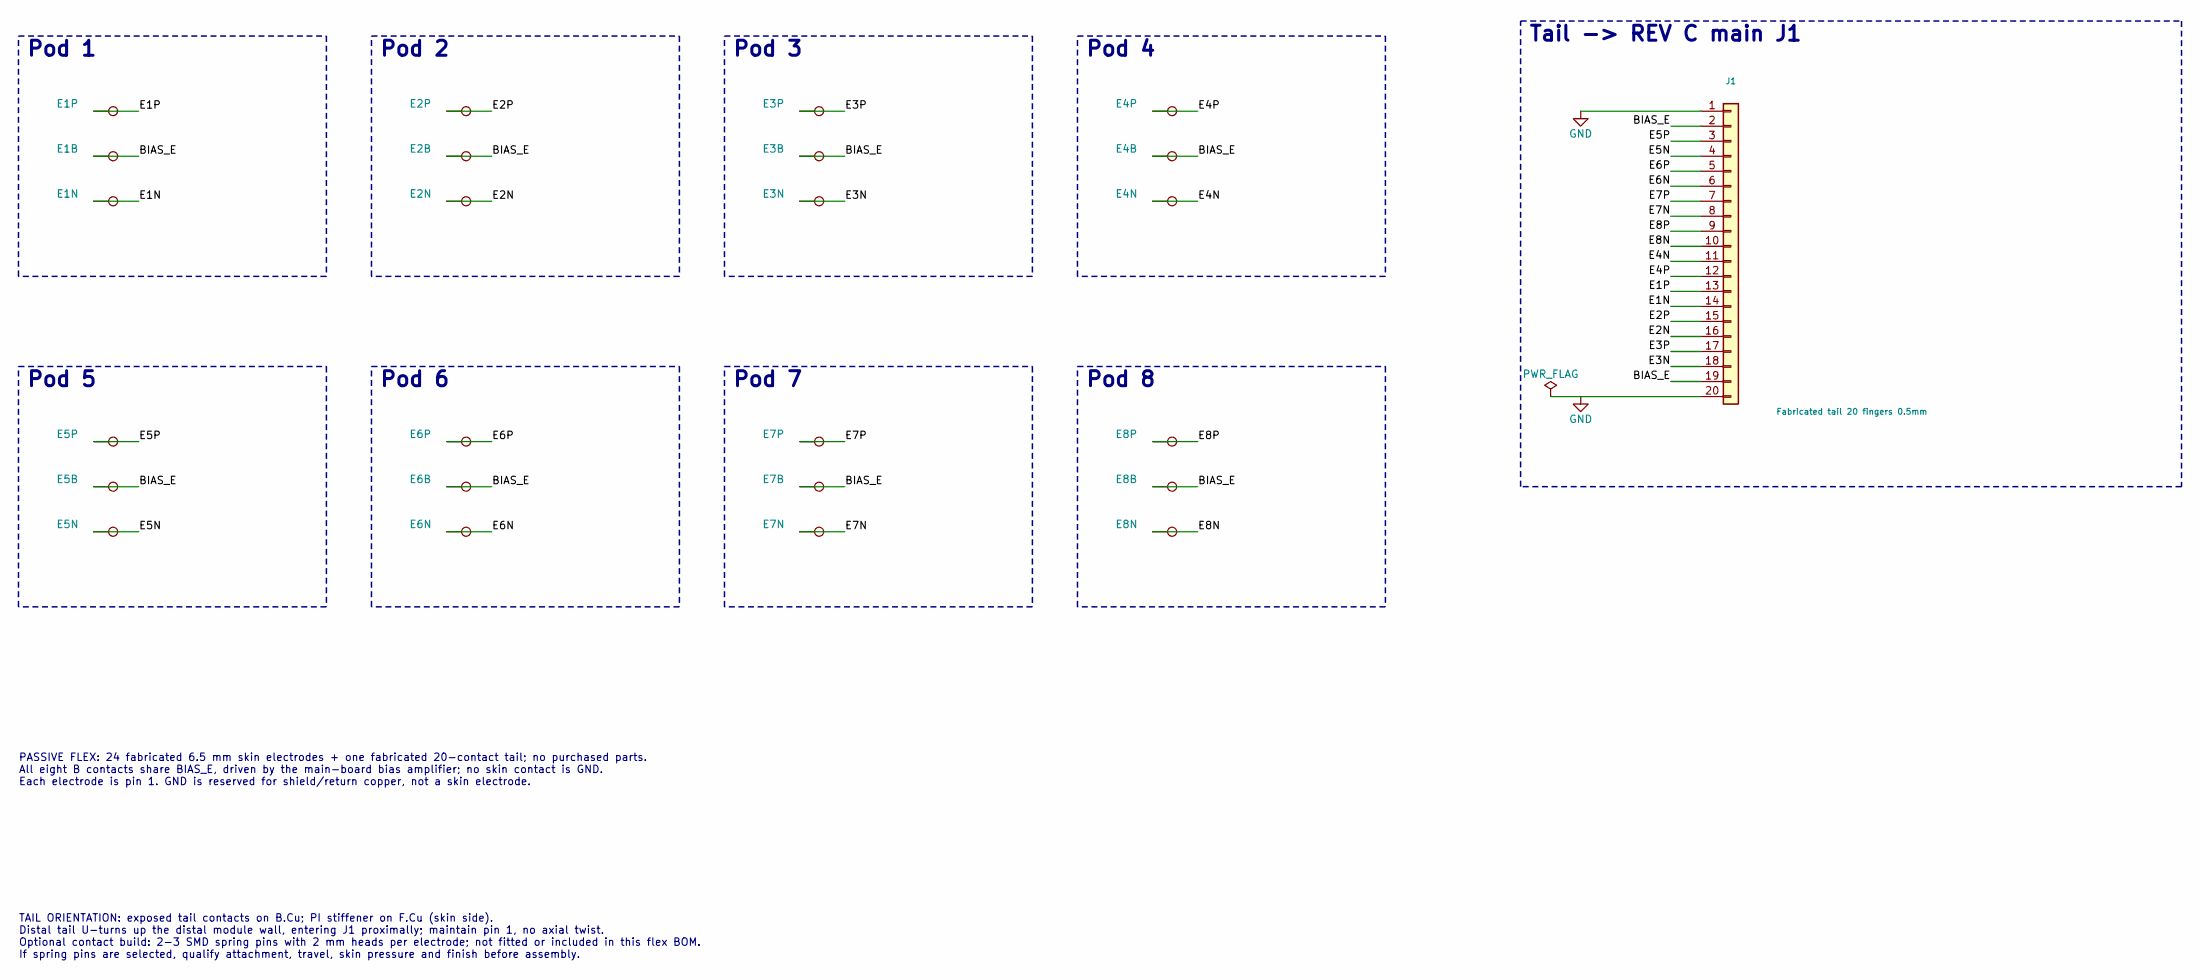
[picture p207: schematic neurband_c_flex.kicad_sch, neurband REV C passive flex: 8 pods x 3 electrodes]

Parts:
E1B, E2B, E3B, E4B, E5B, E6B, E7B, E8B: Fabricated electrode B; Electrode_D6.5mm
E1N, E2N, E3N, E4N, E5N, E6N, E7N, E8N: Fabricated electrode N; Electrode_D6.5mm
E1P, E2P, E3P, E4P, E5P, E6P, E7P, E8P: Fabricated electrode P; Electrode_D6.5mm
J1: Fabricated tail 20 fingers 0.5mm; FPC_Tail_20_P0.5mm

Connections:
/BIAS_E: E1B.1, E2B.1, E3B.1, E4B.1, E5B.1, E6B.1, E7B.1, E8B.1, J1.2, J1.19
/E1N: E1N.1, J1.14
/E1P: E1P.1, J1.13
/E2N: E2N.1, J1.16
/E2P: E2P.1, J1.15
/E3N: E3N.1, J1.18
/E3P: E3P.1, J1.17
/E4N: E4N.1, J1.11
/E4P: E4P.1, J1.12
/E5N: E5N.1, J1.4
/E5P: E5P.1, J1.3
/E6N: E6N.1, J1.6
/E6P: E6P.1, J1.5
/E7N: E7N.1, J1.8
/E7P: E7P.1, J1.7
/E8N: E8N.1, J1.10
/E8P: E8P.1, J1.9
GND: J1.1, J1.20

Notes on the sheet:
Tail -> REV C main J1
Pod 1
Pod 2
Pod 3
Pod 4
Pod 5
Pod 6
Pod 7
Pod 8
PASSIVE FLEX: 24 fabricated 6.5 mm skin electrodes + one fabricated 20-contact tail; no purchased parts. All eight B contacts share BIAS_E, driven by the main-board bias amplifier; no skin contact is GND. Each electrode is pin 1. GND is reserved for shield/return copper, not a skin electrode.
TAIL ORIENTATION: exposed tail contacts on B.Cu; PI stiffener on F.Cu (skin side). Distal tail U-turns up the distal module wall, entering J1 proximally; maintain pin 1, no axial twist. Optional contact build: 2-3 SMD spring pins with 2 mm heads per electrode; not fitted or included in this flex BO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

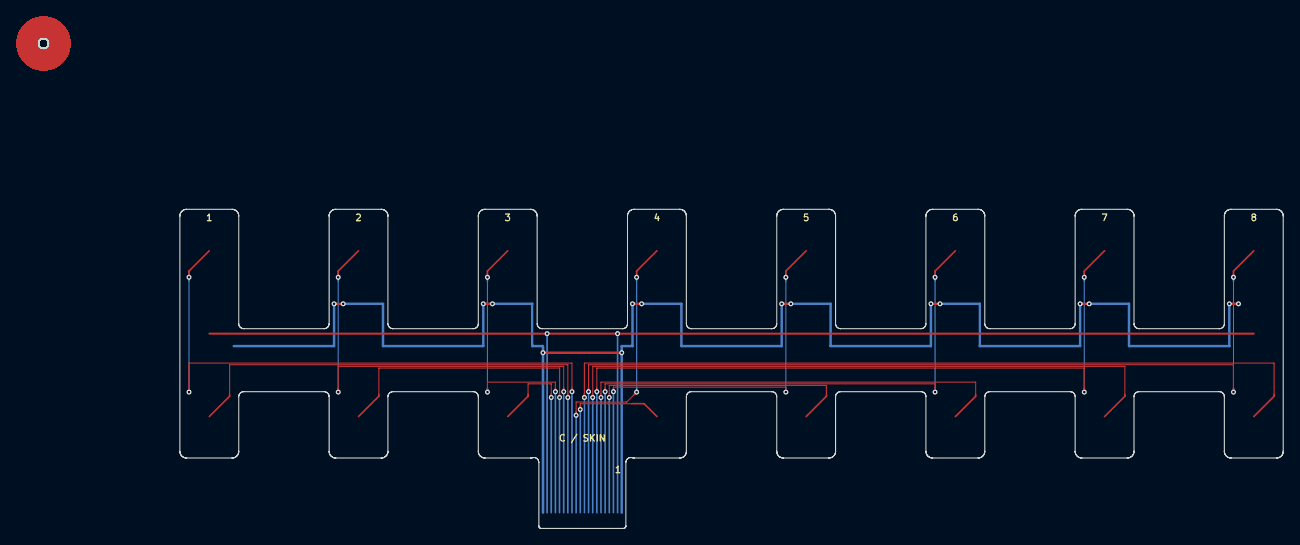
[picture p208: board neurband_c_flex.kicad_pcb from above]

Board: 2 copper layers, 133.1 x 38.5 mm, 41 parts (1 on the bottom side), 18 nets.

Other parts of the board:
H10, H11, H20, H21, H30, H31, H40, H41, H50, H51, H60, H61, H70, H71, H80, H81: Alignment 1.2mm; Alignment_D1.2mm
