jlcjak/neurband/boards/neurband_c/neurband_c.kicad_pcb

## KiCad design boards/neurband_c/neurband_c.kicad_pcb (2026-11-02)

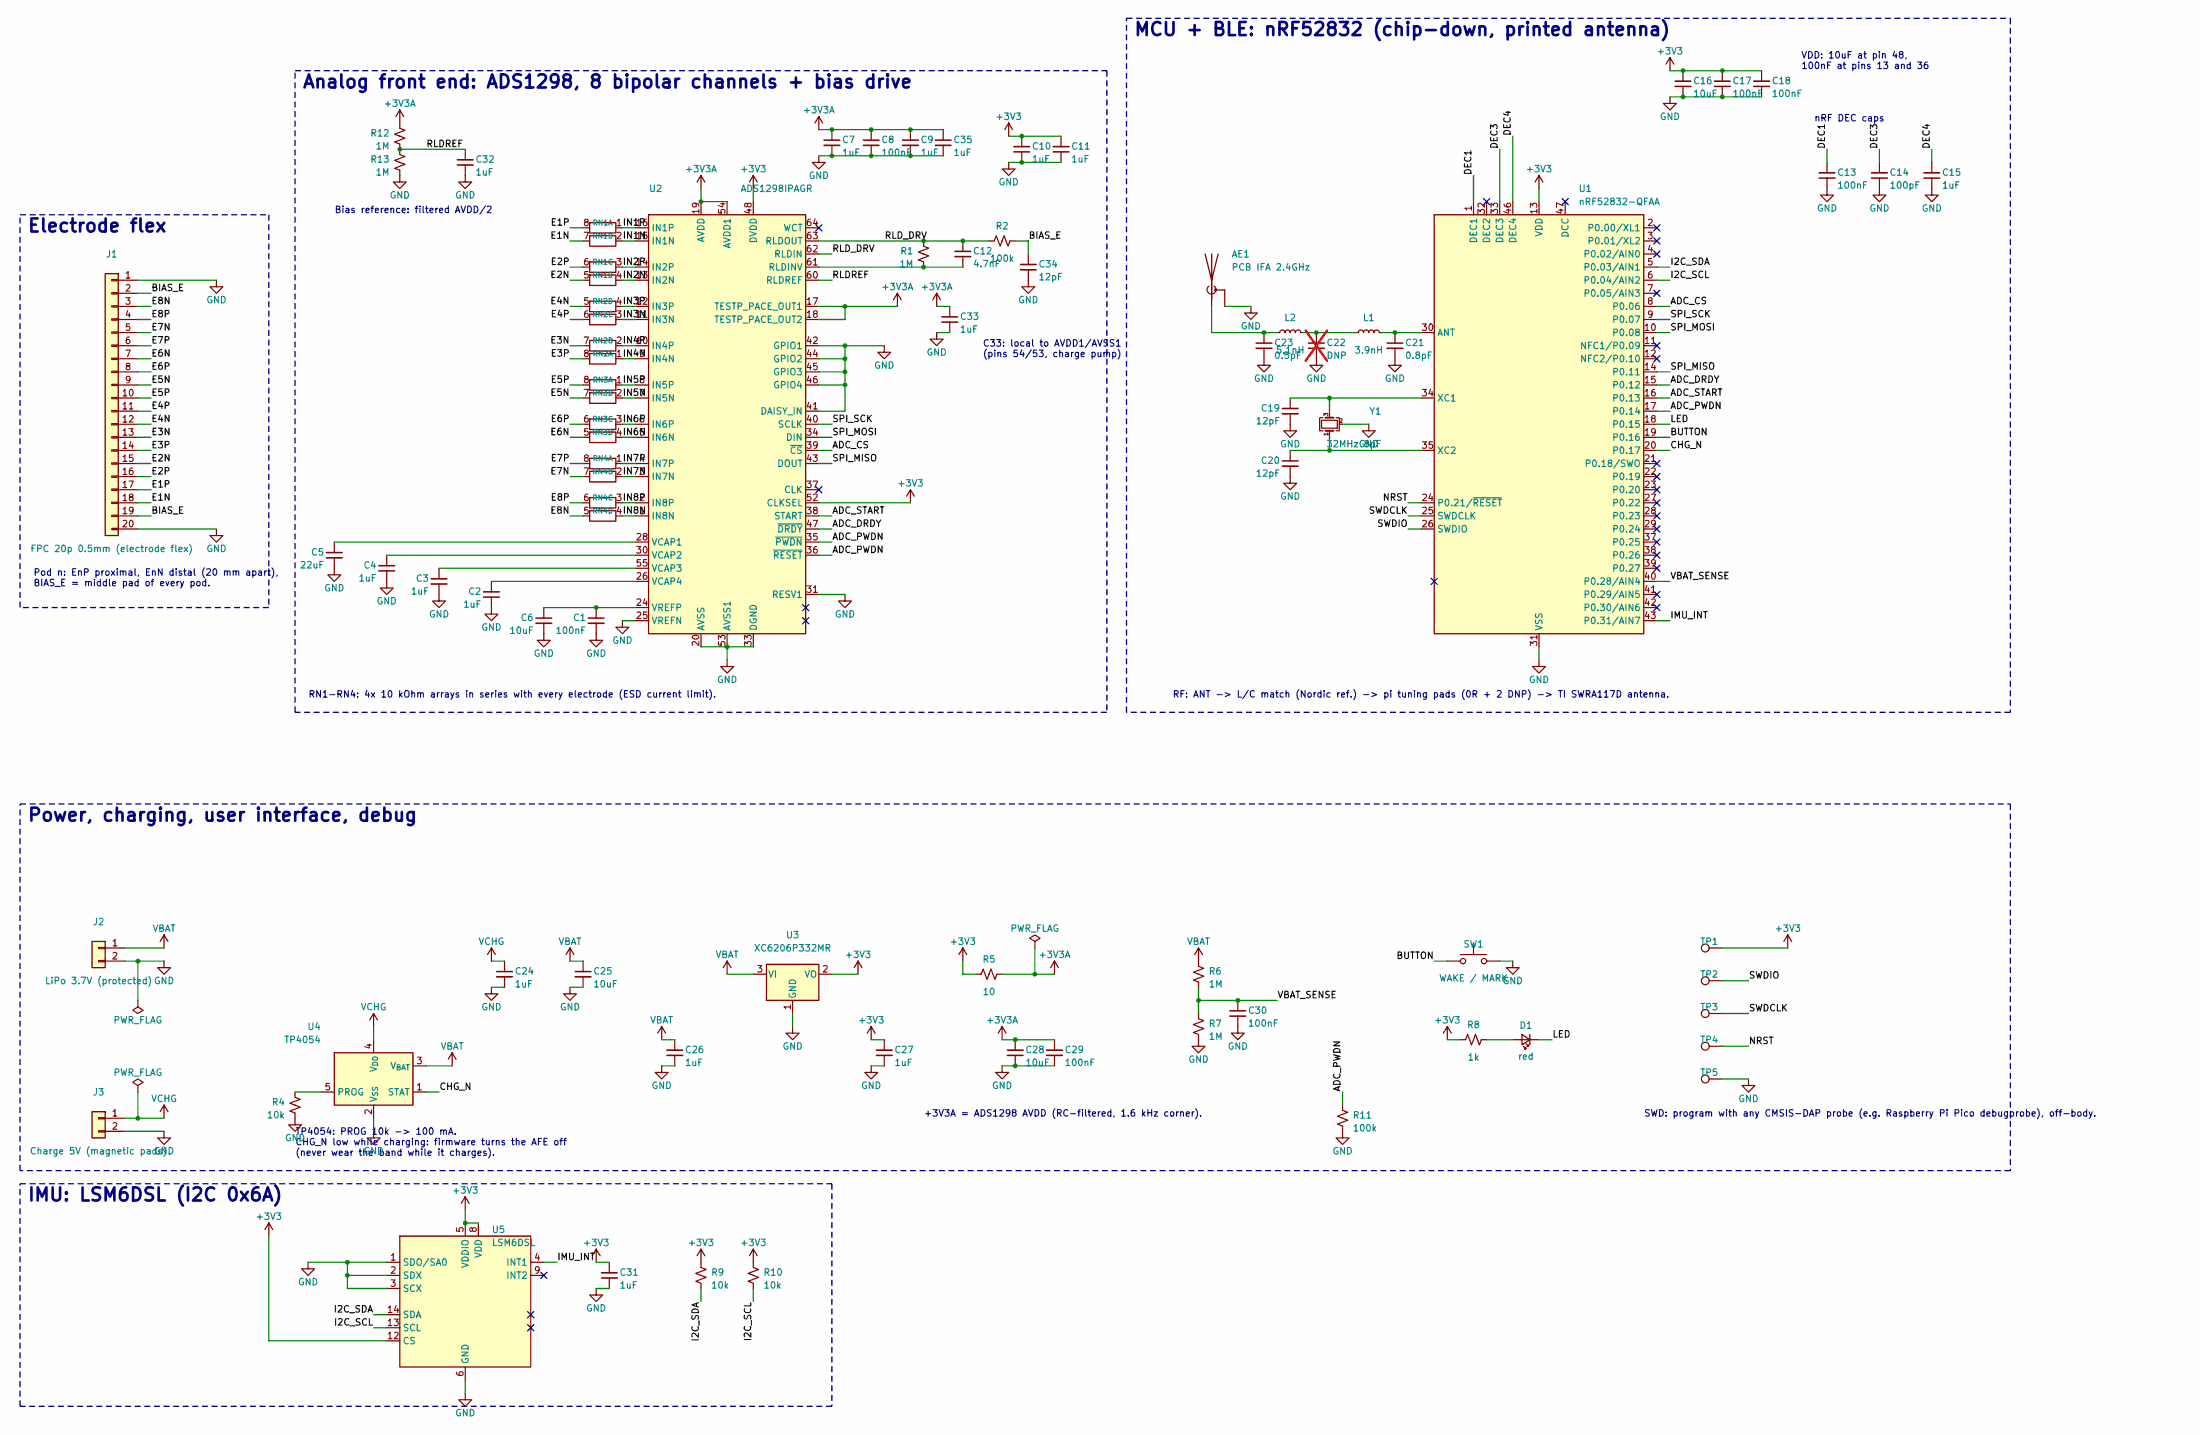
[picture p209: schematic neurband_c.kicad_sch, neurband rev C: 8-ch sEMG, nRF52832 BLE, ADS1298]

Parts:
AE1: PCB IFA 2.4GHz; Texas_SWRA117D_2.4GHz_Left
C1, C8, C13, C17, C18, C29, C30: 100nF; C_0402_Small; MPN CL05B104KO5NNNC; LCSC C1525
C2, C3, C4, C7, C9, C10, C11, C15, C24, C26, C27, C31, C32, C33, C35: 1uF; C_0402_Small; MPN CL05A105KA5NQNC; LCSC C52923
C5: 22uF; C_0603_Small; MPN CL10A226MQ8NRNC; LCSC C59461
C6, C16, C25, C28: 10uF; C_0603_Small; MPN CL10A106KP8NNNC; LCSC C19702
C12: 4.7nF; C_0402_Small; MPN 0402B472K500NT; LCSC C1538
C14: 100pF; C_0402_Small; MPN 0402CG101J500NT; LCSC C1546
C19, C20, C34: 12pF; C_0402_Small; MPN 0402CG120J500NT; LCSC C1547
C21: 0.8pF; C_0402_Small; MPN 0402CG0R8B500NT; LCSC C285068
C22: DNP; C_0402_Small; not fitted
C23: 0.5pF; C_0402_Small; MPN 0402CG0R5B500NT; LCSC C285052
D1: red; LED_0603_1608Metric; MPN KT-0603R; LCSC C2286
J1: FPC 20p 0.5mm (electrode flex); XUNPU_FPC-05F-20PH20_Centroid; MPN FPC-05F-20PH20; LCSC C2856803
J2: LiPo 3.7V (protected); WirePads_2x1.5x2mm_P3mm
J3: Charge 5V (magnetic pads); WirePads_2x1.5x2mm_P3mm
L1: 3.9nH; L_0402_Small; MPN SDCL1005C3N9STDF; LCSC C14033
L2: 5.1nH; L_0402_Small; MPN SDCL1005C5N1STDF; LCSC C33114
R1, R6, R7, R12, R13: 1M; R_0402_Small; MPN 0402WGF1004TCE; LCSC C26083
R2, R11: 100k; R_0402_Small; MPN 0402WGF1003TCE; LCSC C25741
R4, R9, R10: 10k; R_0402_Small; MPN 0402WGF1002TCE; LCSC C25744
R5: 10; R_0402_Small; MPN 0402WGF100JTCE; LCSC C25077
R8: 1k; R_0402_Small; MPN 0402WGF1001TCE; LCSC C11702
RN1, RN2, RN3, RN4: 10k; R_Array_Convex_4x0603_FabZero; MPN 4D03WGJ0103T5E; LCSC C29718
SW1: WAKE / MARK; SW_SPST_TS-1088-xR020; MPN TS-1088-AR02016; LCSC C720477
TP1, TP2, TP3, TP4, TP5: pad; SWD_Pad_1x1_P1.27
U1: nRF52832-QFAA; QFN-48-1EP_6x6mm_P0.4mm_EP4.6x4.6mm_FabZero; MPN NRF52832-QFAA-R; LCSC C77540
U2: ADS1298IPAGR; TQFP-64_10x10mm_P0.5mm_FabZero; MPN ADS1298IPAGR; LCSC C527440
U3: XC6206P332MR; SOT-23-3_FabZero; MPN XC6206P332MR-G; LCSC C5446
U4: TP4054; SOT-23-5_FabZero; MPN TP4054-42-SOT25R; LCSC C32574
U5: LSM6DSL; LGA-14_3x2.5mm_P0.5mm_LayoutBorder3x4y; MPN LSM6DSLTR; LCSC C126672
Y1: 32MHz 8pF; Crystal_SMD_2016-4Pin_2.0x1.6mm; MPN X201632MKB4SI; LCSC C718072

Connections:
+3V3: C10.1, C11.1, C16.1, C17.1, C18.1, C27.1, C31.1, R5.1, R8.1, R9.1, R10.1, TP1.1 (1_1), U1.13 (VDD), U1.36 (VDD), U1.48 (VDD), U2.48 (DVDD), U2.50 (DVDD), U2.52 (CLKSEL), U3.2 (VO), U5.5 (VDDIO), U5.8 (VDD), U5.12 (CS)
+3V3A: C7.1, C8.1, C9.1, C28.1, C29.1, C33.1, C35.1, R5.2, R12.1, U2.17 (TESTP_PACE_OUT1), U2.18 (TESTP_PACE_OUT2), U2.19 (AVDD), U2.21 (AVDD), U2.22 (AVDD), U2.54 (AVDD1), U2.56 (AVDD), U2.59 (AVDD)
/ADC_CS: U1.8 (P0.06), U2.39 (~CS)
/ADC_DRDY: U1.15 (P0.12), U2.47 (~DRDY)
/ADC_PWDN: R11.1, U1.17 (P0.14), U2.35 (~PWDN), U2.36 (~RESET)
/ADC_START: U1.16 (P0.13), U2.38 (START)
/BIAS_E: C34.1, J1.2, J1.19, R2.2
/BUTTON: SW1.1, U1.19 (P0.16)
/CHG_N: U1.20 (P0.17), U4.1 (STAT)
/DEC1: C13.1, U1.1 (DEC1)
/DEC3: C14.1, U1.33 (DEC3)
/DEC4: C15.1, U1.46 (DEC4)
/E1N: J1.18, RN1.7 (R2.2)
/E1P: J1.17, RN1.8 (R1.2)
/E2N: J1.15, RN1.5 (R4.2)
/E2P: J1.16, RN1.6 (R3.2)
/E3N: J1.13, RN2.7 (R2.2)
/E3P: J1.14, RN2.8 (R1.2)
/E4N: J1.12, RN2.5 (R4.2)
/E4P: J1.11, RN2.6 (R3.2)
/E5N: J1.9, RN3.7 (R2.2)
/E5P: J1.10, RN3.8 (R1.2)
/E6N: J1.7, RN3.5 (R4.2)
/E6P: J1.8, RN3.6 (R3.2)
/E7N: J1.5, RN4.7 (R2.2)
/E7P: J1.6, RN4.8 (R1.2)
/E8N: J1.3, RN4.5 (R4.2)
/E8P: J1.4, RN4.6 (R3.2)
/I2C_SCL: R10.2, U1.6 (P0.04/AIN2), U5.13 (SCL)
/I2C_SDA: R9.2, U1.5 (P0.03/AIN1), U5.14 (SDA)
/IMU_INT: U1.43 (P0.31/AIN7), U5.4 (INT1)
/IN1N: RN1.2 (R2.1), U2.15 (IN1N)
/IN1P: RN1.1 (R1.1), U2.16 (IN1P)
/IN2N: RN1.4 (R4.1), U2.13 (IN2N)
/IN2P: RN1.3 (R3.1), U2.14 (IN2P)
/IN3N: RN2.3 (R3.1), U2.11 (IN3N)
/IN3P: RN2.4 (R4.1), U2.12 (IN3P)
/IN4N: RN2.1 (R1.1), U2.9 (IN4N)
/IN4P: RN2.2 (R2.1), U2.10 (IN4P)
/IN5N: RN3.2 (R2.1), U2.7 (IN5N)
/IN5P: RN3.1 (R1.1), U2.8 (IN5P)
/IN6N: RN3.4 (R4.1), U2.5 (IN6N)
/IN6P: RN3.3 (R3.1), U2.6 (IN6P)
/IN7N: RN4.2 (R2.1), U2.3 (IN7N)
/IN7P: RN4.1 (R1.1), U2.4 (IN7P)
/IN8N: RN4.4 (R4.1), U2.1 (IN8N)
/IN8P: RN4.3 (R3.1), U2.2 (IN8P)
/LED: D1.1 (K), U1.18 (P0.15)
/NRST: TP4.1 (1_1), U1.24 (P0.21/~RESET)
/RLDREF: C32.1, R12.2, R13.1, U2.60 (RLDREF)
/RLD_DRV: C12.1, R1.1, R2.1, U2.62 (RLDIN), U2.63 (RLDOUT)
/SPI_MISO: U1.14 (P0.11), U2.43 (DOUT)
/SPI_MOSI: U1.10 (P0.08), U2.34 (DIN)
/SPI_SCK: U1.9 (P0.07), U2.40 (SCLK)
/SWDCLK: TP3.1 (1_1), U1.25 (SWDCLK)
/SWDIO: TP2.1 (1_1), U1.26 (SWDIO)
/VBAT_SENSE: C30.1, R6.2, R7.1, U1.40 (P0.28/AIN4)
GND: AE1.2 (Shield), C1.2, C2.2, C3.2, C4.2, C5.2, C6.2, C7.2, C8.2, C9.2, C10.2, C11.2, C13.2, C14.2, C15.2, C16.2, C17.2, C18.2, C19.2, C20.2, C21.2, C22.2, C23.2, C24.2, C25.2, C26.2, C27.2, C28.2, C29.2, C30.2, C31.2, C32.2, C33.2, C34.2, C35.2, J1.1, J1.20, J2.2, J3.2, R4.2, R7.2, R11.2, R13.2, SW1.2, TP5.1 (1_1), U1.31 (VSS), U1.45 (VSS), U1.49 (VSS), U2.20 (AVSS), U2.23 (AVSS), U2.25 (VREFN), U2.31 (RESV1), U2.32 (AVSS), U2.33 (DGND), U2.41 (DAISY_IN), U2.42 (GPIO1), U2.44 (GPIO2), U2.45 (GPIO3), U2.46 (GPIO4), U2.49 (DGND), U2.51 (DGND), U2.53 (AVSS1), U2.57 (AVSS), U2.58 (AVSS), U3.1 (GND), U4.2 (V_{SS}), U5.1 (SDO/SA0), U5.2 (SDX), U5.3 (SCX), U5.6 (GND), U5.7 (GND), Y1.2 (G), Y1.4 (G)
unnamed: AE1.1 (A), C23.1, L2.1
unnamed: C22.1, L1.1, L2.2
unnamed: D1.2 (A), R8.2
unnamed: C21.1, L1.2, U1.30 (ANT)
unnamed: C19.1, U1.34 (XC1), Y1.3
unnamed: C20.1, U1.35 (XC2), Y1.1
unnamed: C12.2, R1.2, U2.61 (RLDINV)
unnamed: C5.1, U2.28 (VCAP1)
unnamed: C4.1, U2.30 (VCAP2)
unnamed: C3.1, U2.55 (VCAP3)
unnamed: C2.1, U2.26 (VCAP4)
unnamed: C1.1, C6.1, U2.24 (VREFP)
unnamed: R4.1, U4.5 (PROG)
VBAT: C25.1, C26.1, J2.1, R6.1, U3.3 (VI), U4.3 (V_{BAT})
VCHG: C24.1, J3.1, U4.4 (V_{DD})

Notes on the sheet:
Analog front end: ADS1298, 8 bipolar channels + bias drive
C33: local to AVDD1/AVSS1 (pins 54/53, charge pump)
VDD: 10uF at pin 48, 100nF at pins 13 and 36
nRF DEC caps
MCU + BLE: nRF52832 (chip-down, printed antenna)
TP4054: PROG 10k -> 100 mA. CHG_N low while charging: firmware turns the AFE off (never wear the band while it charges).
IMU: LSM6DSL (I2C 0x6A)
Pod n: EnP proximal, EnN distal (20 mm apart), BIAS_E = middle pad of every pod.
Bias reference: filtered AVDD/2
RN1-RN4: 4x 10 kOhm arrays in series with every electrode (ESD current limit).
Electrode flex
Power, charging, user interface, debug
+3V3A = ADS1298 AVDD (RC-filtered, 1.6 kHz corner).
SWD: program with any CMSIS-DAP probe (e.g. Raspberry Pi Pico debugprobe), off-body.
RF: ANT -> L/C match (Nordic ref.) -> pi tuning pads (0R + 2 DNP) -> TI SWRA117D antenna.

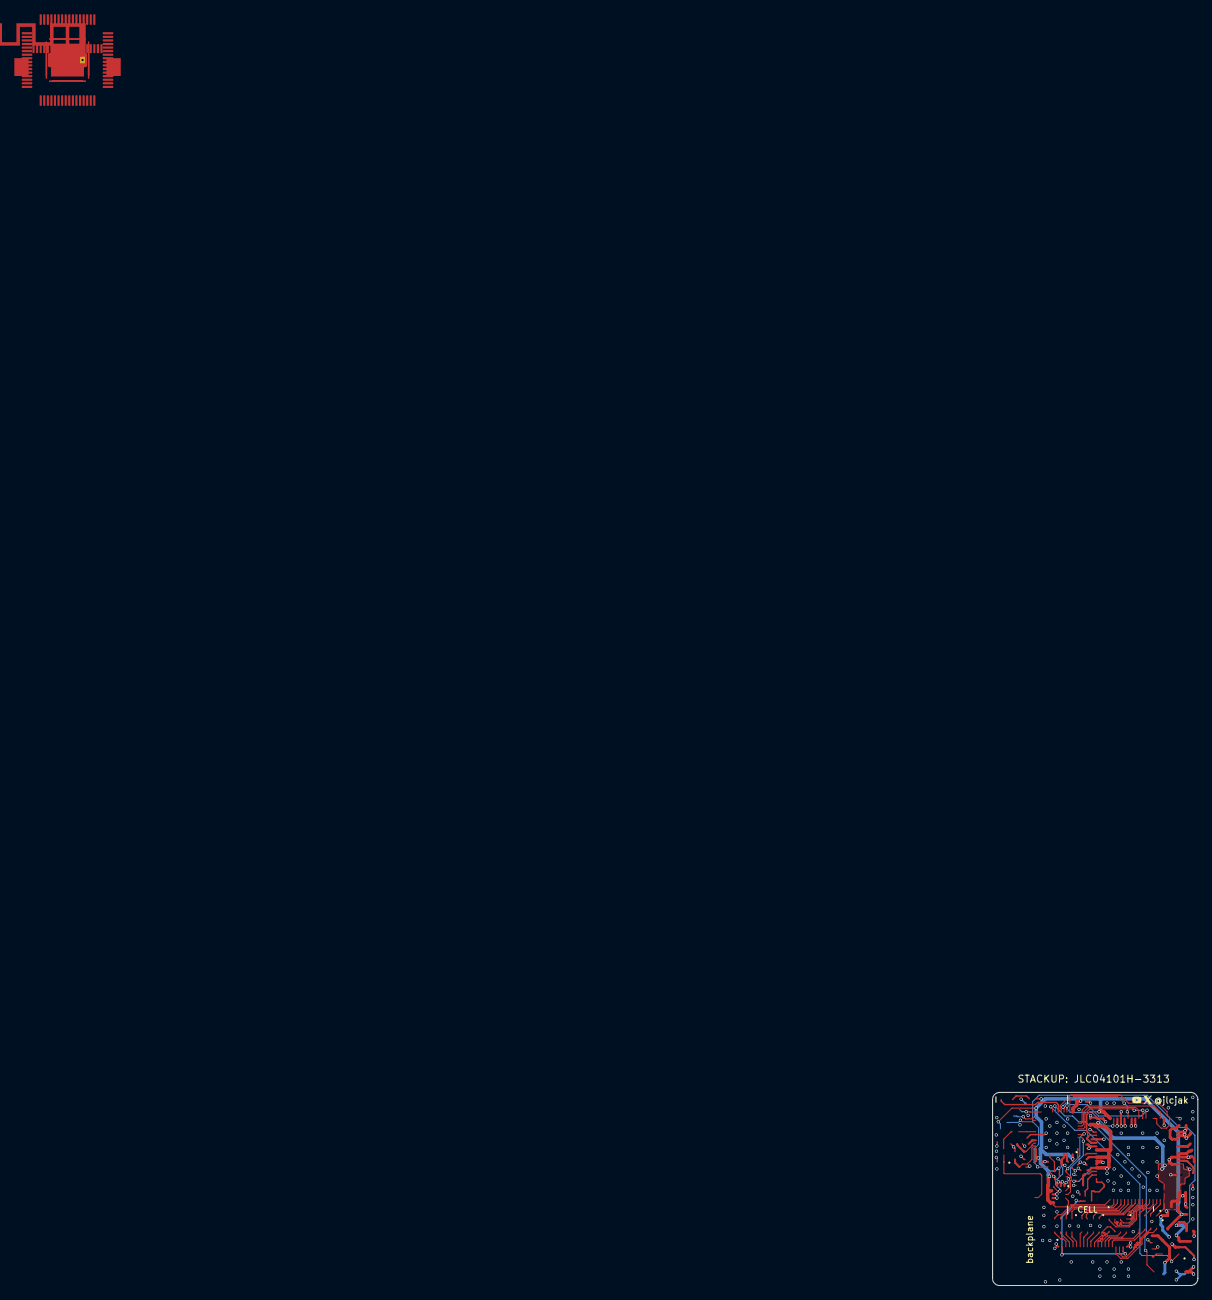
[picture p210: board neurband_c.kicad_pcb from above]

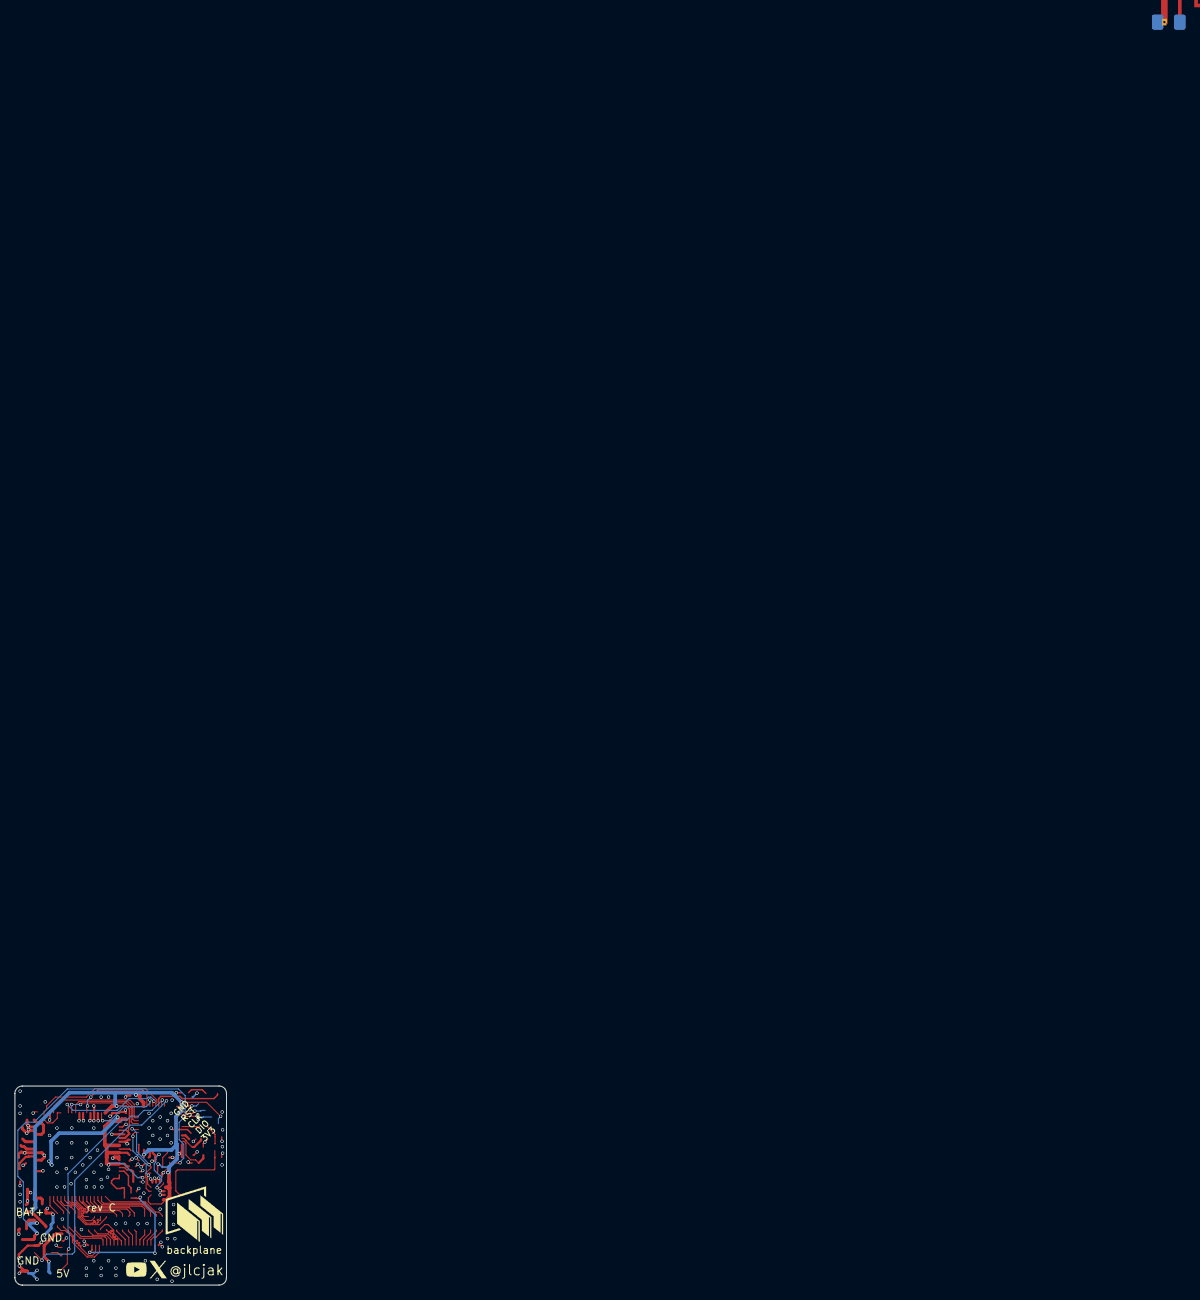
[picture p211: board neurband_c.kicad_pcb from below]

Board: 4 copper layers, 28.7 x 27.0 mm, 70 parts (7 on the bottom side), 73 nets.
