jlcjak/neurband/.archive/neurband_electrodes_revB/neurband_electrodes.kicad_pcb

## KiCad design .archive/neurband_electrodes_revB/neurband_electrodes.kicad_pcb (2026-10-26, an earlier design)

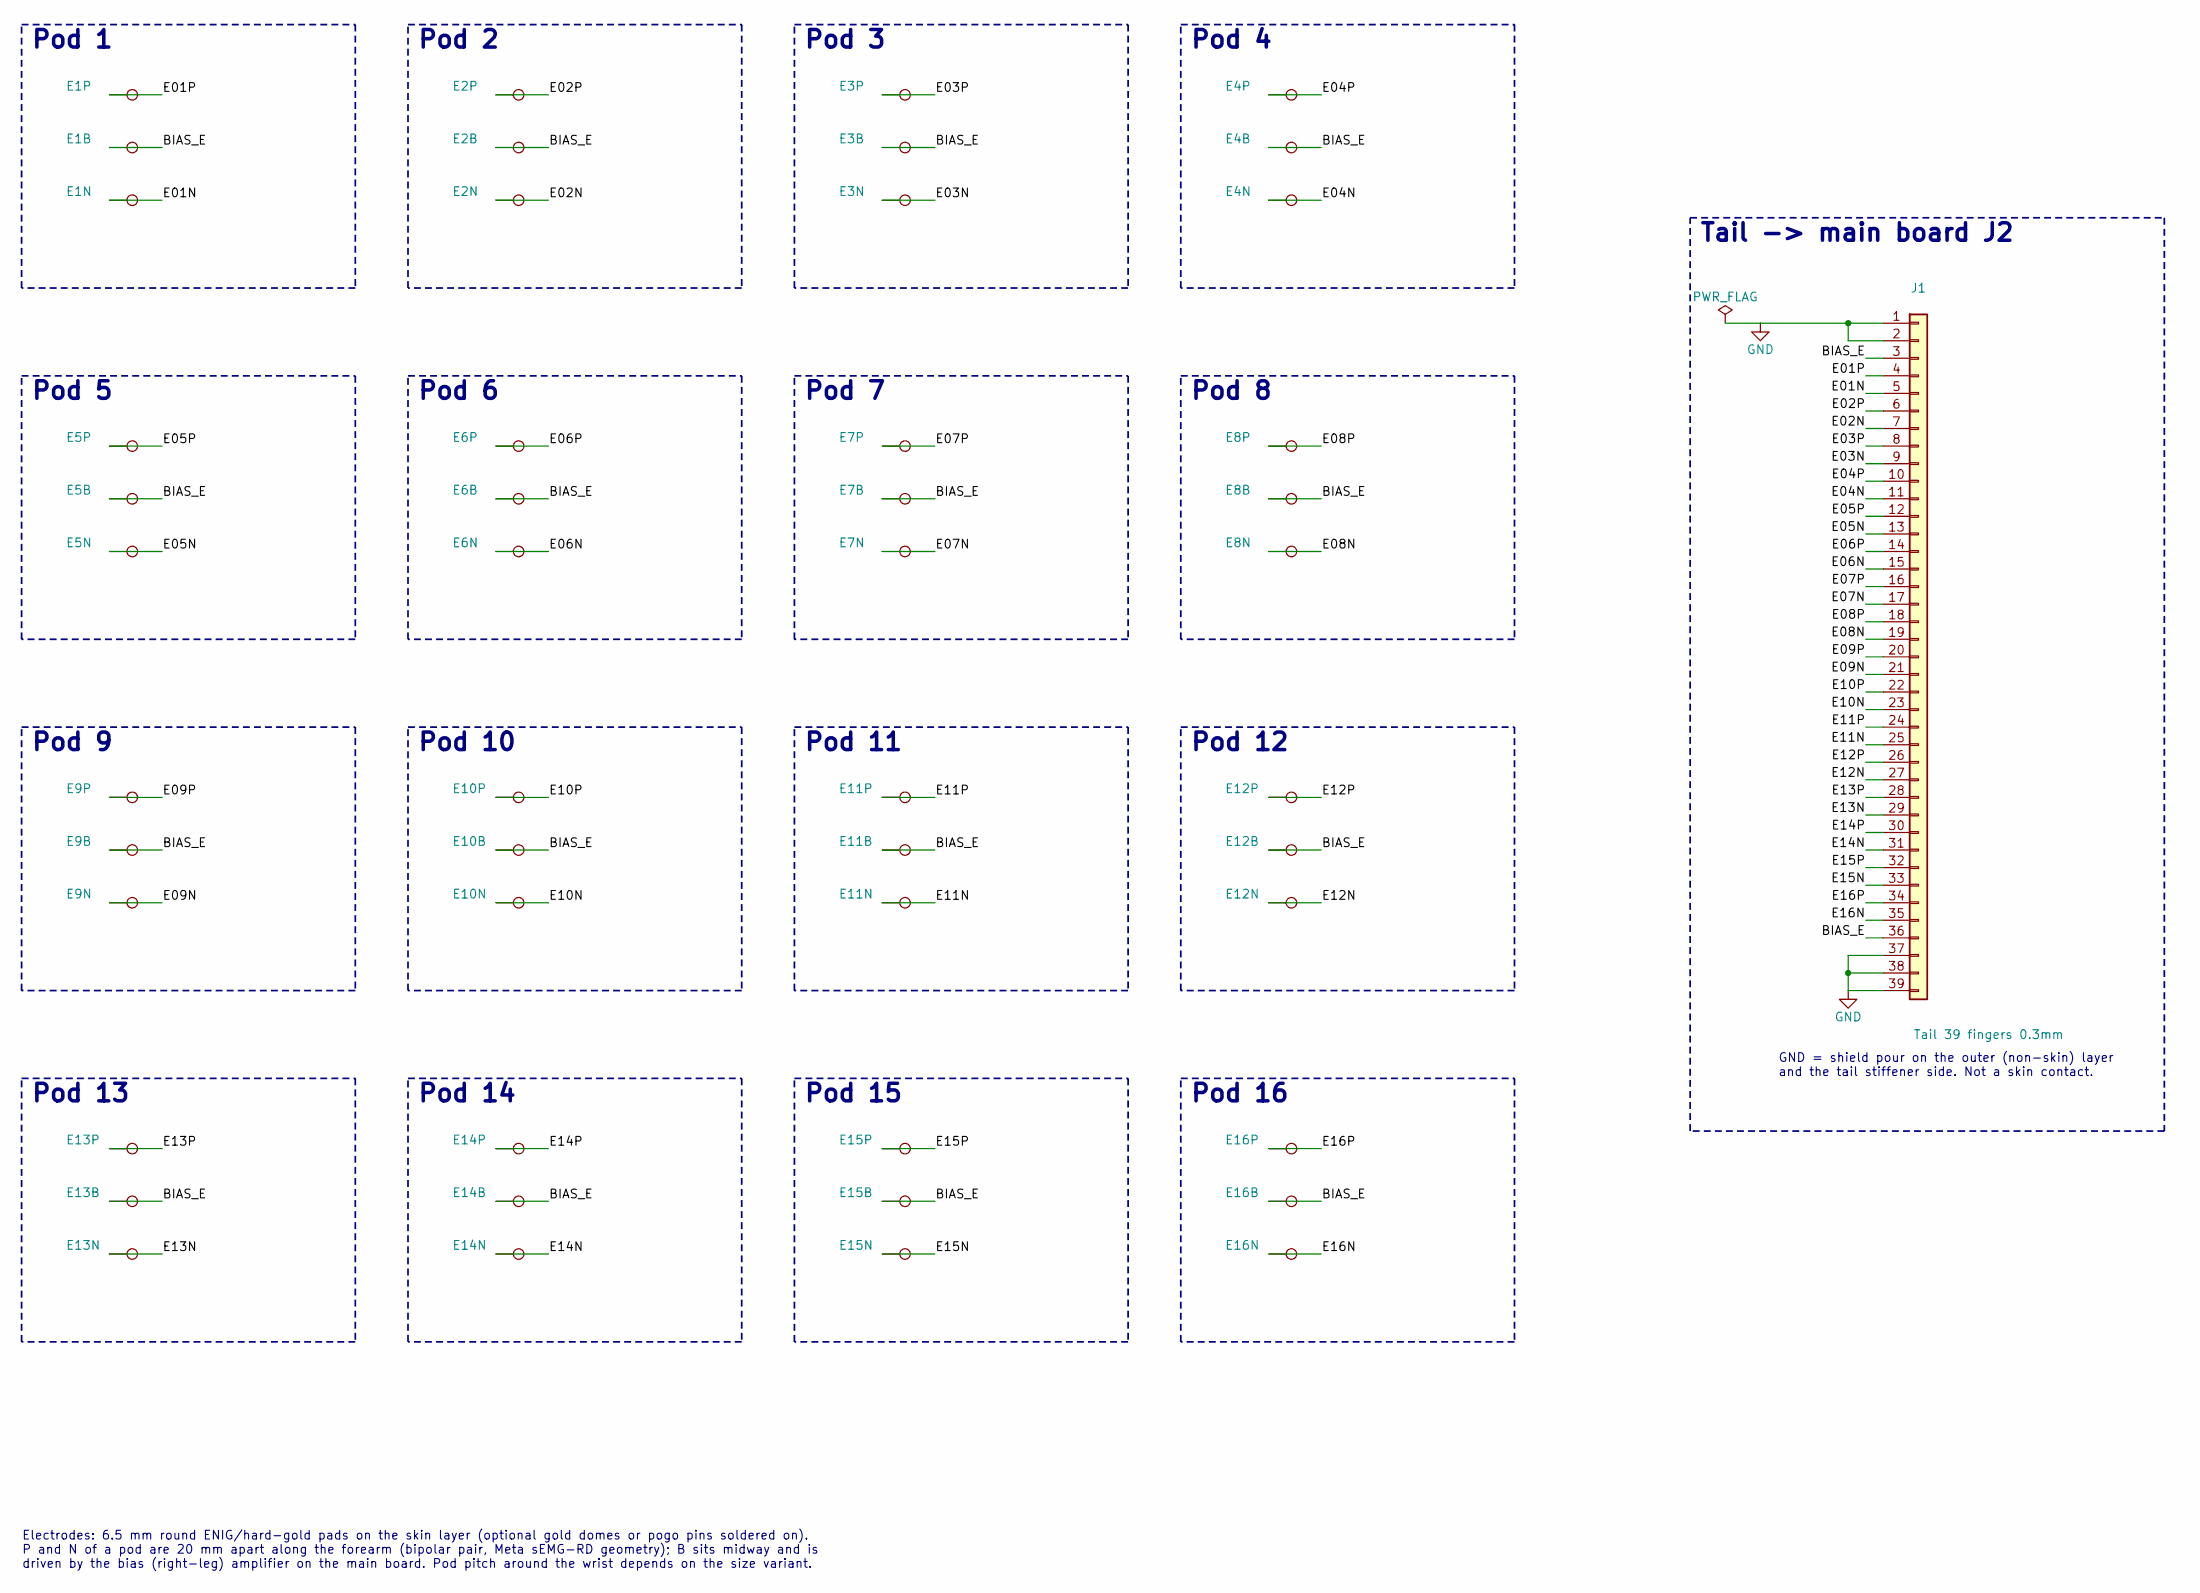
[picture p212: schematic neurband_electrodes.kicad_sch, neurband electrode flex: 16 pods x 3 dry electrodes]

Parts:
E1B, E2B, E3B, E4B, E5B, E6B, E7B, E8B, E9B, E10B, E11B, E12B, E13B, E14B, E15B, E16B: electrode B; Electrode_D6.5mm
E1N, E2N, E3N, E4N, E5N, E6N, E7N, E8N, E9N, E10N, E11N, E12N, E13N, E14N, E15N, E16N: electrode N; Electrode_D6.5mm
E1P, E2P, E3P, E4P, E5P, E6P, E7P, E8P, E9P, E10P, E11P, E12P, E13P, E14P, E15P, E16P: electrode P; Electrode_D6.5mm
J1: Tail 39 fingers 0.3mm; FPC_Tail_39_P0.3mm

Connections:
/BIAS_E: E1B.1, E2B.1, E3B.1, E4B.1, E5B.1, E6B.1, E7B.1, E8B.1, E9B.1, E10B.1, E11B.1, E12B.1, E13B.1, E14B.1, E15B.1, E16B.1, J1.3, J1.36
/E01N: E1N.1, J1.5
/E01P: E1P.1, J1.4
/E02N: E2N.1, J1.7
/E02P: E2P.1, J1.6
/E03N: E3N.1, J1.9
/E03P: E3P.1, J1.8
/E04N: E4N.1, J1.11
/E04P: E4P.1, J1.10
/E05N: E5N.1, J1.13
/E05P: E5P.1, J1.12
/E06N: E6N.1, J1.15
/E06P: E6P.1, J1.14
/E07N: E7N.1, J1.17
/E07P: E7P.1, J1.16
/E08N: E8N.1, J1.19
/E08P: E8P.1, J1.18
/E09N: E9N.1, J1.21
/E09P: E9P.1, J1.20
/E10N: E10N.1, J1.23
/E10P: E10P.1, J1.22
/E11N: E11N.1, J1.25
/E11P: E11P.1, J1.24
/E12N: E12N.1, J1.27
/E12P: E12P.1, J1.26
/E13N: E13N.1, J1.29
/E13P: E13P.1, J1.28
/E14N: E14N.1, J1.31
/E14P: E14P.1, J1.30
/E15N: E15N.1, J1.33
/E15P: E15P.1, J1.32
/E16N: E16N.1, J1.35
/E16P: E16P.1, J1.34
GND: J1.1, J1.2, J1.37, J1.38, J1.39, J1.40

Notes on the sheet:
GND = shield pour on the outer (non-skin) layer and the tail stiffener side. Not a skin contact.
Tail -> main board J2
Pod 1
Pod 2
Pod 3
Pod 4
Pod 5
Pod 6
Pod 7
Pod 8
Pod 9
Pod 10
Pod 11
Pod 12
Pod 13
Pod 14
Pod 15
Pod 16
Electrodes: 6.5 mm round ENIG/hard-gold pads on the skin layer (optional gold domes or pogo pins soldered on). P and N of a pod are 20 mm apart along the forearm (bipolar pair, Meta sEMG-RD geometry); B sits midway and is driven by the bias (right-leg) amplifier on the main board. Pod pitch around 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

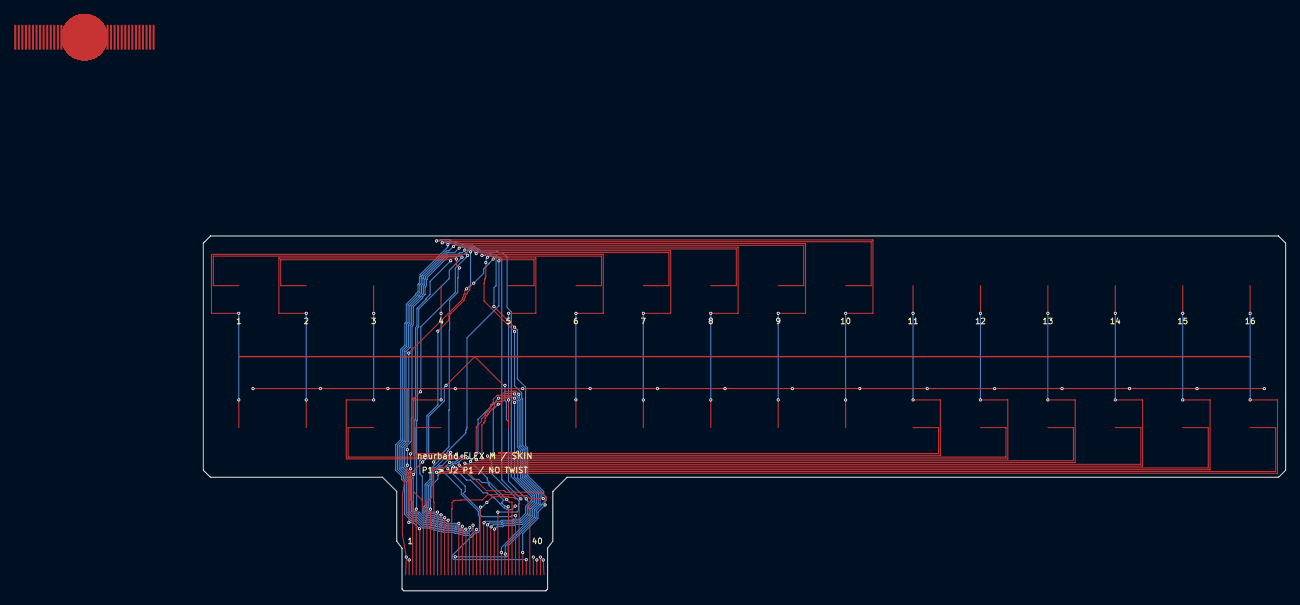
[picture p213: board neurband_electrodes.kicad_pcb from above]

Board: 2 copper layers, 152.5 x 50.0 mm, 49 parts (0 on the bottom side), 34 nets.
