jlcjak/neurband/.archive/neurband_main_revA/neurband_main.kicad_pcb

## KiCad design .archive/neurband_main_revA/neurband_main.kicad_pcb (2026-10-26, an earlier design)

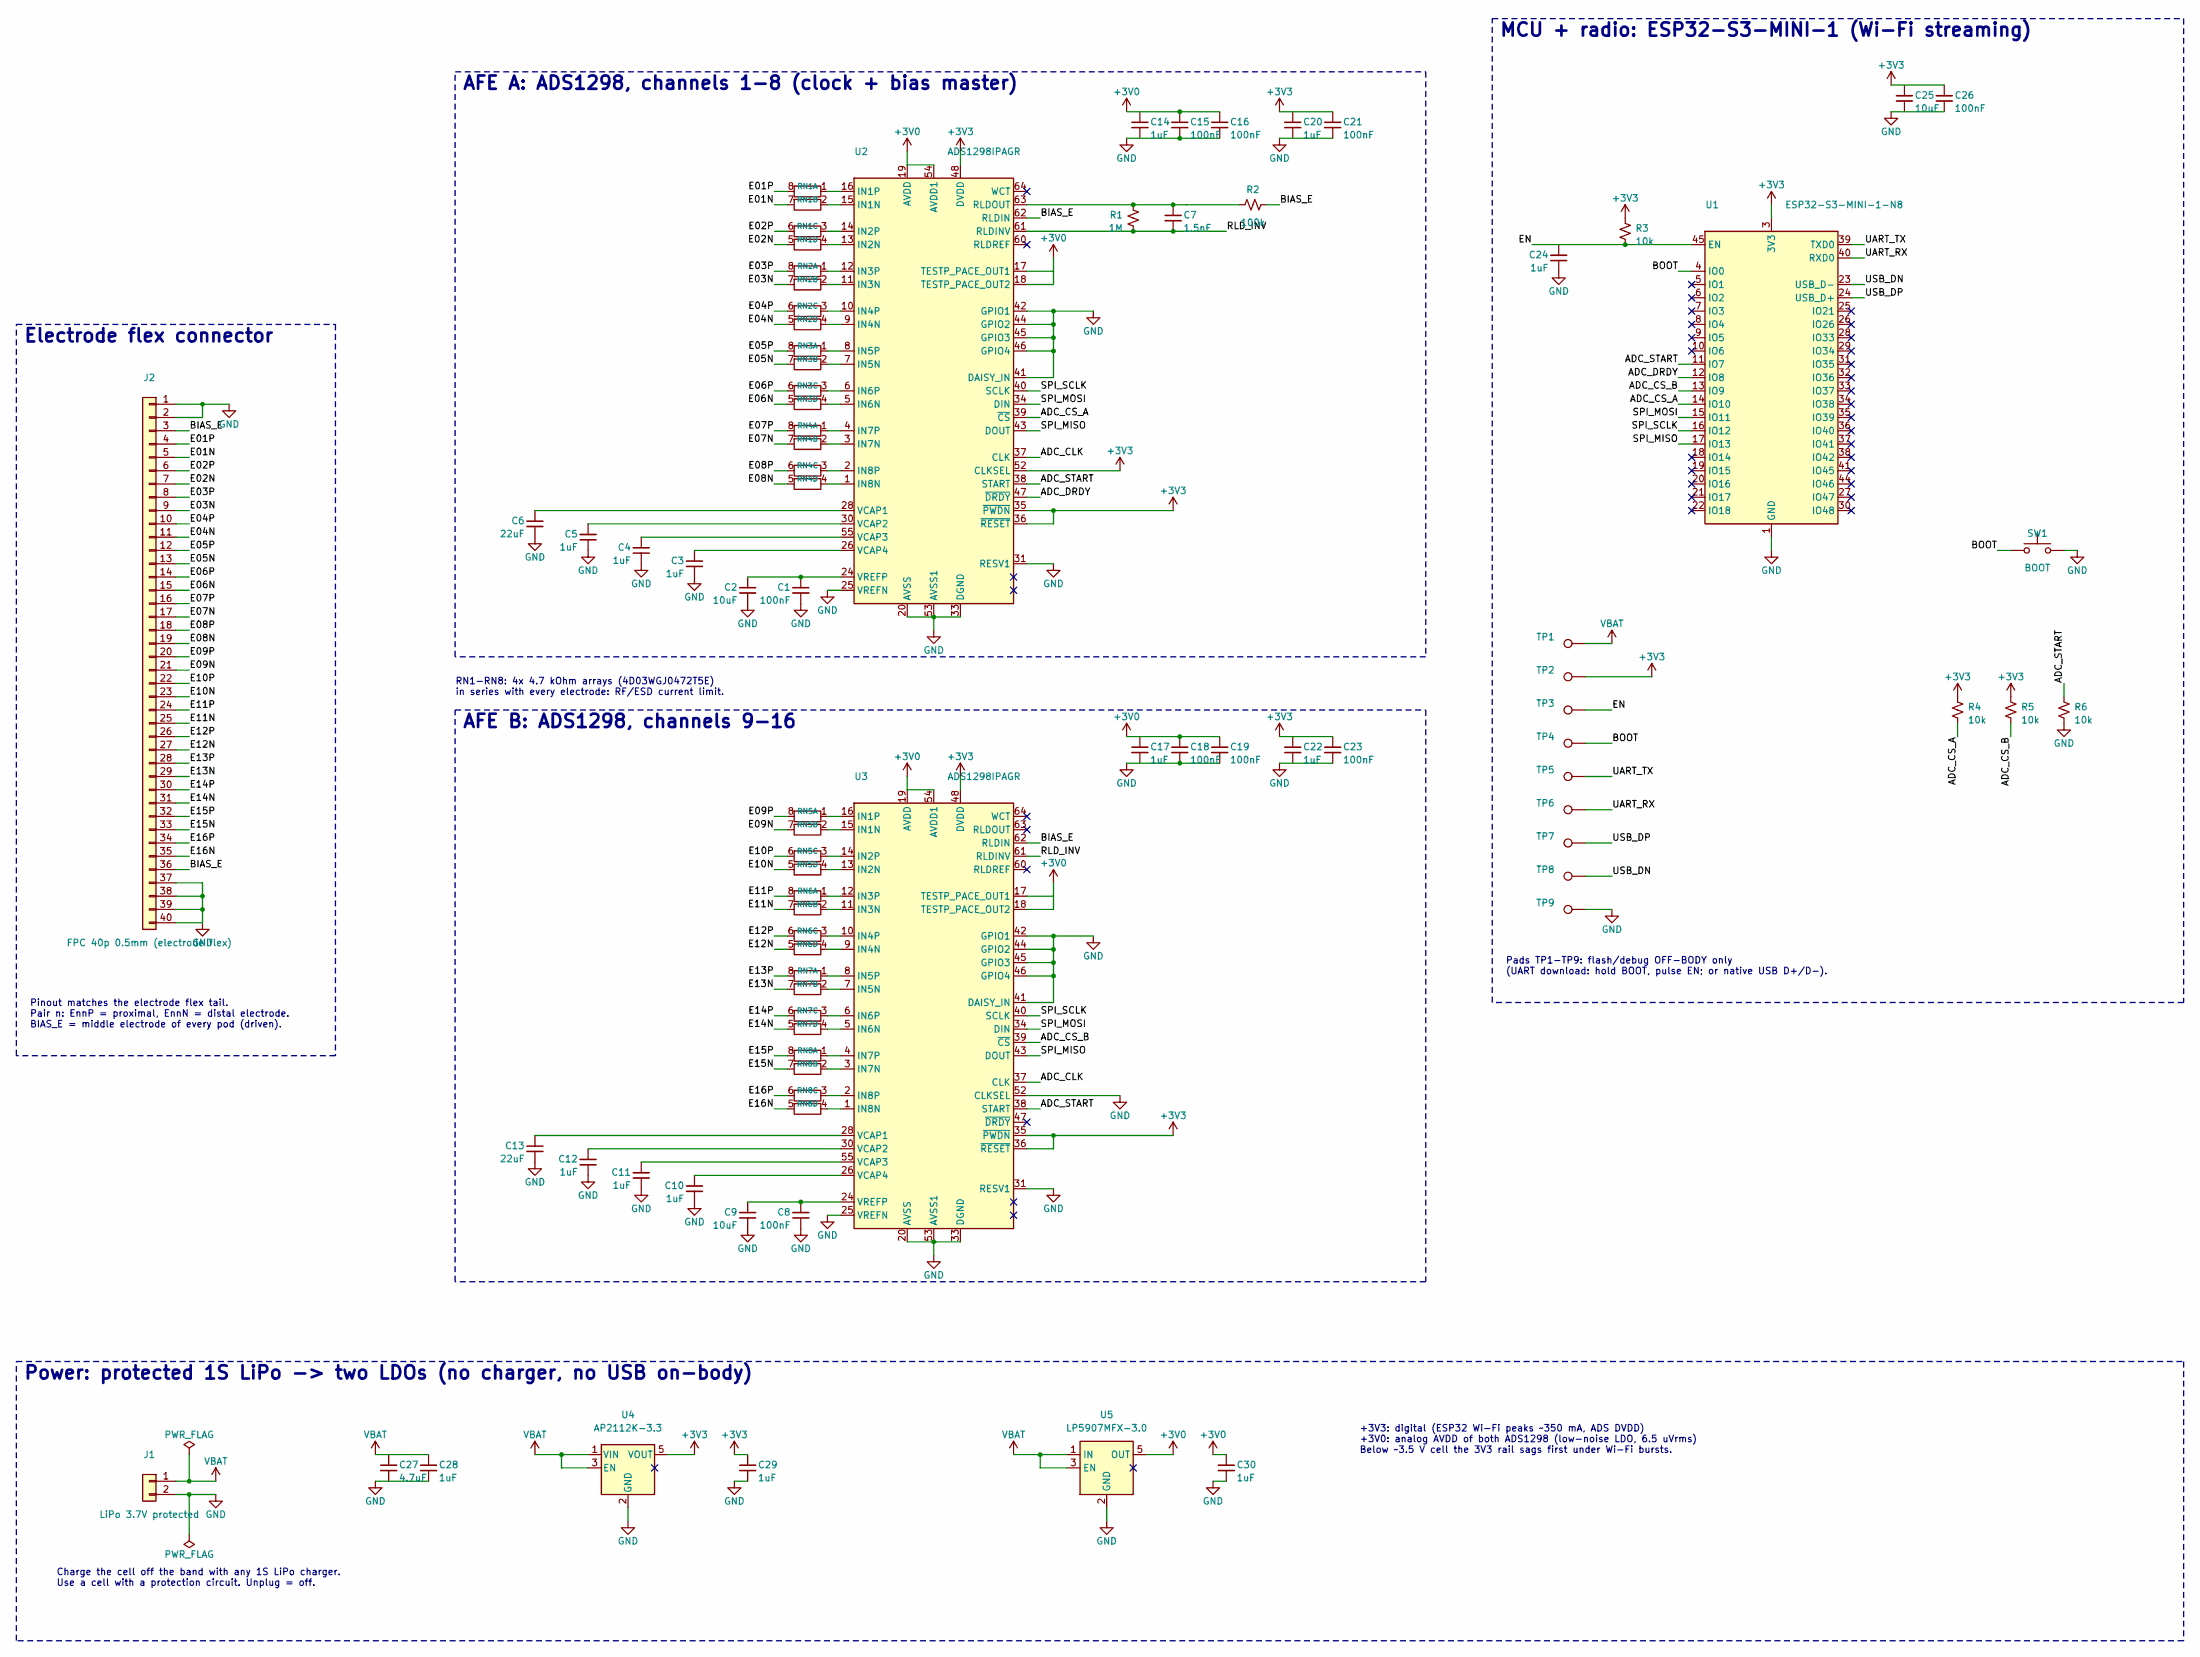
[picture p214: schematic neurband_main.kicad_sch, neurband main board: 16-ch sEMG front-end + ESP32-S3]

Parts:
C1, C8, C15, C16, C18, C19, C21, C23, C26: 100nF; C_0402_1005Metric; MPN CL05B104KO5NNNC; LCSC C1525
C2, C9, C25: 10uF; C_0603_1608Metric; MPN CL10A106KP8NNNC; LCSC C19702
C3, C4, C5, C10, C11, C12, C14, C17, C20, C22, C24, C28, C29, C30: 1uF; C_0402_1005Metric; MPN CL05A105KA5NQNC; LCSC C52923
C6, C13: 22uF; C_0603_1608Metric; MPN CL10A226MQ8NRNC; LCSC C59461
C7: 1.5nF; C_0402_1005Metric; MPN CC0402KRX7R9BB152; LCSC C107022
C27: 4.7uF; C_0603_1608Metric; MPN CL10A475KO8NNNC; LCSC C19666
J1: LiPo 3.7V protected; JST_SH_SM02B-SRSS-TB_1x02-1MP_P1.00mm_Horizontal; MPN SM02B-SRSS-TB(LF)(SN); LCSC C160402
J2: FPC 40p 0.5mm (electrode flex); HCTL_HC-FPC-05-09-40RLTAG_1x40-1MP_P0.50mm_Horizontal; MPN HC-FPC-05-09-40RLTAG; LCSC C5213762
R1: 1M; R_0402_1005Metric; MPN 0402WGF1004TCE; LCSC C26083
R2: 100k; R_0402_1005Metric; MPN 0402WGF1003TCE; LCSC C25741
R3, R4, R5, R6: 10k; R_0402_1005Metric; MPN 0402WGF1002TCE; LCSC C25744
RN1, RN2, RN3, RN4, RN5, RN6, RN7, RN8: 4.7k; R_Array_Convex_4x0603; MPN 4D03WGJ0472T5E; LCSC C1980
SW1: BOOT; SW_SPST_TS-1088-xR020; MPN TS-1088-AR02016; LCSC C720477
TP1, TP2, TP3, TP4, TP5, TP6, TP7, TP8, TP9: pad; TestPoint_Pad_1.0x1.0mm
U1: ESP32-S3-MINI-1-N8; MPN ESP32-S3-MINI-1-N8; LCSC C2913206
U2, U3: ADS1298IPAGR; TQFP-64_10x10mm_P0.5mm; MPN ADS1298IPAGR; LCSC C527440
U4: AP2112K-3.3; SOT-23-5; MPN AP2112K-3.3TRG1; LCSC C51118
U5: LP5907MFX-3.0; SOT-23-5; MPN LP5907MFX-3.0/NOPB; LCSC C475492

Connections:
+3V0: C14.1, C15.1, C16.1, C17.1, C18.1, C19.1, C30.1, U2.17 (TESTP_PACE_OUT1), U2.18 (TESTP_PACE_OUT2), U2.19 (AVDD), U2.21 (AVDD), U2.22 (AVDD), U2.54 (AVDD1), U2.56 (AVDD), U2.59 (AVDD), U3.17 (TESTP_PACE_OUT1), U3.18 (TESTP_PACE_OUT2), U3.19 (AVDD), U3.21 (AVDD), U3.22 (AVDD), U3.54 (AVDD1), U3.56 (AVDD), U3.59 (AVDD), U5.5 (OUT)
+3V3: C20.1, C21.1, C22.1, C23.1, C25.1, C26.1, C29.1, R3.1, R4.1, R5.1, TP2.1 (1_1), U1.3 (3V3), U2.35 (~PWDN), U2.36 (~RESET), U2.48 (DVDD), U2.50 (DVDD), U2.52 (CLKSEL), U3.35 (~PWDN), U3.36 (~RESET), U3.48 (DVDD), U3.50 (DVDD), U4.5 (VOUT)
/ADC_CLK: U2.37 (CLK), U3.37 (CLK)
/ADC_CS_A: R4.2, U1.14 (IO10), U2.39 (~CS)
/ADC_CS_B: R5.2, U1.13 (IO9), U3.39 (~CS)
/ADC_DRDY: U1.12 (IO8), U2.47 (~DRDY)
/ADC_START: R6.1, U1.11 (IO7), U2.38 (START), U3.38 (START)
/BIAS_E: J2.3, J2.36, R2.2, U2.62 (RLDIN), U3.62 (RLDIN)
/BOOT: SW1.1, TP4.1 (1_1), U1.4 (IO0)
/E01N: J2.5, RN1.7 (R2.2)
/E01P: J2.4, RN1.8 (R1.2)
/E02N: J2.7, RN1.5 (R4.2)
/E02P: J2.6, RN1.6 (R3.2)
/E03N: J2.9, RN2.7 (R2.2)
/E03P: J2.8, RN2.8 (R1.2)
/E04N: J2.11, RN2.5 (R4.2)
/E04P: J2.10, RN2.6 (R3.2)
/E05N: J2.13, RN3.7 (R2.2)
/E05P: J2.12, RN3.8 (R1.2)
/E06N: J2.15, RN3.5 (R4.2)
/E06P: J2.14, RN3.6 (R3.2)
/E07N: J2.17, RN4.7 (R2.2)
/E07P: J2.16, RN4.8 (R1.2)
/E08N: J2.19, RN4.5 (R4.2)
/E08P: J2.18, RN4.6 (R3.2)
/E09N: J2.21, RN5.7 (R2.2)
/E09P: J2.20, RN5.8 (R1.2)
/E10N: J2.23, RN5.5 (R4.2)
/E10P: J2.22, RN5.6 (R3.2)
/E11N: J2.25, RN6.7 (R2.2)
/E11P: J2.24, RN6.8 (R1.2)
/E12N: J2.27, RN6.5 (R4.2)
/E12P: J2.26, RN6.6 (R3.2)
/E13N: J2.29, RN7.7 (R2.2)
/E13P: J2.28, RN7.8 (R1.2)
/E14N: J2.31, RN7.5 (R4.2)
/E14P: J2.30, RN7.6 (R3.2)
/E15N: J2.33, RN8.7 (R2.2)
/E15P: J2.32, RN8.8 (R1.2)
/E16N: J2.35, RN8.5 (R4.2)
/E16P: J2.34, RN8.6 (R3.2)
/EN: C24.1, R3.2, TP3.1 (1_1), U1.45 (EN)
/RLD_INV: C7.2, R1.2, U2.61 (RLDINV), U3.61 (RLDINV)
/SPI_MISO: U1.17 (IO13), U2.43 (DOUT), U3.43 (DOUT)
/SPI_MOSI: U1.15 (IO11), U2.34 (DIN), U3.34 (DIN)
/SPI_SCLK: U1.16 (IO12), U2.40 (SCLK), U3.40 (SCLK)
/UART_RX: TP6.1 (1_1), U1.40 (RXD0)
/UART_TX: TP5.1 (1_1), U1.39 (TXD0)
/USB_DN: TP8.1 (1_1), U1.23 (USB_D-)
/USB_DP: TP7.1 (1_1), U1.24 (USB_D+)
GND: C1.2, C2.2, C3.2, C4.2, C5.2, C6.2, C8.2, C9.2, C10.2, C11.2, C12.2, C13.2, C14.2, C15.2, C16.2, C17.2, C18.2, C19.2, C20.2, C21.2, C22.2, C23.2, C24.2, C25.2, C26.2, C27.2, C28.2, C29.2, C30.2, J1.2, J2.1, J2.2, J2.37, J2.38, J2.39, J2.40, R6.2, SW1.2, TP9.1 (1_1), U1.1 (GND), U1.2 (GND), U1.42 (GND), U1.43 (GND), U1.46 (GND), U1.47 (GND), U1.48 (GND), U1.49 (GND), U1.50 (GND), U1.51 (GND), U1.52 (GND), U1.53 (GND), U1.54 (GND), U1.55 (GND), U1.56 (GND), U1.57 (GND), U1.58 (GND), U1.59 (GND), U1.60 (GND), U1.61 (GND), U1.62 (GND), U1.63 (GND), U1.64 (GND), U1.65 (GND), U2.20 (AVSS), U2.23 (AVSS), U2.25 (VREFN), U2.31 (RESV1), U2.32 (AVSS), U2.33 (DGND), U2.41 (DAISY_IN), U2.42 (GPIO1), U2.44 (GPIO2), U2.45 (GPIO3), U2.46 (GPIO4), U2.49 (DGND), U2.51 (DGND), U2.53 (AVSS1), U2.57 (AVSS), U2.58 (AVSS), U3.20 (AVSS), U3.23 (AVSS), U3.25 (VREFN), U3.31 (RESV1), U3.32 (AVSS), U3.33 (DGND), U3.41 (DAISY_IN), U3.42 (GPIO1), U3.44 (GPIO2), U3.45 (GPIO3), U3.46 (GPIO4), U3.49 (DGND), U3.51 (DGND), U3.52 (CLKSEL), U3.53 (AVSS1), U3.57 (AVSS), U3.58 (AVSS), U4.2 (GND), U5.2 (GND)
unnamed: RN1.1 (R1.1), U2.16 (IN1P)
unnamed: RN1.2 (R2.1), U2.15 (IN1N)
unnamed: RN1.3 (R3.1), U2.14 (IN2P)
unnamed: RN1.4 (R4.1), U2.13 (IN2N)
unnamed: RN2.1 (R1.1), U2.12 (IN3P)
unnamed: RN2.2 (R2.1), U2.11 (IN3N)
unnamed: RN2.3 (R3.1), U2.10 (IN4P)
unnamed: RN2.4 (R4.1), U2.9 (IN4N)
unnamed: RN3.1 (R1.1), U2.8 (IN5P)
unnamed: RN3.2 (R2.1), U2.7 (IN5N)
unnamed: RN3.3 (R3.1), U2.6 (IN6P)
unnamed: RN3.4 (R4.1), U2.5 (IN6N)
unnamed: RN4.1 (R1.1), U2.4 (IN7P)
unnamed: RN4.2 (R2.1), U2.3 (IN7N)
unnamed: RN4.3 (R3.1), U2.2 (IN8P)
unnamed: RN4.4 (R4.1), U2.1 (IN8N)
unnamed: RN5.1 (R1.1), U3.16 (IN1P)
unnamed: RN5.2 (R2.1), U3.15 (IN1N)
unnamed: RN5.3 (R3.1), U3.14 (IN2P)
unnamed: RN5.4 (R4.1), U3.13 (IN2N)
unnamed: RN6.1 (R1.1), U3.12 (IN3P)
unnamed: RN6.2 (R2.1), U3.11 (IN3N)
unnamed: RN6.3 (R3.1), U3.10 (IN4P)
unnamed: RN6.4 (R4.1), U3.9 (IN4N)
unnamed: RN7.1 (R1.1), U3.8 (IN5P)
unnamed: RN7.2 (R2.1), U3.7 (IN5N)
unnamed: RN7.3 (R3.1), U3.6 (IN6P)
unnamed: RN7.4 (R4.1), U3.5 (IN6N)
unnamed: RN8.1 (R1.1), U3.4 (IN7P)
unnamed: RN8.2 (R2.1), U3.3 (IN7N)
unnamed: RN8.3 (R3.1), U3.2 (IN8P)
unnamed: RN8.4 (R4.1), U3.1 (IN8N)
unnamed: C7.1, R1.1, R2.1, U2.63 (RLDOUT)
unnamed: C6.1, U2.28 (VCAP1)
unnamed: C5.1, U2.30 (VCAP2)
unnamed: C4.1, U2.55 (VCAP3)
unnamed: C3.1, U2.26 (VCAP4)
unnamed: C1.1, C2.1, U2.24 (VREFP)
unnamed: C13.1, U3.28 (VCAP1)
unnamed: C12.1, U3.30 (VCAP2)
unnamed: C11.1, U3.55 (VCAP3)
unnamed: C10.1, U3.26 (VCAP4)
unnamed: C8.1, C9.1, U3.24 (VREFP)
VBAT: C27.1, C28.1, J1.1, TP1.1 (1_1), U4.1 (VIN), U4.3 (EN), U5.1 (IN), U5.3 (EN)

Notes on the sheet:
Electrode flex connector
Pinout matches the electrode flex tail. Pair n: EnnP = proximal, EnnN = distal electrode. BIAS_E = middle electrode of every pod (driven).
RN1-RN8: 4x 4.7 kOhm arrays (4D03WGJ0472T5E) in series with every electrode: RF/ESD current limit.
AFE A: ADS1298, channels 1-8 (clock + bias master)
AFE B: ADS1298, channels 9-16
Pads TP1-TP9: flash/debug OFF-BODY only (UART download: hold BOOT, pulse EN; or native USB D+/D-).
MCU + radio: ESP32-S3-MINI-1 (Wi-Fi streaming)
Charge the cell off the band with any 1S LiPo charger. Use a cell with a protection circuit. Unplug = off.
+3V3: digital (ESP32 Wi-Fi peaks ~350 mA, ADS DVDD) +3V0: analog AVDD of both ADS1298 (low-noise LDO, 6.5 uVrms) Below ~3.5 V cell the 3V3 rail sags first under Wi-Fi bursts.
Power: protected 1S LiPo -> two LDOs (no charger, no USB on-body)

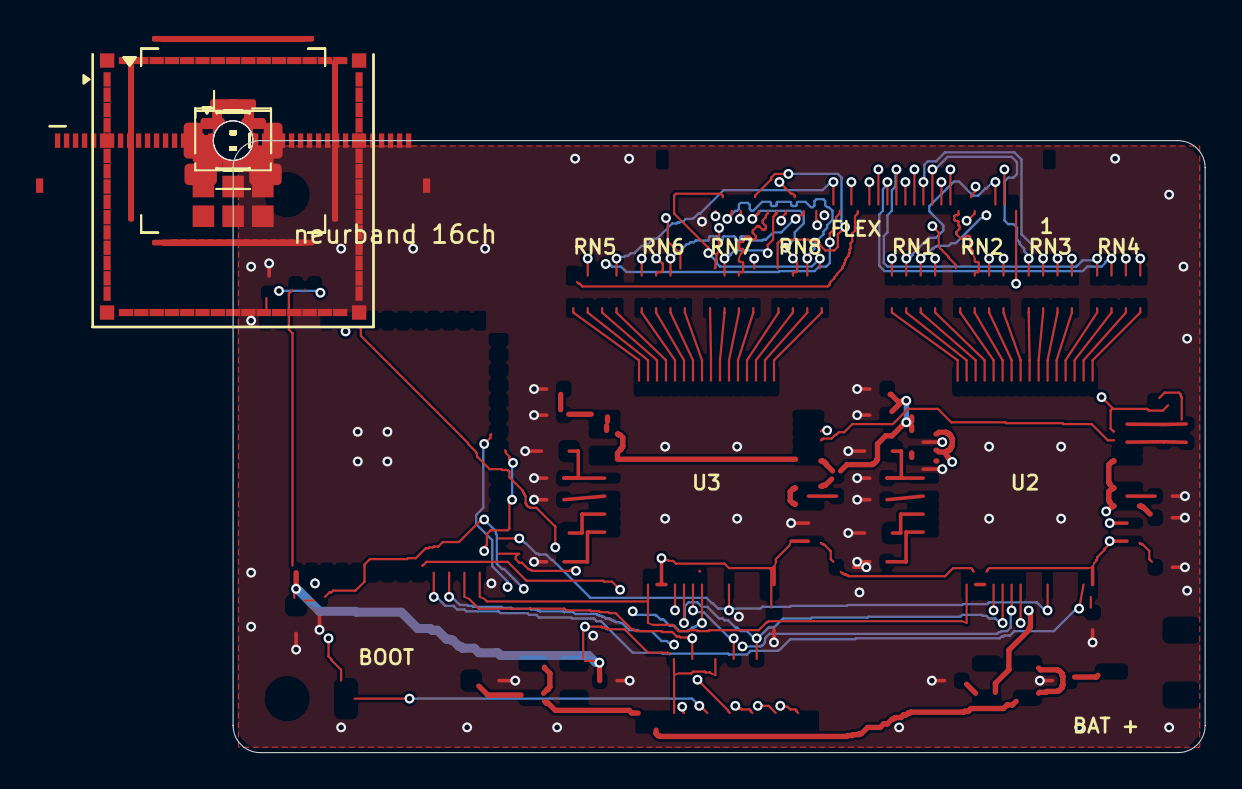
[picture p215: board neurband_main.kicad_pcb from above]

Board: 4 copper layers, 54.0 x 34.0 mm, 63 parts (0 on the bottom side), 95 nets.

Other parts of the board:
H1, H2: M2; MountingHole_2.2mm_M2
