jlcjak/neurband/(commit log)

2026-10-26 neurband: open minimal sEMG wristband (rev C design, rev A/B archive)
    Rev C: 8-channel ADS1298 + nRF52832 BLE band core (28.7 x 27 mm, 4 layers,
    one-sided assembly), 8-pod electrode flex, 3D-printed module/pods/strap,
    Zephyr firmware, BLE recorder, analysis pipeline, circuit + forearm
    volume-conductor simulations and science reviews.
    Rev A/B (16-channel ESP32 iterations) kept under archive/.
    [ESP32-C3-MINI-1.step, ESP32-S3-MINI-1-N8.step, HCTL_HC-FPC-05-09-40RLTAG.step, NRF52832_QFAA.step, XUNPU_FPC-05F-20PH20.step, band_assembly.step, button_cap.step, charge_puck.step]
2026-10-26 Final rev C renders, README media, mechanical refinements
    [band_assembly.step, strap_loop.step]
2026-10-26 firmware_c: real ARM build (Zephyr 4.4.2), status buffer fix, build docs
    [app.h, ble.c, main.c]
2026-10-26 Manufacturing review fixes: flex silkscreen 0.15 mm, printed walls >= 1 mm; final renders and BOM
    [band_assembly.step, button_cap.step, charge_puck.step, module_assy.step, module_base.step, module_lid.step, neurband_c_bom.csv, neurband_c_flex.kicad_pcb]
2026-10-26 docs: strap is 22 mm webbing
2026-10-26 README: describe it as like the Meta Neural Band, move the prototype cost down; add four-layer copper view; 16:9 social render mode
2026-10-29 Rev C pre-order rework: analog/RF/DFM fixes, assembly guide and animation
    Main board (re-laid out by the layout owner after independent pre-order reviews):
    - digital lines (I2C, IMU_INT) moved out of the electrode input field; worst
    coupling 0.89 fF, injected noise <= 0.057 uVrms, P/N mismatch <= 0.71 pF
    - local regulator output loop, local ADS/nRF bypassing, C33 at AVDD1, 0603 bulk caps
    - RLDIN behind the 100k bias resistor, 10k input arrays (ESD), 12 pF bias RF shunt
    - nine tented GND vias in the nRF exposed pad, stitching <= 3 mm in RF/AFE
    - footprints carry the fab's 0 deg so the raw position file is correct;
    pin-1/cathode silkscreen, thermal reliefs, 0.5 mm edge pour setback
    - DRC 0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
    [aggressor_inband.csv, aggressor_inband_rework3313.csv, aggressor_inband_rework_origstack.csv, band_assembly.step, button_cap.step, coupling_pairs.csv, coupling_pairs_rework3313.csv, coupling_pairs_rework_origstack.csv]
2026-10-29 Tidy folders: boards/ and mech/ hold only rev C; old work moved to archive/
    - rev A/B mechanics: mech/ -> archive/mech_revAB/
    - rev C one-off layout scripts: boards/neurband_c/layout/ -> archive/neurband_c_layout_scripts/
    - one current boards/neurband_c/renders/ (the stale copy removed)
    - READMEs in boards/neurband_c, boards/neurband_c_flex, mech and archive explaining each file
    - doc links repointed to the archive; local-only backups kept in archive/local/ (gitignored)
    [electrode_flex_L.step, electrode_flex_M.step, electrode_flex_S.step, electrode_flex_XL.step, housing_base.step, housing_lid.step, pod_shell.step, strap_L.step]
2026-10-29 Rename archive/ to .archive/ so Backplane's project and part lists skip the old revisions
    [ESP32-C3-MINI-1.step, ESP32-S3-MINI-1-N8.step, HCTL_HC-FPC-05-09-40RLTAG.step, electrode_flex_L.step, electrode_flex_M.step, electrode_flex_S.step, electrode_flex_XL.step, housing_base.step]
2026-10-29 Simpler build: no-sew slip-on strap, foam dots, clip charger, jigs; new build guide
    Mechanics (board and flex interface unchanged):
    - strap: one closed loop of plain 20 x 1.5 mm elastic, anchored by two printed
    slides that clip onto the module's hidden bars; self-locking path (the pull
    pinches the tail); no sewing, no hook-and-loop; slides swing into line with the band
    - pods: pockets for pre-cut 6 x 2 mm double-sided foam dots, no pins; printed
    bonding jig aligns the flex and all pods (no punch, no needles)
    - charger: printed snap-on clip with two P50 pogo pins; no magnets
    - open LED hole (no light pipe); cell held by lid ribs (401223-class, 401120 fallback
    with a spacer); cell lead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
    [band_assembly.step, bond_jig.step, bond_jig_fit.step, button_cap.step, cell_spacer.step, charge_clip.step, charge_clip_fit.step, charge_puck.step]
2026-10-29 Visual assembly manual: 28 step figures and a printable PDF
    docs/build/assembly.md restructured into a full manual (kit of parts, names and
    directions, exploded overview, pod cross-section, then steps 1-9). Each step figure
    shows the part being added highlighted, the assembled context ghosted, travel
    arrows and close-up insets at the critical interfaces (SWD pins, cell leads, flex
    on the bonding jig, pods into fences, tail into J1, book-fold, lead route, lid snaps,
    slides on the hidden bars, the webbing lock, threading order, charge clip).
    Figures regenerate from the CAD with render/guide_figures.py, with an automatic
    label/leader overlap check. PDF: docs/build/neurband_build_manual.pdf (A4)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
2026-10-29 Final pre-order schematic reviews (two independent): no board- or feature-killers
2026-11-01 Rev C main board: owner's new routing, small passives, silkscreen with logos
    - Main board re-routed by the owner (0 unconnected, 0 parity). The routed and reviewed
    previous layout is kept as boards/neurband_c_old for reference.
    - All 0402/0603 R, C and L footprints swapped for the smaller project-local lands in
    layout/neurband.pretty (models in layout/models); layout/swap_passives_small.py.
    - AFE-side input nets named IN1P..IN8N so KiCad pairs them for differential routing.
    - VBAT_SENSE moved to P0.28/AIN4 (U1 pin 40), IMU_INT to P0.31 (U1 pin 43); firmware
    overlay and pin table updated.
    - Silkscreen rebuilt: pin-1 dots, D1 cathode bar, cell outline marks, SWD pad labels,
    battery and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
    [C_01005_0402Metric.step, C_0201_0603Metric.step, C_0402_1005Metric.step, C_0603_1608Metric.step, C_0805_2012Metric.step, L_01005_0402Metric.step, L_0201_0603Metric.step, L_0402_1005Metric.step]
2026-11-01 README: board renders and copper-layer figure from the new rev C layout
2026-11-01 README: new file names for the board images so GitHub shows the updated ones
2026-11-01 Electrode flex rev C.2: straight explicit routing, planar fan-in; pod channel map; layout review
    - Flex routing placed explicitly in straight 0/45/90 segments (no grid router): 217 segments, 52 vias.
    flex_pinmap.py lands each pod on whichever J1 pair keeps the root fan-in planar.
    - Flex reliability: no vias in bend zones, no copper stacked across bends, 0.2 mm necks at vias and
    electrode exits, 0.2 mm tail lines, 0.6/0.3 vias, coverlay captures the electrodes (6.3 mm openings),
    no ground hatch behind the P/N skin discs. DRC/ERC/parity 0.
    - Host maps ADS channels to pods (POD_MAP, to_pods): pod 1..8 as V(proximal) - V(distal).
    - BOM CSV regenerated (C9/C31 1 uF per the owner's schematic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
    [neurband_c_bom.csv, neurband_c_flex.kicad_pcb, neurband_c_flex.kicad_sch, neurband_c_flex.step]
2026-11-01 Mechanics r2: thick integral strap bars, buyable hook-and-loop strap, magnetic charging, sleeker case
    - Strap anchor: the 1.3 x 1.6 mm moulded bar, snap-on slides and friction bar are gone. Each base end has a
    4.6 x 7.2 mm integral bar behind a 20-degree slot; bar B is the tightening end (hook end folds back onto
    the loop panel), bar A a set-once pinch lock. At 100 N band pull: bar B 22.8 MPa nominal (safety 1.9),
    bar A 16.4 MPa (2.6); the hook-and-loop slips (42-103 N) before any bar can break.
    - Strap: one-piece 20 mm hook-and-loop watch strap (size L) with a fallback; pods snap onto it.
    - Charging: 2-pin magnetic pogo connector glued in the elbow-end wall, wired to J3. SWD by five s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
    [band_assembly.step, base_jig.step, base_jig_fit.step, bond_jig.step, bond_jig_fit.step, button_cap.step, cell_spacer.step, module_assy.step]
2026-11-01 Manual and renders for r2: every step figure redrawn, PDF rebuilt, README renders; sleeker pods
    - 26 step figures for the r2 build (SWD wires, J3 wires, two-stage bonding, connector bay, strap lock and
    fold); old slide/clip/SWD-jig figures removed; PDF rebuilt (34 pages).
    - New README renders: turntable, hero, flatlay, pods inside, PCB (new silkscreen), flex detail (rev C.2).
    - Pods: smooth domed ends instead of the barbed crest; snap overlap and 1.0 mm lips unchanged.
    - Guide and sourcing: re-flashing is through the five SWD wires; Bluetooth updates are planned, not yet in
    the firmware.
    - Main board fab.json: routed by the owner, on hold until the review fixes.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
    [band_assembly.step, bond_jig.step, bond_jig_fit.step, pod.step, pod_with_flex.step]
2026-11-01 Review: bigger-picture risks (charging while worn with the magnetic connector, re-flash, pod 5 pressure)
2026-11-01 r2 assembly animation; four SWD wires (NRST optional); README links the PDF and the new animation
2026-11-01 Main board: U1 EP paste around the 13 vias, C21 grounded through VSS31, 0.13 mm mask web rule
    Owner's latest layout (C1/C2/C6/C27 moved, C35 and a +3V3A pour on the right-side AVDD pins).
    U1 exposed pad: 16 symmetric paste windows, 52.7 % of the pad, >= 0.127 mm from every via land
    (board and library footprint). C21 back at -90 deg so its ground returns only through VSS pin 31
    (Nordic reference); the via at (5.33, 4.50) removed. Solder mask web minimum 0.13 mm (black mask).
    BOM regenerated (C35); review status table.
    [neurband_c.kicad_pcb, neurband_c.kicad_sch, neurband_c_bom.csv]
2026-11-02 Order-ready: antenna match on the wrist, cleaner flex ground, neutral passive footprint names
    Main board: L2 = 5.1 nH series (was R3, 0 ohm) and C23 = 0.5 pF shunt, from a fresh openEMS run
    on the owner's board (worn worst-in-band -0.8 dB vs -3.0 dB through). Owner's stitching and
    decoupling edits; BOM regenerated. Ordered as OSP, green, JLC04101H-3313, 2 of 5 assembled.
    Flex: one continuous 0.30 mm ground return per pod with a short F-side bridge over the P line,
    one hatch per pod, no slivers; 50 vias. DRC/parity 0 on both boards.
    Passive footprints renamed to plain *_Small names.
    [aggressor_inband_owner1102.csv, coupling_pairs_owner1102.csv, inject_per_channel_owner1102.csv, inject_summary_owner1102.csv, neurband_c.kicad_pcb, neurband_c.kicad_sch, neurband_c_bom.csv, neurband_c_flex.kicad_pcb]
